hecaojuanjuan/gesture-bridge/artifacts/user-guide/gesture-bridge-user-guide-v2.png

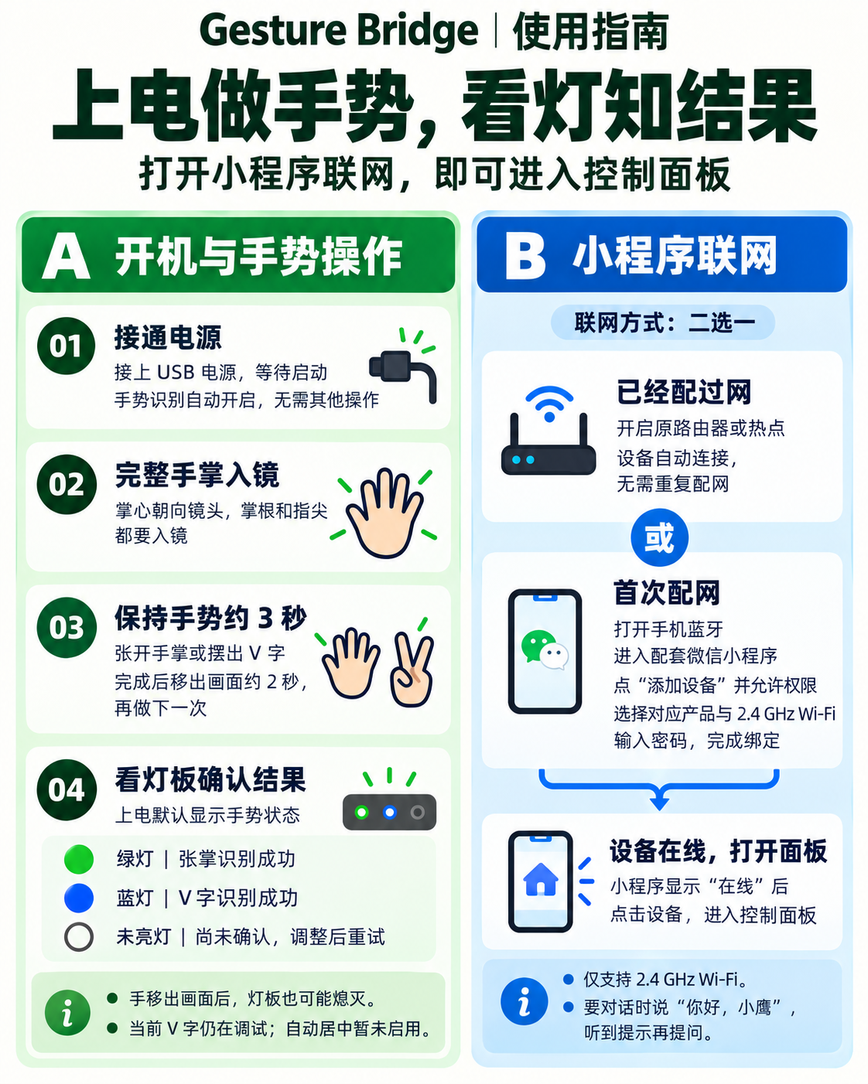
artifacts/user-guide/gesture-bridge-user-guide-v2.png
