hecaojuanjuan/gesture-bridge/artifacts/user-guide/device-startup-guide-20261101.png

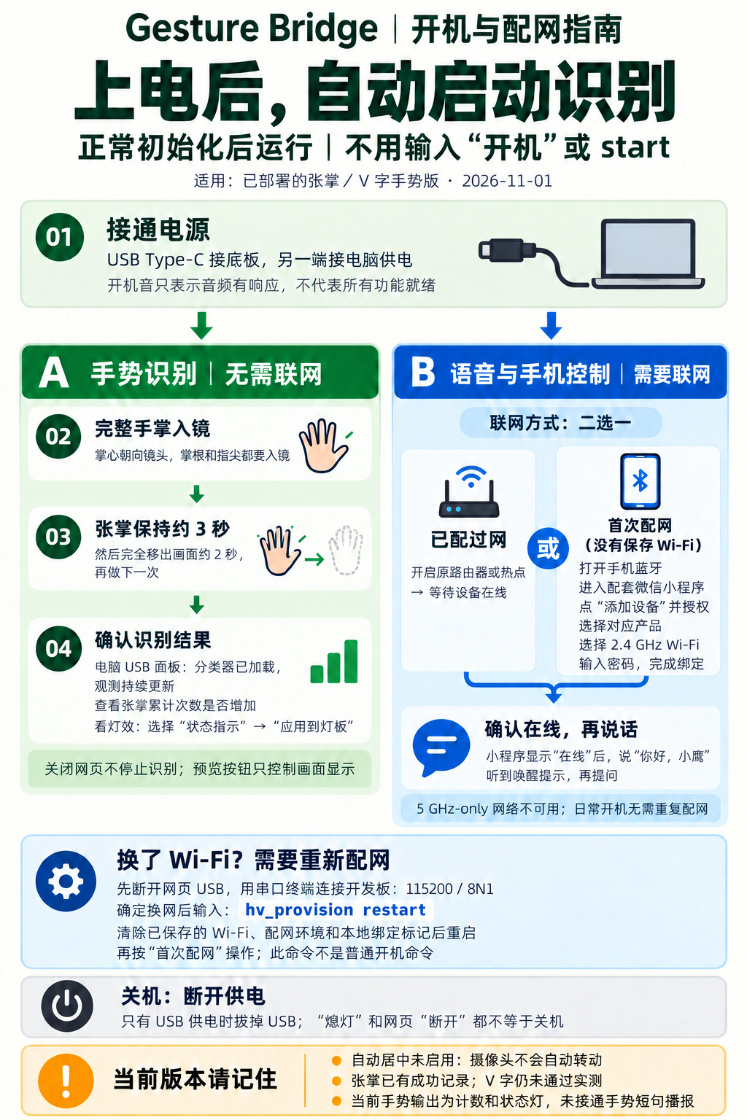
artifacts/user-guide/device-startup-guide-20261101.png
