hecaojuanjuan/gesture-bridge/tools/requirements-hand-training.txt

# Isolated Python 3.9 environment for the current hand-classifier pipeline.
# Keep NumPy below 2 for the Torch 1.12 NumPy ABI; do not change the IDF venv.
torch==1.12.0
numpy==1.26.4
Pillow==11.3.0
typing-extensions==4.16.0
