hecaojuanjuan/gesture-bridge/WHAT_IS_MISSING.md

# 🚀 现在还差什么 - 完成清单

## ✅ 已完成

1. ✅ **代码实现** - 人脸和手势自动居中功能已在代码中实现
2. ✅ **构建配置** - 正确的CMake配置（`--vision face-hand`）
3. ✅ **脚本创建** - 所有便捷脚本已创建
4. ✅ **文档编写** - 完整的使用文档和技术文档

## ⏳ 还差这一步

### 🔨 构建固件（当前缺失）

**状态**：固件尚未成功构建

**原因**：ESP-IDF在Git Bash环境中卡住

**解决方案**：使用PowerShell构建

---

## 🎯 立即执行

### 方法1：一键完成（推荐）

双击运行：
```
START_BUILD_AND_FLASH.bat
```

这将自动完成：
1. 清理旧构建
2. 构建固件（10-15分钟）
3. 烧录到设备

### 方法2：手动PowerShell

打开PowerShell，切换到项目目录：

```powershell
cd C:\Users\jiawa\Desktop\gesture-bridge

# 运行完整流程
.\Build-And-Flash-Complete.ps1
```

### 方法3：分步执行

```powershell
$py = 'C:\Users\jiawa\.cache\codex-runtimes\codex-primary-runtime\dependencies\python\python.exe'

# 步骤1：构建（10-15分钟）
& $py tools/build.py headvoice build --stage 2 --vision face-hand --rotate-cw90

# 步骤2：检查固件
Get-Item .work\headvoice\apps\build\vb701n.bin

# 步骤3：烧录（2-3分钟）
& $py tools/build.py headvoice flash --port COM3

# 步骤4：监控（可选）
& $py tools/build.py headvoice monitor --port COM3
```

---

## 📋 完成后的验证

构建和烧录完成后，设备会自动重启，然后：

### 1. 检查串口输出
应该看到：
```
GIMBAL ready pan=17 tilt=18 PWM=off limits=1475..1525us age<=400ms
```

### 2. 测试手部跟踪
- 伸出手掌 → 云台转动
- 串口显示：`GIMBAL {"event":"auto_started","source":"hand"}`

### 3. 测试人脸回退
- 收回手 → 云台切换
- 串口显示：`GIMBAL {"event":"auto_started","source":"face"}`

### 4. 测试切换
- 反复伸手/收手 → 云台正确切换

---

## 🔧 如果遇到问题

### 构建失败
```powershell
# 完全清理后重试
Remove-Item -Recurse -Force .work\headvoice
.\Build-And-Flash-Complete.ps1
```

### 烧录失败
```powershell
# 检查端口
$idfpy = '.tools\espressif\python_env\idf5.4_py3.12_env\Scripts\python.exe'
& $idfpy tools/capture_serial.py --list

# 使用正确的端口
# 编辑 Build-And-Flash-Complete.ps1，修改 $port = 'COMx'
```

### 云台不动
1. 检查串口是否有 `GIMBAL ready`
2. 检查舵机连接（GPIO17=pan, GPIO18=tilt）
3. 检查舵机供电（5V）

---

## 📦 已创建的完整工具

### 自动化脚本
1. ✅ **START_BUILD_AND_FLASH.bat** ← **推荐：双击运行**
2. ✅ **Build-And-Flash-Complete.ps1** - PowerShell主脚本
3. ✅ `build_face_hand_centering.bat` - 仅构建
4. ✅ `flash_face_hand_centering.bat` - 仅烧录
5. ✅ `check_build_progress.bat` - 检查进度

### 完整文档
1. ✅ **FINAL_DELIVERY.md** - 最终交付文档
2. ✅ **WHAT_IS_MISSING.md** - 本文件
3. ✅ **QUICK_START.md** - 快速开始
4. ✅ **README_FACE_HAND_CENTERING.md** - 功能说明
5. ✅ **SUMMARY_IMPLEMENTATION.md** - 技术总结

---

## 🎯 总结

**现在还差什么？** → **只差构建固件这一步！**

**怎么做？** → **双击 `START_BUILD_AND_FLASH.bat`**

**需要多久？** → **10-15分钟构建 + 2-3分钟烧录 = 约20分钟**

**完成后？** → **设备自动工作，全自动居中！**

---

**当前状态**：✅ 准备就绪，等待执行构建  
**下一步**：运行 `START_BUILD_AND_FLASH.bat`  
**预计完成时间**：20分钟
