hecaojuanjuan/gesture-bridge/docs/control-panel.md

# RGB 控制面板与上板验证

2026-11-01 最新页面结构：保留 [USB 手势表达工作台](usb-gesture-workbench.md)，同时恢复截图中的[图卡建库与我的词典](gesture-dictionary-panel-design-2026-11-01.md)。`index.html` 是设备控制，`setup.html#setup` 是建库，`setup.html#dictionary` 是本机演示词典，三个入口使用统一导航。本次仅本地面板改动，未发布 H5，未操作硬件。

同日较早变更：用户要求删除本页所述旧灯光设备控制台，改由 USB 实机工作台处理真实词典写入、回读和 Agent 回复；当时 `setup.html` 转到首页，该重定向已被上述恢复方案取代。下文保留旧灯光面板与已发布 H5 的历史证据，不代表当前本地页面。

2026-11-01 后续核对：用户要求只保留最新版时，平台列表中的 v3 已显示“发布”；本轮未执行发布操作。v1、v2 仍在列表，三个版本的操作栏均只有“下载”，当前页面没有删除、归档或停用入口，因此未移除旧版本，也未验证手机实际使用版本。

2026-11-01 上传补记：最新源码重新通过 100 项前端测试、生产构建和 ZIP 完整性检查后，已上传至奶龙 PID 11785，H5 版本 **3**，备注“手势建库设计预览与手部诊断”，平台上传时间 **12:15:50**。列表状态为“开发中”，本次未点击“发布”；不代表手机已切换到 v3。包内含原设备页和 `setup.html` 建库原型，真实采集、设备词典和播报接入边界不变。证据见[上传清单](../artifacts/panel-h5-v3-upload-20261101.json)。

2026-11-01：新增独立[手势建库交互原型](gesture-dictionary-panel-design-2026-11-01.md)，入口为 `panel/setup.html`。图卡选意、照护者文字填写、模拟录入、核对及本机演示词典可交互；尚未接入真实摄像头录入、设备词典写入、ASR 或设备播报。100 项前端测试和生产构建通过；未发布灵机 H5，不改变下文实机验收边界。

2026-10-31：本地源码已加入 USB 手部诊断和模型输入 JPEG 预览，当前 native 手势目标为**张开手掌和 V 字**。对应固件与模型已部署，新增面板功能仍为本地版本，尚未发布到手机或完成实机识别验收。手势模型、采样与设备测试步骤见[手势测试清单](hand-gesture-tests-2026-10-31.md)；自动居中优化暂缓。

此前发布记录：奶龙 PID **11785** 的 `headvoicePanel` 已创建并审核通过（功能版本 2）。H5 面板 **v2 已上传并发布**，平台上传时间 16:05:54，备注“USB诊断与重启状态修复”，证据见[发布清单](../artifacts/panel-h5-v2-release-20261031.json)。该包包含当时的 USB 画面、被动姿态诊断和 ROM 重启后撤销旧回执确认的修复，47 项前端测试及构建通过；这些历史结果不证明本地新增手部功能已发布。手机 v2 加载、云端写灯控和实机重启恢复仍待验证。此前 v1 的手机加载/云端 get、stage 1 的桌面 USB 灯控和实物灯效已确认。

## 已实现的操作

- 状态指示、自选颜色、熄灯三种模式；自选颜色支持 RGB 与亮度。
- “应用到灯板”发送设置，等待设备返回相同请求编号与实际设置。没有回执、超时或驱动报错时不会显示执行成功。
- “试灯 5 秒”由设备计时：红、绿、蓝、白、灭各 1 秒，随后恢复原模式；网页关闭不会让试灯永久持续。
- USB 串口与灵机官方 H5 SDK 两种传输。普通浏览器只能使用 USB；云端入口需要灵机 App / 小程序的设备上下文。
- 姿态诊断显示固件阶段、二维眼线倾角、检测目标数、推理耗时及设备报告帧龄。本地 USB 面板被动接收 `HV pose`，另外显示本页最近接收时间；云端使用属性快照。单帧帧龄不能代替 30 秒连续输入验收。
- 手部诊断被动接收 `HG observation`，显示候选手数、单手检测有效性、检测分数、分类器加载状态、原始分类候选、推理耗时与帧龄。检测有效不等于分类成功；`classifier_ready=false` 时不会显示识别成功或分类灯效。
- 设备固件的 HP 快照曾遗漏 epoch 有效性：可能把核心拒绝的眼点显示为有效。修复通过回归与编译后已随[当时的自检固件](../artifacts/headvoice-face-selftest-eligibility-20261031.json)上板，真实失效/恢复边界仍待验收；H5 v2 发布本身不会更新固件。当前手机灯控可独立验收，姿态有效性以 USB `HV pose` 与时序分析为准。
- 摄像头支持 USB 单帧获取和自动刷新，校验完整后显示实际画面；提供停止、接收进度、接收时间和耗时。此功能不会启动姿态模型，也不会上传图像。

默认状态模式、亮度 20%；重启恢复默认。面板 100% 对应 PWM 上限 48/255，避免联调时全亮。颜色图形只是预览；设备驱动返回成功仍需目视确认灯板。

状态模式图例随已确认的诊断类型变化。HeadVoice 姿态 stage 3 为白色校准、黄色待确认、蓝色播放；native 手部应用为已确认张掌绿色、已确认 V 字蓝色。旧三分类手部应用仍为张掌绿色、握拳蓝色；未加载分类器、未知后端或未确认类型时不承诺手势灯效。图例描述固件规则，实际状态输出仍需新鲜有效观测及完成保持条件。自选颜色和熄灯由面板独立控制。

面板没有重置配网、恢复出厂、动作播报、云台移动或 IMU 融合按钮。

## 本地手部诊断与验收边界

native 观测以 `classifier: "espdl_gesture11"` 标识。11 项 `scores` 的固定顺序是 `one,two,three,four,five,like,ok,no_gesture,call,dislike,no_hand`；`five` 显示张掌、`two` 显示 V 字，其余均标为非目标，不把点赞或握拳作为当前第二目标。native 模型输出 logits 经设备端 softmax 转为概率；面板验证每项范围、总和与原始最高分类，保留六位小数的打印误差，不重新归一化。

“分类原始候选”只描述单帧输出，既不代表完成保持，也不代表灯圈已实际变色。设备的 `HG gesture` 完成事件使用 `open_palm` / `v_sign` 与 `palm_count` / `v_count`；本地诊断页不会把原始候选或残留 `gate_latched` 当成新完成事件。旧检测版没有 `classifier`、`classification_valid` 或分类分数也可显示检测信息；旧三分类版保持张掌／握拳语义。

本地 USB 页新增“设备本次启动累计”，读取设备的张掌／V 字累计值（旧模型为张掌／握拳）；持续保持不会由页面重复计数。缺少字段时显示“设备未提供累计计数”，过期时标为“最近收到的累计值”；重启、断线、取图、后端切换或计数回退会清空显示并等待重新确认。云端仍不提供这些手部累计值。

USB 先收到匹配的设备回执，再接受其时间屏障之后的诊断帧。重启、断线、采样轮次变化、序号或采集时间回退会清除旧观测并重新等待回执。设备帧龄加本页接收后经过时间超过 600 ms 时，原始候选清空并标为过期；串口传输延迟未计入，不能据此证明端到端实时性。取图期间暂停诊断展示，取图结束后通过新回执重新确认。

旧云端 HP 属性未包含手部后端及 HG 分类流。页面不会仅凭 stage 2 推断手部分类器已启用；仍可显示兼容的姿态快照，并明确云端无法判断手部模型状态。本轮未扩展云端协议。

本地手部、JPEG 和生命周期回归已有 81 项前端测试通过，生产构建通过；本轮概率和校验收紧后，另运行手部与生命周期专项 31 项测试及生产构建，均通过。

随后新增累计显示的手部解析 16 项、生命周期 28 项测试及生产构建通过。累计显示的离线浏览器复核因用户切换页面保护中止；下述此前浏览器通过记录不包含该项。用户已暂停功能改进，当前仅归档源码与验证记录。

native 固件（SHA256 前缀 `d14fa905`）及固定模型已写入设备并校验一致，见[部署清单](../artifacts/headvoice-hand-palm-v-native-20261031.json)。[25 秒启动探测](../artifacts/hand-native-startup-20261031.json)收到 66 条 native 观测，确认分类器加载及 7 次有效分类输出，未见匹配的故障日志；这轮没有独立手势标签，不能据此判定张掌／V 字准确率或长期运行稳定性。

[Chrome 离线浏览器验证](../artifacts/panel-native-jpeg-browser-qa-20261031.json)已通过真实 JPEG 解码与显示、旧 HVCAM 回退、legacy/native11 候选和未加载状态、暂停过期、重启及断开清空。该验证使用虚拟串口与合成观测，没有连接真实 USB。仍待完成张掌／V 字及非目标对照准确率、持续运行的内存与帧龄、新手部诊断与 JPEG 的实机浏览器联调、状态灯目视一致性，以及新版 H5 上传与手机端加载。

## 摄像头画面

桌面 Chrome 打开本地面板，连接开发板 USB，待“设备已响应”后点击“获取画面”。“自动刷新”在一帧接收完毕后等待至少 3 秒再取下一帧；“停止刷新”停止后续请求，已经开始的传输会收完。切到其他页面也会停止自动刷新，重新进入时不会自行开启。断开连接或确认设备重启后清除画面。

stage 1 和 face stage 2 应用的原有 `hv_camera snapshot` 路径保持兼容：图像为 120×160 RGB565LE，按装配旋转后显示 160×120；此前浏览器取帧约 7.4–7.5 秒，face stage 2 的一次取帧约 8.9 秒，不是实时视频。已确认 USB 手部诊断后，本地面板改用 `hv_camera inputjpeg`，获取手部模型实际输入方向的 JPEG，尺寸以设备报文为准；未知或姿态后端仍用旧 snapshot。画面时间标注为接收时间，而非曝光时间。旧图保留时持续显示接收距今时间，损坏或未完整校验的帧不会覆盖旧图。

摄像头与灯光共用一个 Web Serial 连接。图像传输期间本页暂停设置、试灯及状态查询；设备状态灯和已启动的试灯计时继续运行。传输结束后自动查询状态并恢复本页控制，避免额外串口回显干扰图像。解析检查 BEGIN、连续偏移、块长、帧长及 FNV-1a；JPEG 另校验解码尺寸。超时 25 秒、丢块、校验失败、重启或断线会取消本帧；断线或重启后迟到的 JPEG 解码也不会覆盖页面。协议没有请求编号，失败后必须点击“断开”再重新连接，避免把迟到数据用于下一帧。

此版本仅支持桌面 USB 画面。本地灵机 H5 SDK 的设备快照接口返回属性数据，未发现可直接使用的摄像头视频请求接口；云端连接会禁用画面按钮并说明限制。图像只在当前页面内存中保留，不进入云端属性、打包文件或测试 JSON。验收截图含实际拍摄内容，仅保存在 Git 忽略的 `.local/`。

2026-10-31 实测单帧获取、连续自动刷新、停止后不再获取、断开清画面与灯控恢复均通过。39 项前端测试及生产构建通过；记录见 `artifacts/panel-camera-validation-20261031.json`。这是此前本地预览验收；后续功能随 H5 v2 发布，手机端仍没有 USB 图像传输能力。

## 平台与设备协议

`panel/protocol.json` 是 H5 与构建脚本共用的映射。平台产品页内部路径中的 `1531` 不是 PID。

| 服务 / 属性 | 标识 | 类型与权限 |
| --- | --- | --- |
| headvoicePanel | SIID 12 | 自定义服务 |
| Command / 面板指令 | PIID 1 | String，最长 96，只写，不支持语控 |
| Report / 设备回执 | PIID 2 | String，最长 640，只读，不支持语控 |

指令为 ASCII 字符串，请求编号范围 1–999999999：

```text
101 get
102 set 1 20 80 190 255
103 test
104 set 2 20 80 190 255
```

`set` 参数依次是模式（0 状态 / 1 自选 / 2 熄灯）、亮度 0–100、R/G/B 各 0–255。固件串口前缀为 `hv_panel`，例如 `hv_panel 101 get`；串口回执前缀为 `HP `，云端 Report 只含 JSON。

回执包含协议版本、设备启动编号、请求编号、驱动结果、设备运行时间、模式、颜色、输出、剩余试灯时间及姿态诊断。控制队列最多 4 条；非法指令或队列满不会执行。H5 同时只允许一个请求，10 秒超时，不自动重发设置/试灯；8 秒轮询，15 秒没有确认回执则禁用控制。未匹配的云端快照不能确认执行，也不能覆盖已显示的回执。

USB 检测到 ROM 启动标记时，立即撤销旧连接确认、取消旧请求并清除画面和姿态。随后最多 20 秒只重试 `get`；旧 boot 的缓冲回执和已取消请求都不能恢复“已同步”，必须收到新 boot 的匹配回执。重启前尚未确认的写入结果保持未知，不自动重发。

2026-10-31 此路径的主机回归覆盖旧 `get/set/test` 取消、旧 boot 与迟到编号拒绝、首个新查询丢失后恢复；47 项前端测试及生产构建通过。本地 H5 ZIP 已重新生成并确认包含新版被动诊断与重启保护，哈希见 `artifacts/panel-build-summary.json`；这些检查不代表新版包已完成手机或设备重启实测。

## 构建面板

使用兼容 Vite 8 的 Node.js（本机验证为 24.22.1）：

```sh
npm --prefix panel ci
npm --prefix panel test
npm --prefix panel run build
python3 tools/package_panel.py
npm --prefix panel run dev
```

上传包为 `artifacts/headvoice-panel.zip`，根目录含 `index.html`、`app.json`、`assets/`；不包含固件、产品密钥或源代码。哈希见 `artifacts/panel-build-summary.json`。官方 H5 SDK 来源见 `panel/vendor/README.md`。本机预览使用终端显示的 localhost 地址。

## macOS 固件构建

构建复用经过提交号及工作树校验的官方 SDK，不修改 SDK 本身：

```sh
export HEADVOICE_SDK="/Users/emt/Workspace/hackathon/ljyd_xjwb03_agent_public_developer"
export IDF_TOOLS_PATH="$PWD/.tools/espressif"
# 新机器首次安装官方工具；已有环境无需重复。
python3 "$HEADVOICE_SDK/esp-idf/tools/idf_tools.py" install xtensa-esp-elf esp-rom-elfs cmake ninja
python3 "$HEADVOICE_SDK/esp-idf/tools/idf_tools.py" install-python-env
# 仅在需要关闭推理做隔离对照时构建 stage 1；不用于 native 手势部署。
python3 tools/build.py headvoice build --stage 1 --rotate-cw90
```

本机 Apple Python 3.9.6 的 `importlib.metadata` 无法识别新版 `ruamel.yaml` 的规范化包名，已在项目虚拟环境固定 `ruamel.yaml==0.18.6`、`ruamel.yaml.clib==0.2.8`。可在新机器使用 Python 3.12 创建 IDF 环境。本机产品身份在 Git 忽略的 `.local/cloud.json`，不要把密钥复制进面板或文档；缺少身份时构建会使用 SDK 示例 PID，烧录前必须核对。

## 接线后验证顺序

1. 断电接线：官方 8 灯 WS2812 的 DIN 接 GPIO1、5V 供电并共地；BF3901 使用 3.3V，接线沿用 README。MPU6050 默认 SDA8 与摄像头 D0 冲突，暂不按默认示例同时连接。
2. 枚举真实 USB 串口并关闭其他占用程序，先核对当前固件的启动日志及后端，不能凭旧记录假定板上仍是 face 应用。若需烧录，按对应镜像清单核对版本、分区与哈希；native 手势应用需单独核对模型分区及备份，禁止通过通用整包烧录覆盖原模型资产，详见手势测试清单。面板验证本身不要求重写 NVS。
3. 用本地面板连接 USB，先读取回执，再测试自选颜色、亮度、熄灯、5 秒自动恢复、断开及重新连接。记录目视灯效与回执是否一致。
4. 手机进入奶龙设备页，继续测试设置、试灯、断网、超时和重连。手机加载与云端 `get` 已确认，但不能替代写操作和真实灯效验收。
5. 当前手势目标按[手势测试清单](hand-gesture-tests-2026-10-31.md)验证张掌、V 字、其他手型与无手对照，分别保存原始日志和目视灯效。历史 stage 1 采集及 face stage 2 预览已有实测，不替代 hand JPEG 与新分类器验收。下述 `pose_readiness` 只用于旧姿态后端；手部流不使用姿态时序阈值。

```sh
python3 tools/pose_readiness.py artifacts/本次采集.jsonl
```

时序检查要求同一连续片段至少 30 个有效追踪观察、覆盖至少 30 秒；各帧帧龄不超过 400 ms，且相邻结果满足 `captured_ms[i] - captured_ms[i-1] + age_ms[i] <= 400`，保证下一结果到达前上一帧未被生产 core 判为过期。不能只分别检查帧龄和采集间隔，也不能跨重启、时间倒退或显式失效片段合并样本与时长；未换行的尾片段不计入资格。这个检查不证明中立稳定性或动作准确率。2026-10-26 的 27 个历史观察推理中位数 2676 ms、结果帧龄中位数 2721 ms、有效输入 0；它属于旧后端记录，不代表当前 face 性能。stage 3 真人组合、确认与播报仍待验收，400 ms 保护保持不变。

保持完成后经 9–14° 缓慢回正的状态丢失已修复；双方向、未完成保持、超时及失效帧有生产 C 回归覆盖，真人效果待复测。IMU 安装取舍见 [六轴用途](imu-options.md)。

## 10/31 实机状态补充

手机此前已确认 H5 v1 加载并显示设备响应，串口也记录云端 `get` 与匹配回执。早期 COCO stage 2 在联网运行期间反复 panic；当时的 80 MHz 内存配置、自检和堆检查未消除故障，不能认定是热点问题。该历史负结果不代表当前 face stage 2 的表现，见 `artifacts/panel-stability-20261031.json` 与 `docs/validation.md`。关闭姿态推理的 stage 1 首轮协议对照时灯圈未接；随后用户明确接好灯圈和 USB，完成下述实测。

桌面 Chrome USB 面板已验证连接、湖蓝 20%、薄荷 30%、试灯 5 秒后恢复、熄灯、断开时禁用按钮及重新连接读取设备状态。用户确认蓝色常亮、红绿蓝白灭顺序，以及恢复薄荷绿和熄灭均正常。两轮串口脚本也通过命令回执、交错查询去重和恢复检查。自动脚本中的初始蓝色仅持续约 62 ms，不能要求使用者据此判断蓝色是否正常；已用面板常亮另行确认。

实测发现预览区“待应用”为静态文本，已改为依据新鲜匹配回执显示“已同步”，发送设置期间显示“等待回执”；20 项现有前端测试和构建通过，重连后在真实设备上观察到“熄灯／已同步”。证据见 `artifacts/panel-wired-validation-20261031.json`。该次验收时修复仅用于本地，后续已随 H5 v2 发布；手机云端设置/试灯、长期稳定性和实时姿态仍未验收。本轮未烧录或发送云台运动指令，结束时设备保持熄灯。

当前生成配置采用 Flash/PSRAM 80 MHz，并保留启动内存自检和轻量堆检查；这是诊断配置，不代表已确认根因。设备保留最近 8 条写操作编号，交错的状态查询不会让重试的试灯重新计时。
