hecaojuanjuan/gesture-bridge/artifacts/enclosure-milk-egg-v2/打印说明.txt

奶蛋圆润外壳 v2

gesture-bridge-milk-egg-v2.3mf：整套打印排版，含底盒、顶盖和两片可选小模块托片。
milk_egg_body.3mf：底盒单件，168×128×41 mm。
milk_egg_lid.3mf：顶盖单件，163.2×123.2×4 mm。
milk-egg-preview.png：由实际网格生成的配色与装配预览。
validation.json：网格、重新导入及原结构兼容性检查结果。

造型：奶白鼓腹侧壁、奶黄圆润顶盖。底盒底面与顶部仍以原160×120 mm轮廓为基准，中部外扩到168×128 mm。合盖高度45 mm；不含上层外露云台和摄像头。外扩位于原壳外侧，未侵入原内部空间。

保留：原四角孔位，顶盖Ø3.4 mm、底盒Ø2.7 mm导孔；中央108×92 mm云台口；31×28 mm喇叭口；Ø7.6 mm麦克风孔；底部安装槽及侧面、背面检修通道。侧壁开口延伸穿透新增曲面。

切片：单位毫米，按100%比例导入。整套排版约336×181 mm，常见较小平台请分盘打印，或直接打开单件文件。底盒和顶盖均已平放在Z=0。先用0.2 mm层高、至少3圈外壁试切片；按机器能力检查桥接及局部支撑。

颜色：文件带奶白和奶黄外观颜色。实际耗材需在切片软件选择；可以单色打印，也可以将两件分别使用不同颜色耗材打印，无需多色打印机。

装配：沿用旧版四角螺钉方式。Ø2.7 mm导孔并非现成M3机牙螺纹，可先试用适合塑料的约3 mm直径、总长约10 mm自攻螺钉，先试孔。顶盖套装路径与旧版相同，必要时先拆摄像头上层支架。

验证：各零件封闭、绕序一致、正体积且单一连通；实际3MF经独立导入器重新导入通过。布尔比较确认原有材料无实质移除（残差小于0.001立方毫米），新侧壁没有侵入原外壳包络内，装配无体积重叠。

边界：这是基于原模型的几何适配版。真实主板占地、插头高度、喇叭厚度、RGB灯板安装位置和云台全行程仍未量齐，尚未进行实物试装；宽裕检修口用于保留调整余地。先试装核对，不将网格通过当作硬件装配已验证。

生成源文件：tools/generate_milk_egg_enclosure.py，依赖原tools/generate_enclosure.py和.tools/cad。可使用Codex捆绑Python 3.12（含numpy/Pillow）运行。
