hecaojuanjuan/gesture-bridge/docs/gesture-dictionary-panel-design-2026-11-01.md

# 手势建库控制面板：交互原型 v1

## 2026-11-01 后续：保留当前工作台并恢复旧版建库

用户提供旧版截图，明确要求保留当前设计并将截图中的设计加回来，允许分页面。本地面板据此保留 `index.html` 的 USB 实机工作台，恢复 `setup.html` 的图卡建库，不再将其重定向到首页。

三个导航入口为“手势建库 / 我的词典 / 设备控制”。`setup.html#setup` 显示建库流程，`setup.html#dictionary` 可直达词典；`index.html` 保留设备绑定、手势观测、Agent 回应和摄像头诊断。桌面侧栏与手机顶部导航沿用截图的浅绿配色和颔语品牌，保留插画图卡与大字模式。

图卡页继续标注“本机演示”：三次采集为模拟流程，词条仍使用 `headvoice:dictionary-prototype:v1` 存于浏览器，没有自动同步到设备。真实含义仍须在“设备控制”页写入并回读。这次恢复不改变设备识别、语音和老人可用性的既有验收边界；没有烧录或发布 H5。

本次浏览器检查：1440×1000 桌面与 390×844 手机尺寸下，设备页、图卡选意、模拟录入、词典及大字模式均无横向溢出。走通“喝水图卡 → 张掌 → 三次模拟采集 → 核对 → 保存 → 词典刷新恢复”；未核对时保存按钮禁用。另确认 hash 前进/后退的标题与视图一致、重复张掌绑定被阻断、编辑回到建库，以及采集中切到词典再返回时样本数保持 0，取消的采集不会补记为完成。

本次截图：[桌面设备控制](../artifacts/panel-combined-20261101/device-desktop.jpg)、[桌面建库](../artifacts/panel-combined-20261101/setup-desktop.jpg)、[桌面词典](../artifacts/panel-combined-20261101/dictionary-desktop.jpg)、[手机大字模式](../artifacts/panel-combined-20261101/setup-mobile-large.jpg)。这些检查覆盖前端交互和布局，不替代真实设备或目标使用者验收；核查窗口未记录到 console warn/error。

本次 `npm --prefix panel test`：118 项通过。新增导航回归使用 VM 和虚拟传输，覆盖等待 USB 关闭后跳转、连接/写入/读取/取帧忙时阻止切页、修饰键和新标签保留原生行为，以及离页停轮询、恢复后不自动连接或重发写入。真实 USB 离页切换未在本轮重测。

`npm --prefix panel run build` 通过，输出 `index.html` 和 `setup.html` 双入口；`python3 tools/package_panel.py` 打包成功。ZIP CRC 检查及入口、`app.json`、建库 JS 资源检查通过，`git diff --check -- panel docs` 无问题。包为 41,067 字节，SHA256 为 `17b18515a332e8482263682b1e3b692d14072964032bdc244015b39cf370b3d4`，详见[构建清单](../artifacts/panel-build-summary.json)。构建保留工作区同期的单次识别等修改，这些不归入本次设计成果；本轮未编译或部署固件。

## 原型初版与平台历史

2026-11-01 后续核对：用户要求只保留最新版时，平台列表中的 v3 已显示“发布”；本轮未执行发布操作。v1、v2 仍在列表，三个版本的操作栏均只有“下载”，当前页面没有删除、归档或停用入口，因此未移除旧版本，也未验证手机实际使用版本。

2026-11-01。用户明确：面向有语言表达障碍的老人，手势含义在首次建库时确定，此后固定复用；监护人可以用语音协助建库，也需要无需老人说话的建库入口。本轮请求是设计一版控制面板。

同日上传补记：按用户后续要求，已将最新面板上传至灵机一动奶龙 PID 11785，H5 版本 3，备注“手势建库设计预览与手部诊断”。平台上传时间 12:15:50，列表状态“开发中”，未点击发布；手机加载尚未验证。上传前重新运行 100 项前端测试、生产构建及 ZIP 完整性检查，均通过。见[上传清单](../artifacts/panel-h5-v3-upload-20261101.json)。下文保留设计阶段的实现与验收边界。

## 页面与交互

入口为 `panel/setup.html`，原设备面板顶部增加“手势建库 · 设计预览”。沿用颔语的浅绿底色与深绿操作按钮，使用本地 SVG 图卡，不加载外部字体或图片。桌面为导航、建库步骤、绑定摘要三栏；手机使用顶部导航和两列图卡。

1. 选择含义：六个完整句子图卡、照护者文字填写、浏览器朗读请求、逐项轮播；轮播由按钮或空格键选择，尚未接入手势选择。提供“都不是／暂不设置”。
2. 录入手势：张掌或 V 字、三次模拟采集、重新采集、返回。始终标注示意画面和模拟样本，没有摄像头调用、真实样本保存或模型训练。
3. 确认绑定：展示手势与完整原句；显式核对后可保存演示词条。点击核对不记为老人本人确认。
4. 我的词典：刷新恢复、朗读入口、编辑、删除确认；编辑需要重新完成演示录入与核对。同一手势不能同时绑定两条词义，不静默覆盖。

朗读使用浏览器 SpeechSynthesis，只在用户点击后请求，实际出声未听测。照护者 ASR、设备语音输出和真正的词典协议均未接入。原设备控制页继续使用原来的 USB/云端接口，新页面没有导入这些连接模块。

## 数据边界

本机原型使用独立存储键 `headvoice:dictionary-prototype:v1`，全部词条保存为 `status: demo`。保存前重新读取存储并校验手势冲突；损坏或不可用的存储显示错误，不宣称保存成功。其他标签页更新后取消旧核对状态。离开页面或切换功能时停止轮播和待完成的模拟采集。

真实系统仍需设计设备词典写入、版本和回执，并验证识别、语音并行、老人可用的确认方式。手势分类器的历史准确率、V 字负结果和暂停点不因本次 UI 原型改变。本轮没有操作硬件、烧录固件、修改平台智能体或发布灵机 H5。

## 实际验证

- `npm --prefix panel test`：100 项通过，包括新增 6 项演示词典保存约束和存储错误测试。
- `npm --prefix panel run build`：通过，产物同时包含 `index.html` 与 `setup.html`。
- 真实浏览器：图卡选择、三次模拟采集、未核对时不能保存、保存后刷新恢复、同手势冲突阻断、照护者填写、空格键轮播选择、编辑重新采集、取消删除均已核对。
- 响应式：1440px 桌面与 390px 手机宽度；手机大字模式和录入页没有横向溢出。浏览器核查窗口未记录到 warn/error。
- 截图位于 `artifacts/panel-design/`：桌面选意、录入、确认、词典、手机大字模式。

这些是前端原型检查，不是老人可用性测试、临床评估、真实手势采集或设备端验收。

## 本地查看

```sh
cd /Users/emt/Workspace/hackathon/gesture-bridge
npm --prefix panel run dev -- --port 4175
```

打开 `http://127.0.0.1:4175/setup.html`。新建词条只影响此浏览器的演示词典；普通刷新不清除已保存词条，未保存的步骤会重置。
