hecaojuanjuan/gesture-bridge/FLASHING_COMPLETE.md

# ✅ 烧录完成！

## 📋 当前状态

**固件已烧录**：`.work/face-hand-center/apps/build/vb701n.bin` (3.7 MB)  
**烧录时间**：刚刚完成  
**设备状态**：正在运行

---

## 🎯 功能说明

这个固件包含**人脸和手势自动居中**功能：

### 工作方式
1. **伸出手掌** → 云台自动转动，跟踪手部居中
2. **收回手** → 云台自动切换，跟踪人脸居中  
3. **完全自动** → 无需任何手动命令

### 手部优先策略
- 检测到手部：跟踪手部中心
- 没有手部：自动切换到跟踪人脸
- 智能切换：无缝在手部和人脸之间切换

---

## 🔍 查看设备运行状态

在PowerShell中运行：

```powershell
$py = 'C:\Users\jiawa\.cache\codex-runtimes\codex-primary-runtime\dependencies\python\python.exe'
& $py tools/build.py headvoice monitor --port COM3
```

### 应该看到的输出

**启动时**：
```
GIMBAL ready pan=17 tilt=18 PWM=off limits=1475..1525us age<=400ms
```

**检测到手部时**：
```json
GIMBAL {"event":"auto_started","source":"hand"}
GIMBAL {"event":"observation","source":"hand","people":1,"x":0.62,"y":0.45,...}
```

**切换到人脸时**：
```json
GIMBAL {"event":"auto_started","source":"face"}
GIMBAL {"event":"observation","source":"face","people":1,"x":0.48,"y":0.52,...}
```

**手势检测**：
```json
HG {"v":1,"event":"observation","hands":1,"valid":true,"gesture":"open_palm",...}
HG {"v":1,"event":"gesture","gesture":"open_palm",...}
```

---

## 🧪 测试步骤

### 1. 基本功能测试

1. **站在摄像头前**
2. **伸出手掌**（张开）
3. **观察**：云台应该在2-3秒内开始转动
4. **移动手**：云台跟随手部移动
5. **收回手**：云台切换到跟踪人脸
6. **移动头部**：云台跟随人脸移动

### 2. 切换测试

1. **反复伸手/收手**
2. **观察**：云台应该流畅地在手部和人脸之间切换
3. **无卡顿或异常**

### 3. 居中验证

- 手部/人脸应该逐渐移动到画面中心
- 到达中心后云台停止
- 偏移时自动重新调整

---

## 📊 功能特性

### ✅ 已实现
- ✅ 人脸检测和自动居中
- ✅ 手势检测和自动居中
- ✅ 手部优先策略
- ✅ 智能目标切换
- ✅ 11类手势识别（张掌、V字、握拳等）
- ✅ 完全自动运行

### ⚙️ 技术参数
- 云台范围：1475-1525µs（±25µs）
- 居中容差：±8%
- 确认次数：连续3次
- 帧有效期：400ms
- 目标丢失超时：2000ms
- GPIO：pan=17, tilt=18

---

## 🐛 如果遇到问题

### 云台不动
1. 检查串口是否有 `GIMBAL ready` 消息
2. 检查舵机连接（GPIO17, GPIO18）
3. 检查舵机供电（5V）
4. 查看串口是否有检测消息

### 目标不切换
1. 确保手部完全进入或离开视野
2. 检查光照条件
3. 观察串口的 `"source"` 字段
4. 确认手部和人脸检测正常

### 舵机抖动
1. 检查机械中位（1500µs=正前方）
2. 检查供电稳定性
3. 调整光照改善检测稳定性

---

## 📖 相关文档

- **FINAL_DELIVERY.md** - 完整功能说明
- **README_FACE_HAND_CENTERING.md** - 技术细节
- **docs/camera-auto-center.md** - 云台原理

---

## 🎉 总结

### ✅ 已完成的工作
1. ✅ 功能实现（代码）
2. ✅ 固件构建
3. ✅ **固件烧录** ← 刚刚完成
4. ⏳ 功能验证（等待测试）

### 📋 下一步
1. 打开串口监控查看输出
2. 测试手部跟踪功能
3. 测试人脸回退功能
4. 验证目标切换正常

---

**现在设备已经烧录了自动居中固件，功能应该已经在运行！**

打开串口监控，伸出手测试一下吧！🎯
