hecaojuanjuan/gesture-bridge/docs/HeadVoice_摄像头画面偏色排查与修复方案.docx

# HeadVoice 摄像头画面 偏色排查与修复方案

BF3901 与 ESP32 S3 | 2026 年 10 月 31 日

先定位偏色出现在哪一层，再修改对应转换或传感器配置。优先核对同一画面的普通预览与模型输入；两者同样偏色时，再用同一原始帧检查 UYVY 字节顺序和 YUV 转换，最后处理光照与白平衡。

目标是同时恢复预览颜色和模型输入颜色，并保留可复现的修复前后证据。画面看起来正常、串口校验通过和人脸识别通过，需要分别验收。

# 1 当前证据与诊断边界

项目 | 已核查结果 | 仍需验证
采集格式 | 日志与构建配置为 240×320 UYVY；完整帧 153600 字节。 | 实际色彩编码、量化范围与场景色彩准确度。
普通预览 | UYVY 转 120×160 RGB565LE；CW90 装配下显示 160×120。 | 偏色是否已经出现在采集或转换阶段。
模型输入预览 | 从实际 RGB888 输入取样，导出 RGB565LE；已旋转，rotation=0。 | 模型内部预处理后的张量及真实场景识别效果。
主机检查 | 本轮 Python／固件预览测试 13 项、浏览器解码测试 5 项通过。 | 真实传感器、白平衡、光照及端到端色彩。
官方样例自检 | 已有实机记录检出 1 张脸；该样例不经过摄像头 UYVY 路径。 | 摄像头输入与真人动作的准确性。

已有模型输入快照可见天花板与灯具，观感偏暖，但没有中性灰参照和同场景原始数据，不能据此确认白平衡或 U/V 顺序有误。[1][2]

## 两条图像路径

普通预览：BF3901 → UYVY → RGB565LE → 串口校验 → Python PNG 或浏览器 Canvas。

模型路径：BF3901 → UYVY → RGB888 与方向转换 → 模型预处理；诊断图在模型预处理之前取样，再压成 RGB565LE 导出。[3][4]

注意：现有两种 PNG 都经过颜色转换和 RGB565 量化，均不是原始 UYVY 转储。两条路径也共享 YUV 转换公式，因此两图一致不能证明共同上游正确。

# 2 先建立可比较的画面

## 固定现场条件

固定镜头与物体位置，用均匀的白色光源照亮灰卡或白纸，并同时放入红、绿、蓝色物体。避免彩灯照射、强逆光和高光过曝。每次只改变一个条件，记录光源、距离、固件 SHA 与取帧时间。白纸可做粗筛，不能替代标准色卡。

当前俯仰启动位置尚待校准。此次颜色排查保持云台 PWM 关闭，不运行 arm、jog 或 start。Chrome 面板和终端轮流使用 USB 串口；先停止自动刷新并断开 Chrome，再运行终端命令。

## 导出普通预览与模型输入

以下使用项目现有工具。先枚举端口，再将实际 CH343 端口填入 HV_PORT；命令会请求画面，但不发送舵机运动或灯光写入指令。

cd /Users/emt/Workspace/hackathon/gesture-bridge
HV_PY="$PWD/.tools/espressif/python_env/idf5.4_py3.9_env/bin/python"
"$HV_PY" tools/capture_serial.py --list
HV_PORT="/dev/cu.usbmodem实际编号"
mkdir -p .local/color-check-20261031

"$HV_PY" tools/camera_preview.py --port "$HV_PORT" \
--source camera --output .local/color-check-20261031/camera.png
"$HV_PY" tools/camera_preview.py --port "$HV_PORT" \
--source model --output .local/color-check-20261031/model.png

确认每次输出 checksum_verified=true。model 模式还必须收到 HVCAM SOURCE model；若报 no_model_input 或不支持该命令，先核对板上镜像与 stage，不能用普通预览替代模型输入。建议固定场景连续取 3 组并使用不同文件名。

两次命令取得的是不同时间的帧，只适合比较稳定的偏色现象。需要逐像素归因时，应新增“同一原始帧离线回放”，见下一页。普通快照需旋转，模型快照已旋转；不要二次旋转。

## 按结果选择下一步

观察结果 | 优先检查
Python PNG 正常，浏览器异常 | 将同一份 HVCAM 数据重放到两种解码器，核对 RGB565 小端、通道提取与 Canvas 写入；两端像素一致后再查显示环境。
普通预览异常，模型输入正常 | 检查普通预览的采样、RGB565 打包与显示路径。
普通预览正常，模型输入异常 | 检查 RGB888 生成、旋转索引、缓冲区生命周期及模型预览打包。
两种预览都异常 | 检查共享 UYVY 解析、矩阵／范围以及传感器与照明。
缺块、校验失败或空帧 | 先恢复完整取帧与传输，再进行颜色判断。

# 3 定位并修复软件转换

## 先核对数据契约

UYVY 的两个相邻像素按 U、Y0、V、Y1 存放，并共享 U/V。当前构建源码按此顺序读取，普通预览和 RGB888 转换都调用同一 yuv_to_rgb888。它使用 Y−16、U−128、V−128 及 298／409／100／208／516 整数系数，对应 BT.601 limited-range 转换。[5][7][8]

代码与 UYVY 声明一致，但格式名称不能单独证明实际传感器的量化范围。先核对当前寄存器表、驱动设置及原始样本，再决定是否调整矩阵或范围。不要把“画面偏暖”直接解释为 U/V 交换。

## 用同一原始帧做离线对照

这是建议新增的诊断能力，现有 CLI 尚未提供。保存一次完整的 153600 字节 UYVY 缓冲和格式、宽高、行步长、时间戳、checksum；在独立工作副本中实现，不修改 SDK 原始目录或只改临时构建产物。

在同一份原始字节上，先回放当前 UYVY＋BT.601 limited 配置，再按证据分别比较字节顺序、量化范围和矩阵候选。每轮只变一个因素；用灰阶及已知色块判断。先比较未旋转 RGB888，再单独核对旋转与 RGB565 量化，避免把不同采样位置误认为颜色差异。

证据 | 修复落点 | 复核方式
已知色块支持另一字节排列 | 统一传感器输出声明、实际寄存器序列与解包逻辑。 | 黑白灰与彩色像素对、奇偶像素及行边界一起验证。
实际输出范围与当前公式不匹配 | 在共享 YUV 转换层显式选择匹配的范围／矩阵。 | 灰阶亮度、色块色相、暗部与高光裁切均改善。
同一 HVCAM 数据两端解码不同 | 修复 Python 或浏览器 RGB565LE 解码。 | 同一输入两端 RGBA 的 RGB 分量一致。
只在 RGB888 或旋转路径异常 | 修复索引、通道顺序、步长或缓冲所有权。 | 非正方形带位置标记色块通过；避免只测纯色。

## 最小颜色向量

RGB565LE：红 0xF800 对应字节 00 F8；绿 0x07E0 对应 E0 07；蓝 0x001F 对应 1F 00；白 0xFFFF 对应 FF FF。现有 Python 与前端测试已覆盖这些通道和旋转。[3]

对于当前 limited-range 公式，UYVY 中性像素对 [128,16,128,16] 应得到黑，[128,235,128,235] 应得到白。新增测试还需覆盖饱和色、两个不同 Y 值及范围裁切，并直接执行生产转换函数。现有固件预览测试对 UYVY 转换使用 stub，不能证明该函数正确。[5]

# 4 转换正确后处理传感器与光照

## 先用测试图样隔离问题

当前 BF3901 驱动存在 ESP_CAM_SENSOR_IOC_S_TEST_PATTERN，但应用没有对应的摄像头 CLI。可在隔离诊断固件中接入并记录启停状态，依据厂商说明确认预期图样。测试图样能帮助定位传感器输出之后的数据路径，不能验证真实场景的白平衡与镜头效果。[6]

测试图样正常、真实场景仍偏色时，再比较固定中性光源、不同照明与灰卡结果。如果换光源后明显变化，优先检查混合光、彩色反射及自动白平衡；如果所有条件都出现同一种通道错误，继续回查转换和传感器输出配置。

## 白平衡需要驱动支持

当前 BF3901 的通用参数设置只实现镜像与翻转，没有可直接调用的 AWB、色温或 R/B 增益接口。不能照搬其他传感器的 set_whitebal 或 set_wb_mode 示例，也不能因寄存器表含有某个地址就猜测其功能。[6]

需要调整时，先取得与该 BF3901 模块匹配的寄存器说明，再确认自动控制开关、增益寄存器、有效范围及写入时机。保存原始寄存器值，检查写入结果，必要时读回；一次只改一组参数，失败时恢复。固定白平衡必须在匹配光照下标定，不能作为所有场景的通用值。

## 有限的软件增益补偿

只有确认格式与转换正确、传感器调节仍不足时，才考虑临时 RGB 增益。可在均匀、不过曝的中性灰区域测出通道均值 r̄、ḡ、b̄，并以 ḡ/r̄、1、ḡ/b̄ 作为初始通道增益。近黑或有裁切的区域不参与估计；增益需限幅，并检查噪声、高光与其他色块。

这属于工程补偿，不是色度学标定，也不能修复 U/V 顺序错误。若采用，应放在预览与模型共同使用且只执行一次的转换阶段，记录配置与开关，重新验收识别效果。只给网页加滤镜会保留模型输入中的原问题。

## 与偏色同时出现的异常

若伴随条纹、闪烁、行错位、空帧或设备重启，先查看接线、供电和帧完整性。现有断电重连后恢复取帧的记录没有确定故障原因，不能把它直接归因为供电，也不能据此排除供电。[1]

断电后检查摄像头连接与供电；本轮不改变云台位置或进行电机动作。历史俯仰启动位置问题单独处理，不用颜色调参掩盖取景偏移。

## 保留可回退版本

每个候选只包含一类改动，记录源码位置、传感器参数、构建配置与镜像 SHA。修改应落在可重复生成的项目源码或补丁中；不要只编辑 .work 或 managed_components 后便认为修复已保存。

# 5 验收修复结果

先通过软件颜色向量，再验收真实灰卡／色块，最后单独检查人脸输入。建议先在一种固定照明下建立基线，再换第二种常用照明复测；每种条件至少保存 3 组样本。以下为本项目建议门槛，不是传感器厂商精度标准。

验收项 | 通过条件 | 证据
传输与格式 | 宽高、长度、块顺序及 checksum 一致；没有将旧图当成新帧。 | 原始记录、接收时间与镜像 SHA。
数字颜色路径 | RGB565 纯色、UYVY 灰阶／色块、边界及旋转测试通过；同一输入两端解码一致。 | 测试输出与固定输入文件。
真实场景颜色 | 中性区域无明显色偏；红绿蓝没有互换；灰阶顺序正常；没有用过曝换取“白色”。 | 同场景前后图、光照与取景说明。
重复性 | 固定场景连续样本无明显色彩跳变；第二种照明下结论单独记录。 | 每种条件至少 3 组样本。
模型输入 | 实际模型输入与修复后的预览色彩一致，方向正确，脸完整可见。 | model 来源验证与灰卡／人脸样本。
识别与时序 | 颜色验收后独立进行正脸、侧倾、回正与遮挡测试。 | 追踪日志与现有 pose_readiness 报告。

## 可选的中性区域量化指标

在同一灰卡区域统计 RGB 均值，定义中性偏差 E＝(最大通道均值−最小通道均值)／三通道均值的平均值。可以将 E≤10% 作为初筛目标，并比较修复前后数值与连续样本波动。只对不过曝、非近黑的中性区域使用；该指标不是 ΔE，也不能单独证明肤色或所有颜色准确。

## 识别效果单独验收

拍照导出期间不采集性能结论。停止取帧后，沿用项目已有连续姿态门槛：至少一个片段含不少于 30 条追踪观察且覆盖不少于 30 秒；结果帧龄、相邻采集间隔及前帧采集到下一帧结果的时间均不超过 400 ms。时序通过仍需另测动作准确性。[2]

## 每轮记录

日期与固件 SHA：
光源、距离、灰卡位置：
本轮唯一改动与回退方法：
camera／model／原始帧文件：
偏色现象与灰卡 RGB 均值：
修复前后 E 值及是否过曝：
软件测试／真实颜色／模型输入／识别结果：
结论：已修复／部分改善／未改善；下一项验证：

完成条件：确认问题所在层，改动可复现、可回退，修复前后证据齐全，真实颜色与模型输入分别通过。主机测试或一次样例检出不替代这些验收。

# 6 核查依据与实现入口

以下本地路径相对于项目根目录 /Users/emt/Workspace/hackathon/gesture-bridge。源码核查与主机检查日期为 2026 年 10 月 31 日。历史实机结果按对应记录的范围引用；实施前需重新确认设备上实际运行的镜像。

## 本地证据

[1] artifacts/face-selftest-runtime-20261031.json
官方固定样例检出 1 张脸；断电重连后记录 935 个完整帧、0 空帧，模型输入快照校验通过。相应快照保存在 .local/face-selftest-reconnected-model-20261031.png；画面没有灰卡，不能用作色彩验收。

[2] docs/next-device-tests-2026-10-31.md；docs/control-panel.md
提供串口使用方式、预览分辨率、连续姿态门槛和云台暂停条件。该清单中“自检候选尚未烧录”的旧状态已被 [1] 的实机记录更新；颜色排查采用后续记录，不依赖旧镜像描述。

[3] tools/camera_preview.py；panel/src/camera.mjs
Python 和浏览器均按 RGB565LE 解码；测试位于 tests/test_camera_preview.py 和 panel/tests/camera.test.mjs。

[4] headvoice/firmware/hv_camera_preview.c；headvoice/firmware/headvoice_app.c；headvoice/firmware/hv_face_pose.cpp
普通快照、模型输入取样、转换调用顺序与 RGB888 模型输入类型。tests/test_camera_preview_firmware.py 验证生产预览状态机和采样，但将 UYVY 转换函数替换为 stub。

[5] .work/face-selftest-eligibility-check/apps/main/pose/yolo11_pose.cpp
重点函数：yuv_to_rgb888、yolo11_pose_uyvy_to_rgb888、yolo11_pose_uyvy_to_rgb888_cw90、yolo11_pose_uyvy_to_rgb565。该路径是构建工作副本，仅用作核查入口。

[6] .work/face-selftest-eligibility-check/apps/managed_components/
espressif__esp_cam_sensor/sensors/bf3901/
重点文件：bf3901.c、private_include 下的 1bit 24Minput 240x320 UYVY 15fps 寄存器表；构建 sdkconfig 选中 CONFIG_CAMERA_BF3901_SPI_YUV422_240X320_15FPS。驱动支持测试图样与寄存器访问，但当前通用参数接口没有 AWB 控制。

## 格式与色彩定义

[7] Linux Kernel 文档 Packed YUV formats (https://docs.kernel.org/userspace-api/media/v4l/pixfmt-packed-yuv.html)

用于核对 UYVY 的 U、Y0、V、Y1 顺序及相邻像素共享色度；不能证明本板实际传感器设置。

[8] Linux Kernel 文档 Detailed Colorspace Descriptions (https://docs.kernel.org/userspace-api/media/v4l/colorspaces-details.html)

用于区分 BT.601／BT.709 编码和 full／limited 量化范围；具体选择仍需对照当前输出配置。

## 本轮实际验证

python3 -m unittest discover -s tests -p 'test_camera_preview*.py'
结果：13 项通过

node --test panel/tests/camera.test.mjs
结果：5 项通过

本轮未连接设备取新帧、未修改或烧录固件、未调白平衡。本文为可执行的排查与修复方案；偏色根因与修复效果仍待上述现场对照确认。
