hecaojuanjuan/gesture-bridge/artifacts/poster/gesture-bridge-poster-v2-prompt.md

# Gesture Bridge 海报视觉草案 v2

- 日期：2026-10-31
- 方法：内置 image_gen 图像生成工具
- 用途：构图与视觉方向讨论；尚未制作印刷交付文件
- 版面比例：4:9，对应宽 80 × 高 180 cm
- 输出：`gesture-bridge-poster-v2.png`
- 参考图 1：用户提供的竖版手绘构图草图
- 参考图 2：`artifacts/enclosure-v1/enclosure-preview.png`，仅供设备结构参考

## 实际生成提示词

```text
Use case: ads-marketing, illustrated concept poster.
Create ONE polished design-review poster for a real assistive communication hardware project. This is a NEW poster, using the images as references, not an edit of the sketch itself. Flat front-on print artwork, full bleed, no surrounding room, no easel, no mockup perspective. Very tall portrait exact width:height = 4:9, intended physical size 80 cm wide and 180 cm tall. Render at the highest feasible resolution in that ratio.

REFERENCE ROLES:
Image 1 is the user's rough COMPOSITION reference only: a tall flowing poster, curving organic division and diagonal visual reading from upper left through the centre into the lower right. Do not copy its hand imagery, placeholder Chinese words, grey-right/blue-left allocation, or sketch handwriting.
Image 2 is STRUCTURAL guidance only for the central hardware concept: a low rectangular desktop enclosure with an exposed compact two-axis camera/gimbal mounted near its centre, front speaker grille and tiny status light. It is an unfinished mechanical concept, not a photograph. Render a simplified attractive ASSEMBLED cream/off-white enclosure with a dark camera/lens, modest teal accent. No exploded view, no dimension text, no fake screen, no robot arms. Include the small label “产品概念示意”.

BRAND, EXACT lower-case text: “gesture bridge”. Do not put HeadVoice or 颔语 anywhere.
Main Chinese slogan, exact: “让动作，拥有声音”
This device maps intentionally made head movements to chosen phrases, then speaks the exact chosen phrase after a new user confirmation. It is HEAD / POSTURE recognition, not sign-language translation or interpreting free hand gestures.

COMPOSITION:
A strong editorial illustration with graceful broad S-shaped organic colour fields; not a grid, not a conventional collection of cards. All important print content has a clean roughly 5% inner safety margin.
UPPER LEFT, approximately first 28% of the poster: quiet desaturated charcoal, warm grey, blue-grey. Large brand near upper left, two stacked lines “gesture” and “bridge” if necessary; clear contemporary sans serif typography, generous spacing, powerful readability. Slogan below or adjacent. A dignified adult with speech difficulties shown in a natural head-and-shoulders pose, slightly tilted head, facing toward the centre/right, no sadness stereotype, no tape over mouth. Small but clearly visible computer-vision landmark dots on eyes/nose/ears/shoulders with fine connecting lines and a subtle head-angle tracking arc / alternate head-position contour. This should unmistakably depict camera-based head pose recognition. Supporting label “头部动作识别”. Use a sparse speech bubble/quiet broken line to imply expression that is not yet reaching others. The grey describes a communication barrier, not the value of the person.
CENTRE, approximately y=40%–55%: a prominent well-lit desktop device CONCEPT rendering bridging the muted and colourful worlds, floating naturally within the graphic flow, anchored by a soft shadow. A flowing path travels from the head landmarks toward its lens, then emerges as a lively clean voice waveform and speech shapes flowing downward/right. Keep hardware big enough to be understood, not a tiny diagram. Near it a short, legible functional process:
“动作识别 → 句意选择”
“本人确认 → 语音表达”
LOWER RIGHT, the largest visual focus approximately y=53%–94%, occupying at least 45% of the total image and substantially larger than the upper-left illustration: the same adult now participating in an equal, warm conversation with two other adults. Airy, optimistic, colourful editorial illustration, not photoreal hospital imagery. Recognisably the same main person across both worlds. Rich but controlled warm yellow, coral, teal, sky blue and creamy off-white overlapping organic speech-bubble forms. Faces and interaction are natural, active and respectful. The people and voice shapes are concentrated toward the lower-right but fill the broad lower half of the poster; do not leave a large empty dark footer.
Readable speech bubbles, exact:
“我想喝水。”
“我想自己来。”
“好，我们一起。”
These demonstrate expressing needs, agency and two-way communication.
Integrate one readable supporting line into the lower colourful area:
“自定义表达 · 自主选句 · 个体适应”
Bottom small but legible line, exact:
“完整产品设计 · 部分功能开发验证中”

ART DIRECTION:
High-quality contemporary public-interest technology campaign, mixed clean flat illustration and subtle paper grain, elegant shaped negative space, bold typographic hierarchy. Mostly flat graphic people, the central product may have restrained dimensional shading. Seamless visual progression from muted upper left into luminous multicolour lower right. Use dark ink text on pale yellow/coral areas and light text only on sufficiently dark fields; excellent Chinese typography and spelling. Crisp print-oriented design. Keep copy concise and abundant breathing room.
Do not add invented accuracy numbers, claims of a working medical device, QR codes, team names, logos, extra paragraphs, registration marks, watermarks, decorative hand signs, or electrical wiring. Make the graphic narrative and diagonal transition dominate.
```
