hecaojuanjuan/gesture-bridge/artifacts/poster/gesture-bridge-poster-v8-80x180cm.pdf

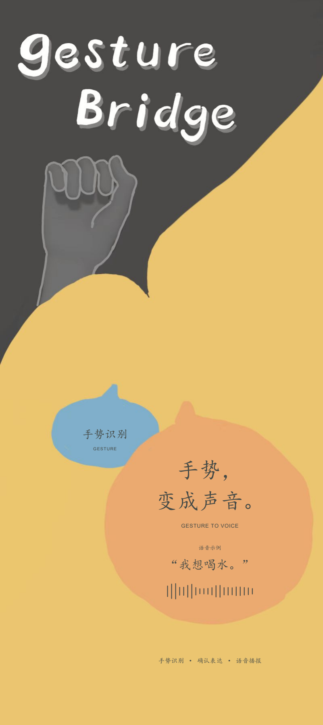
[picture p3: page 1]

# 手势识别

GESTURE
手势，

# 变成声音。

GESTURE TO VOICE

语音示例

# “我想喝水。”

手势识别 · 确认表达 · 语音播报
