hecaojuanjuan/gesture-bridge/artifacts/poster/gesture-bridge-poster-v7-80x180cm.pdf

# Gesture Bridge

# 手势转语音辅助沟通设备

# 把手势，

# 说出来。

## GESTURE TO VOICE

# 手势输入

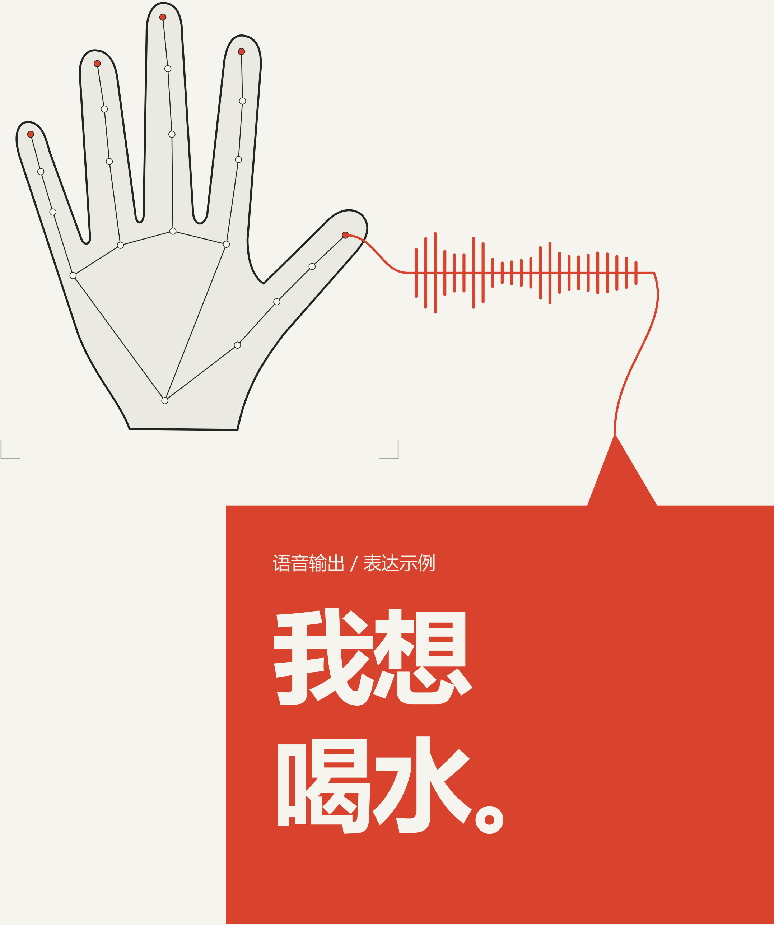
[picture p4: figure]
语音输出 / 表达示例 我想 喝水。

手势识别 | 确认表达 | 语音播报

Gesture Bridge / 产品概念设计
