hecaojuanjuan/gesture-bridge/artifacts/enclosure-milk-egg-v2/milk-egg-preview.png

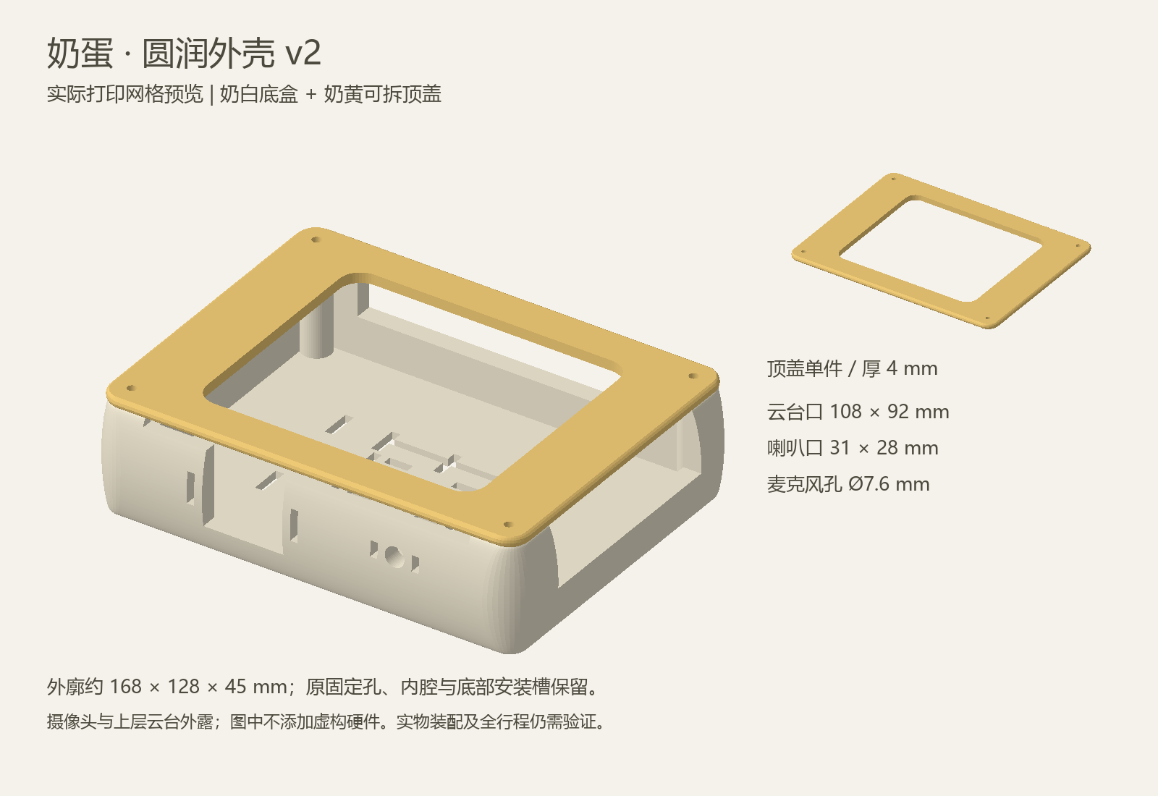
artifacts/enclosure-milk-egg-v2/milk-egg-preview.png
