hecaojuanjuan/gesture-bridge/artifacts/enclosure-v1/enclosure-preview.png

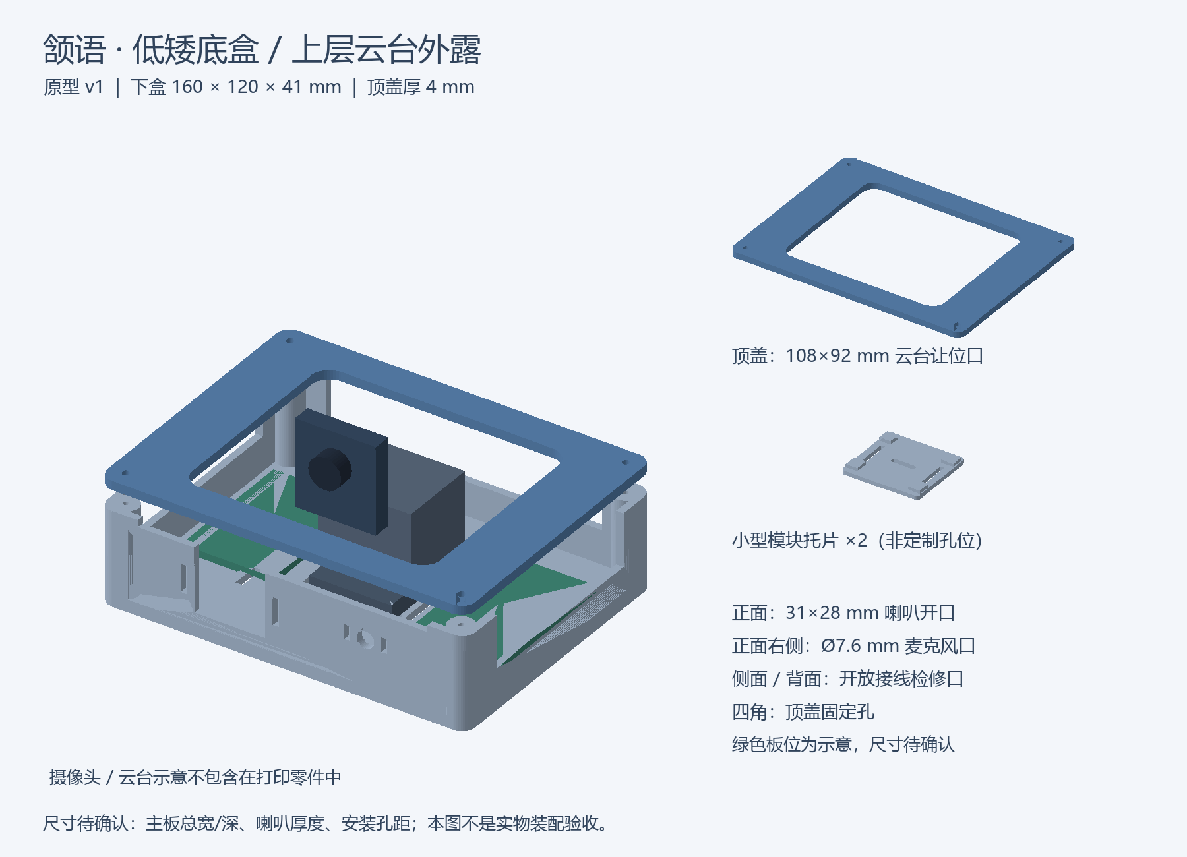
artifacts/enclosure-v1/enclosure-preview.png
