hecaojuanjuan/gesture-bridge/artifacts/milk-egg-protective-cover-v5/milk-egg-cover-preview.png

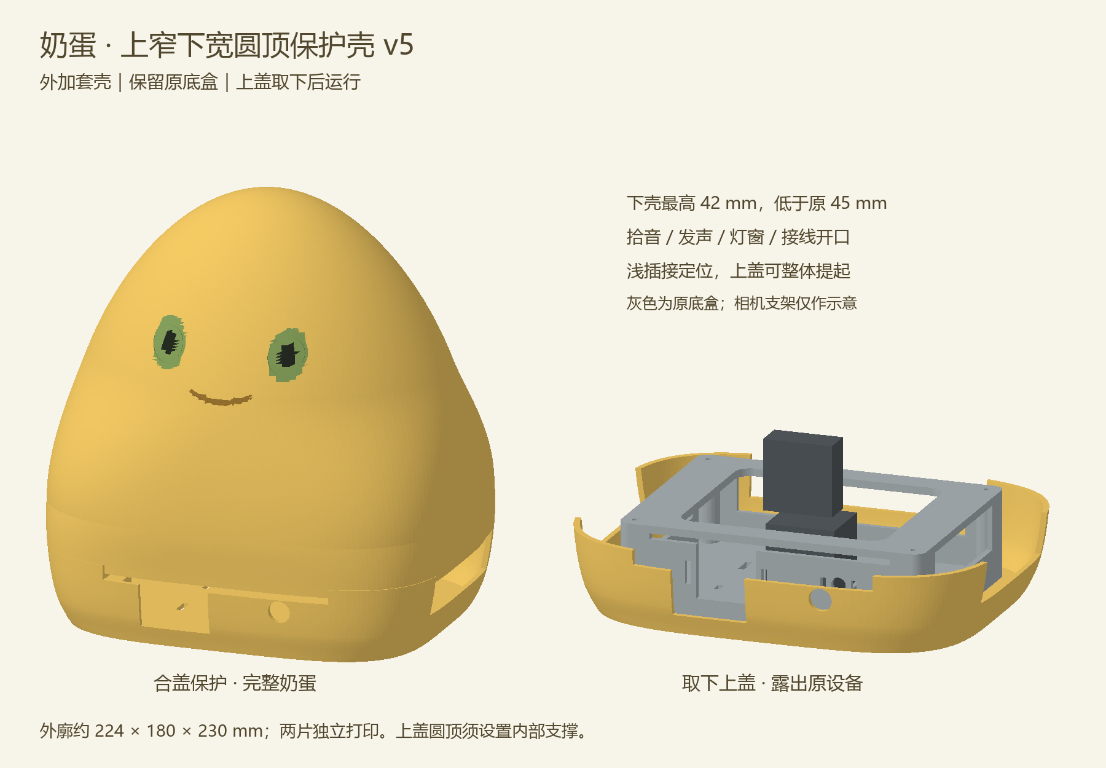
artifacts/milk-egg-protective-cover-v5/milk-egg-cover-preview.png
