hecaojuanjuan/gesture-bridge/artifacts/milk-egg-protective-cover-v6-compact/milk-egg-cover-preview.png

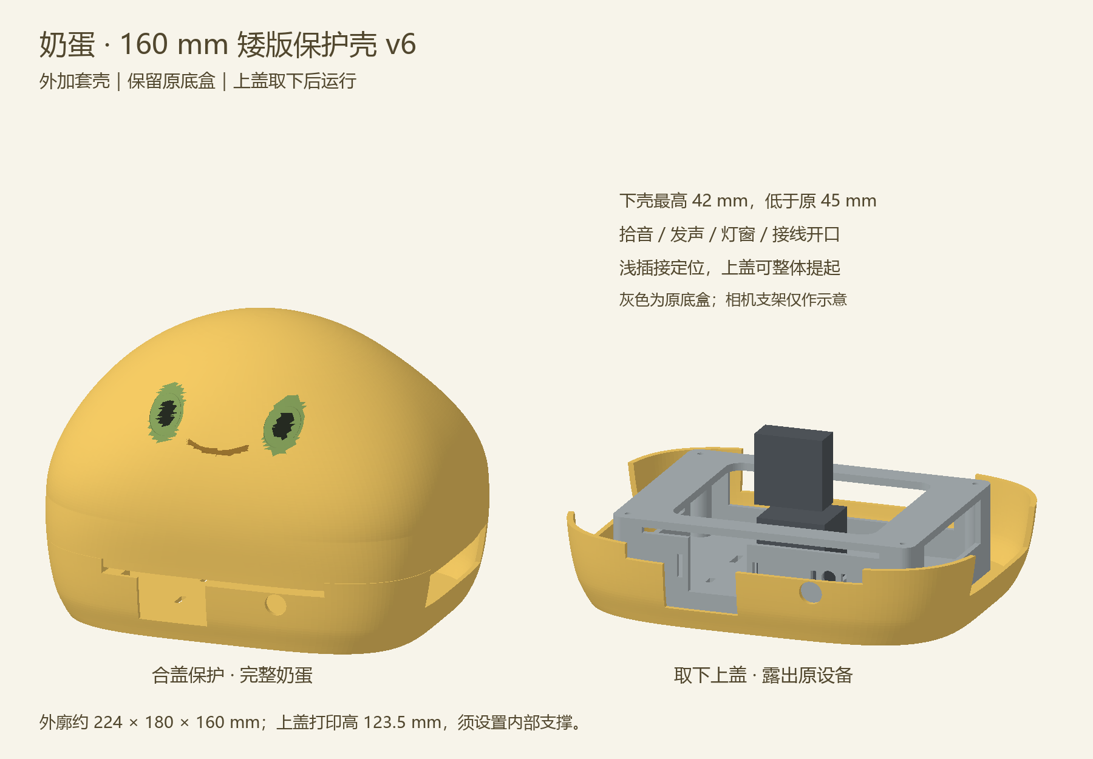
artifacts/milk-egg-protective-cover-v6-compact/milk-egg-cover-preview.png
