hecaojuanjuan/gesture-bridge/artifacts/panel-combined-20261101/device-desktop.jpg

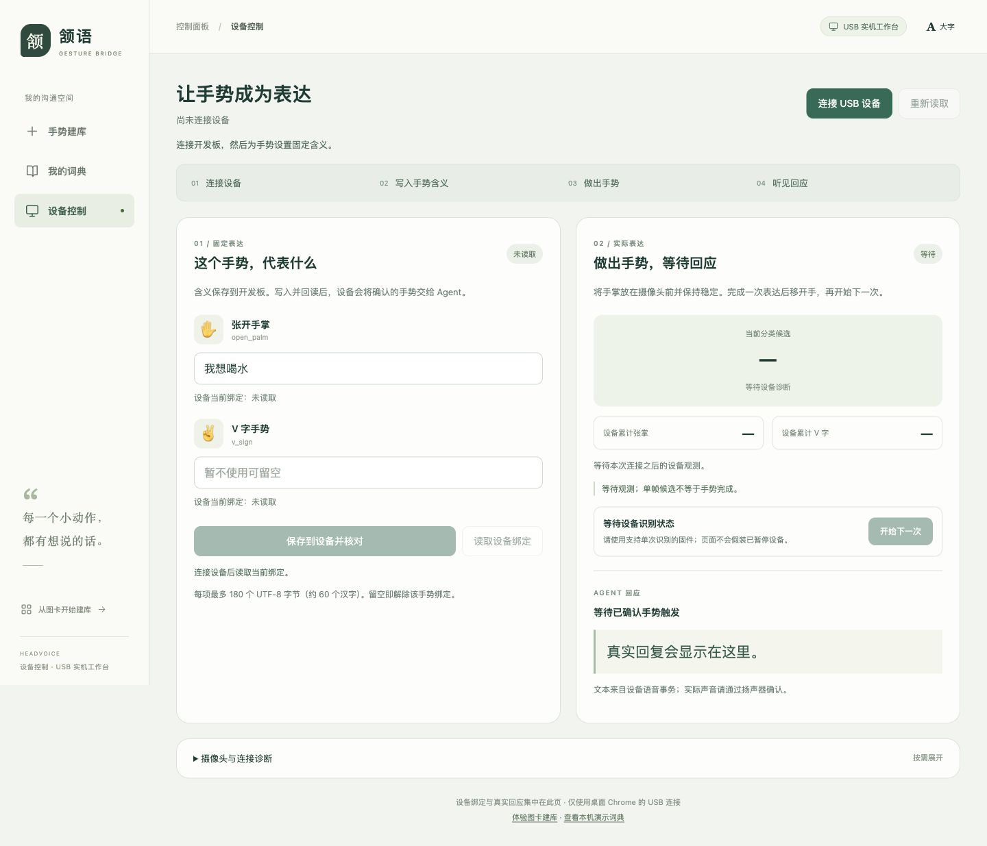
artifacts/panel-combined-20261101/device-desktop.jpg
