hecaojuanjuan/gesture-bridge/artifacts/panel-combined-20261101/dictionary-desktop.jpg

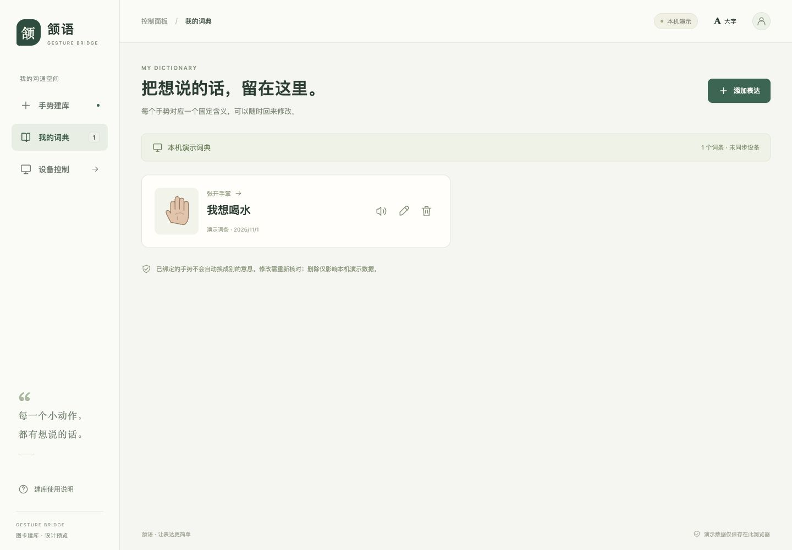
artifacts/panel-combined-20261101/dictionary-desktop.jpg
