hecaojuanjuan/gesture-bridge/artifacts/panel-preview.jpg

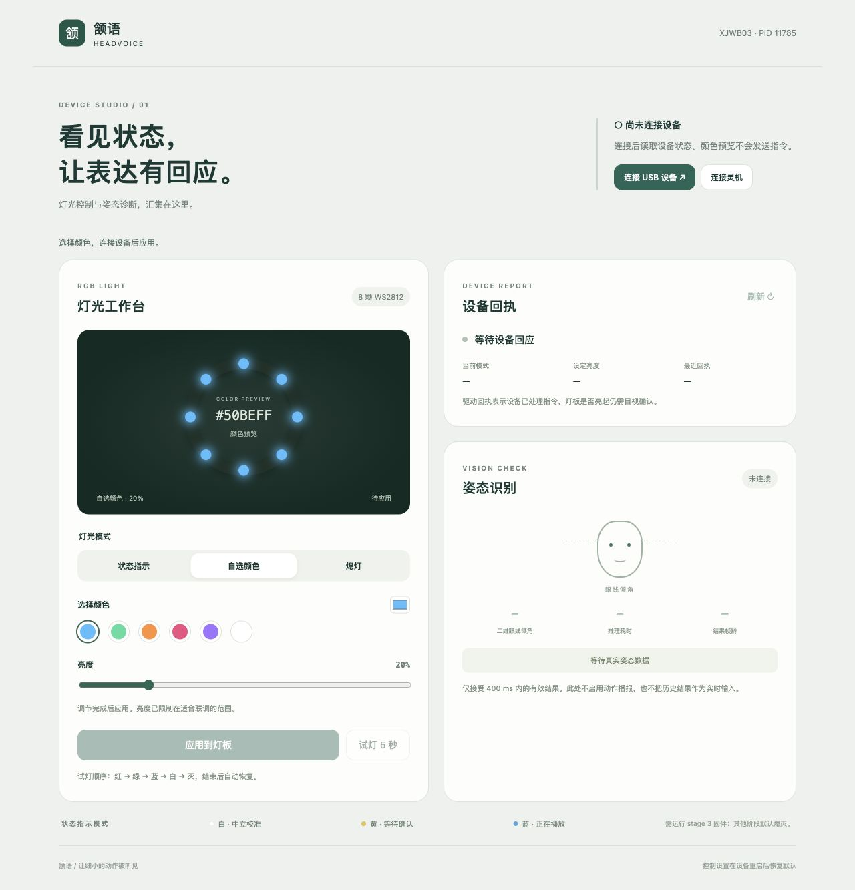
artifacts/panel-preview.jpg
