hecaojuanjuan/gesture-bridge/artifacts/panel-usb-reconnected-20261031.png

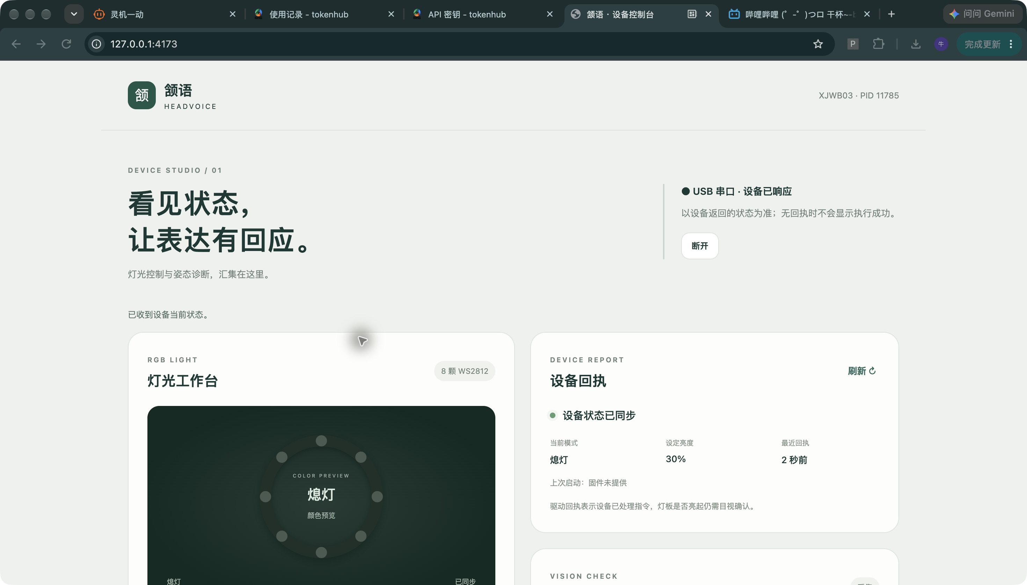
artifacts/panel-usb-reconnected-20261031.png
