hecaojuanjuan/gesture-bridge/artifacts/panel-usb-wired-20261031.png

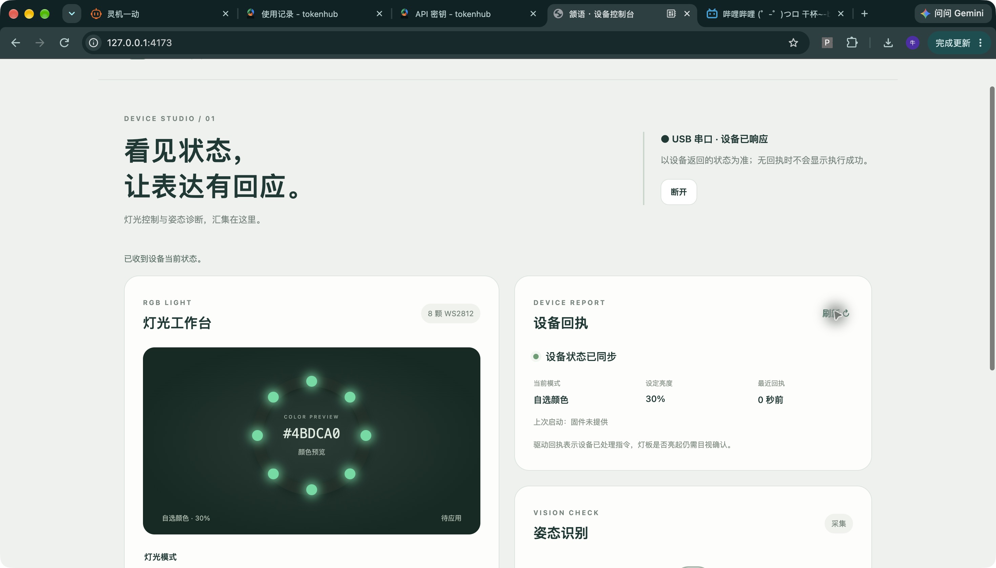
artifacts/panel-usb-wired-20261031.png
