hecaojuanjuan/gesture-bridge/artifacts/poster/gesture-bridge-poster-v2.png

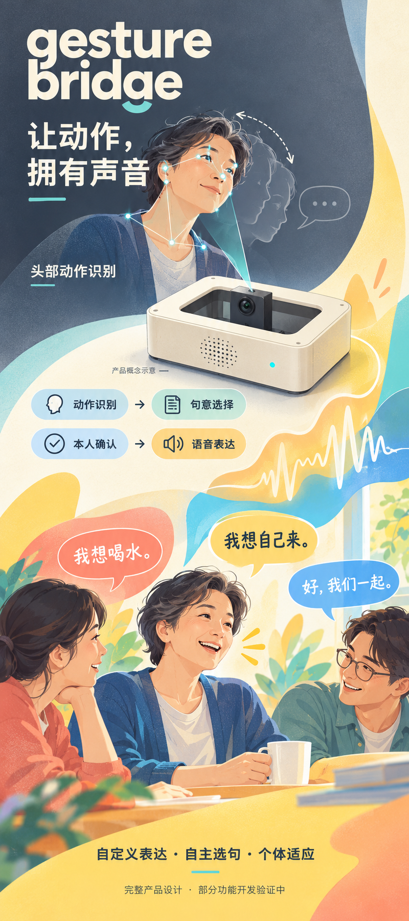
artifacts/poster/gesture-bridge-poster-v2.png
