hecaojuanjuan/gesture-bridge/artifacts/poster/gesture-bridge-poster-v3.png

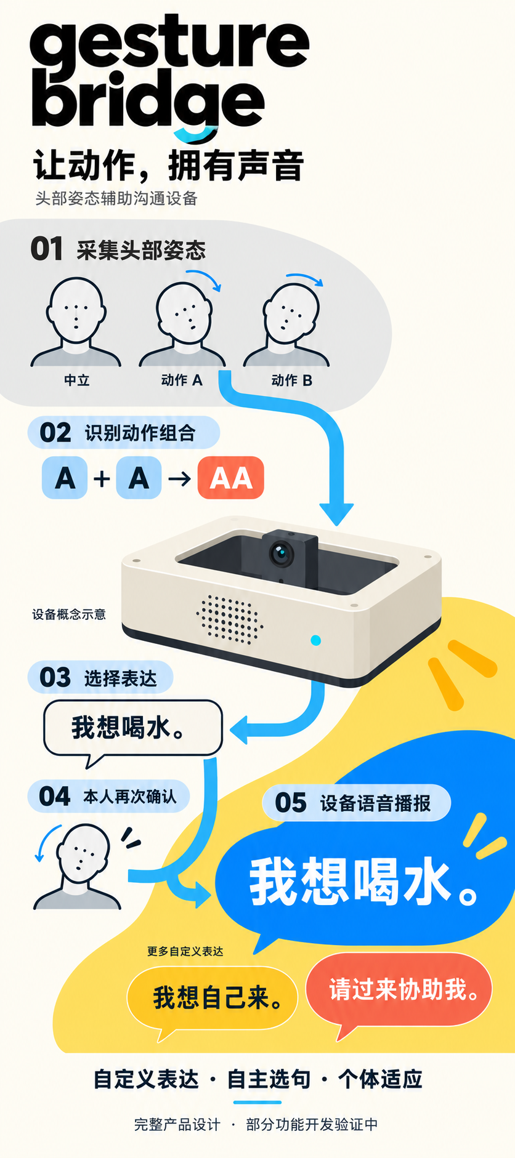
artifacts/poster/gesture-bridge-poster-v3.png
