hecaojuanjuan/gesture-bridge/artifacts/poster/gesture-bridge-poster-v4-preview.png

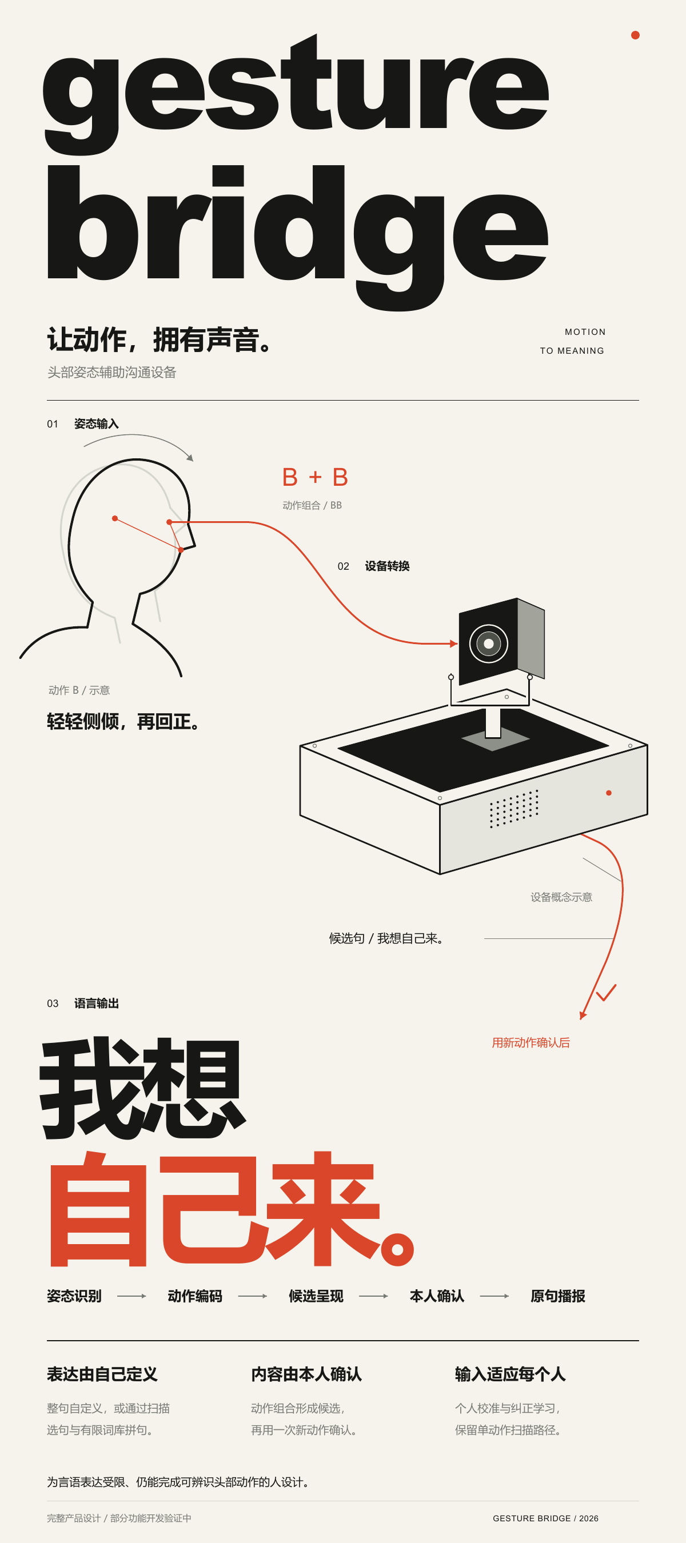
artifacts/poster/gesture-bridge-poster-v4-preview.png
