hecaojuanjuan/gesture-bridge/artifacts/poster/gesture-bridge-poster-v5-browser-check.png

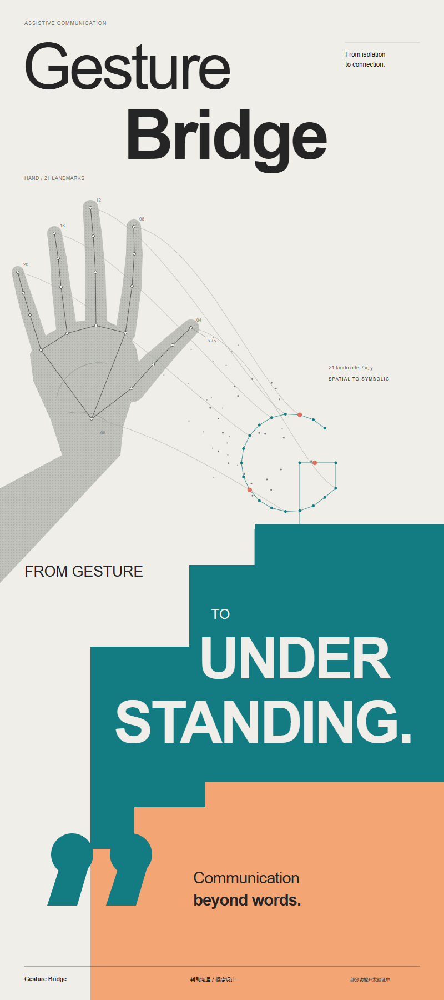
artifacts/poster/gesture-bridge-poster-v5-browser-check.png
