hecaojuanjuan/gesture-bridge/artifacts/poster/gesture-bridge-poster-v6-browser-check.png

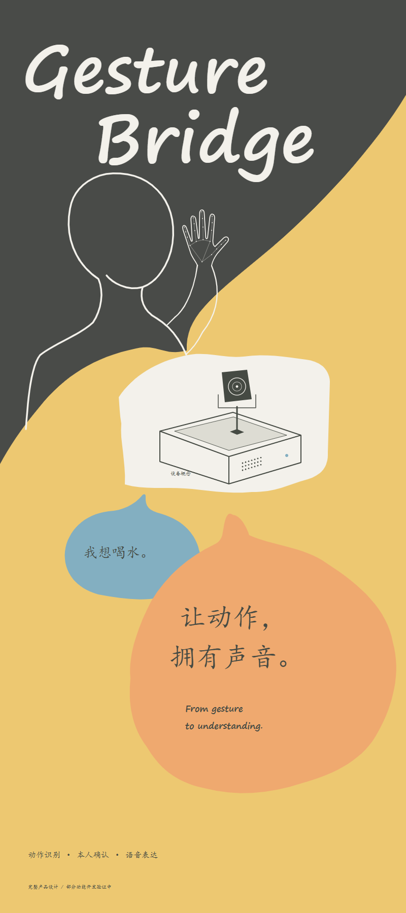
artifacts/poster/gesture-bridge-poster-v6-browser-check.png
