hecaojuanjuan/gesture-bridge/artifacts/poster/gesture-bridge-poster-v7-browser-check.png

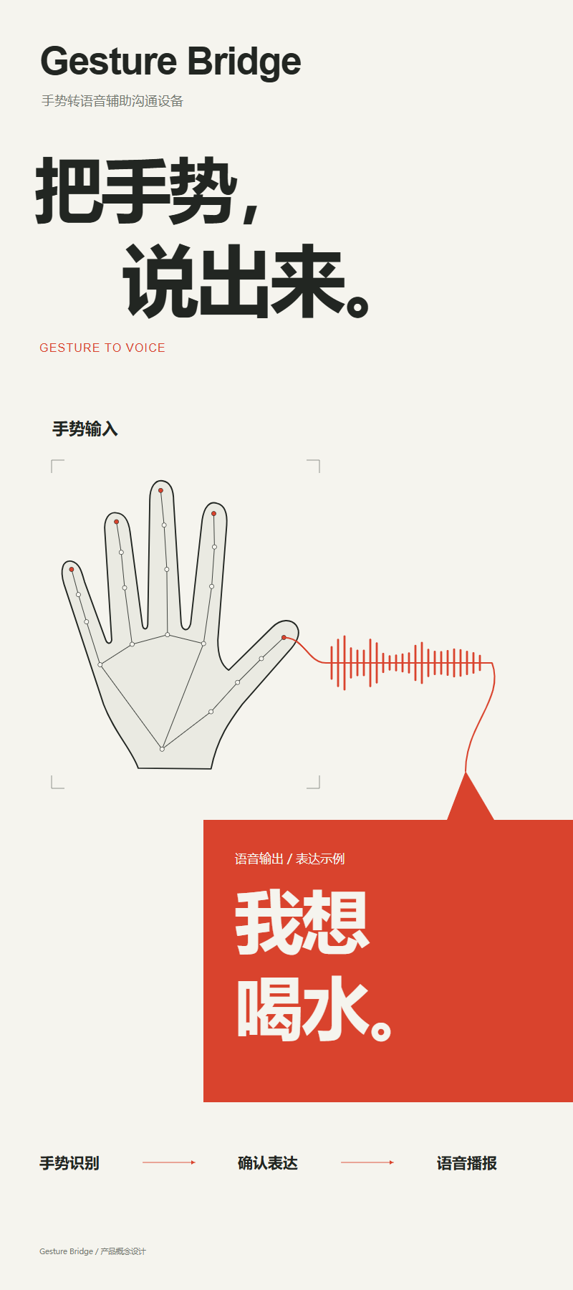
artifacts/poster/gesture-bridge-poster-v7-browser-check.png
