hecaojuanjuan/gesture-bridge/artifacts/poster/gesture-bridge-poster-v8-background.jpg

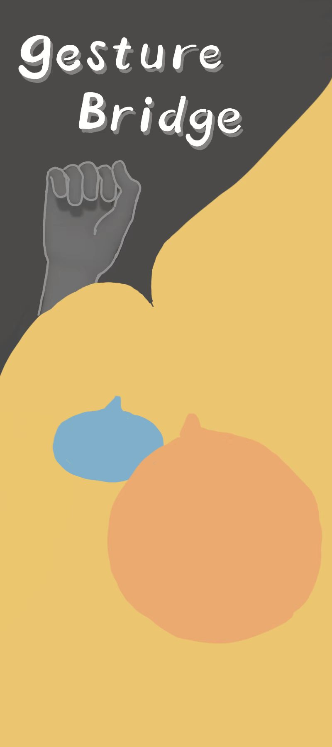
artifacts/poster/gesture-bridge-poster-v8-background.jpg
