hecaojuanjuan/gesture-bridge/artifacts/poster/gesture-bridge-poster-v9-background.jpg

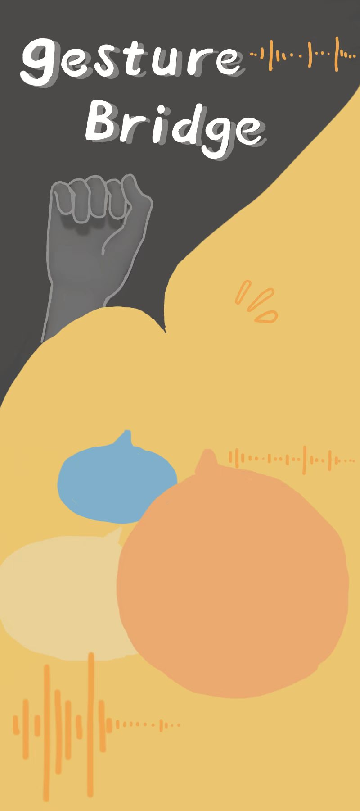
artifacts/poster/gesture-bridge-poster-v9-background.jpg
