hecaojuanjuan/gesture-bridge/artifacts/poster/gesture-bridge-poster-v9-browser-check.png

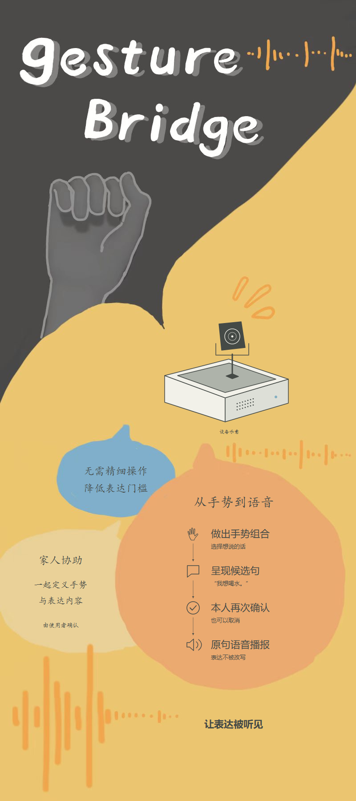
artifacts/poster/gesture-bridge-poster-v9-browser-check.png
