hecaojuanjuan/gesture-bridge/tmp/hardware-reference/camera-adapter-sch.pdf-1.png

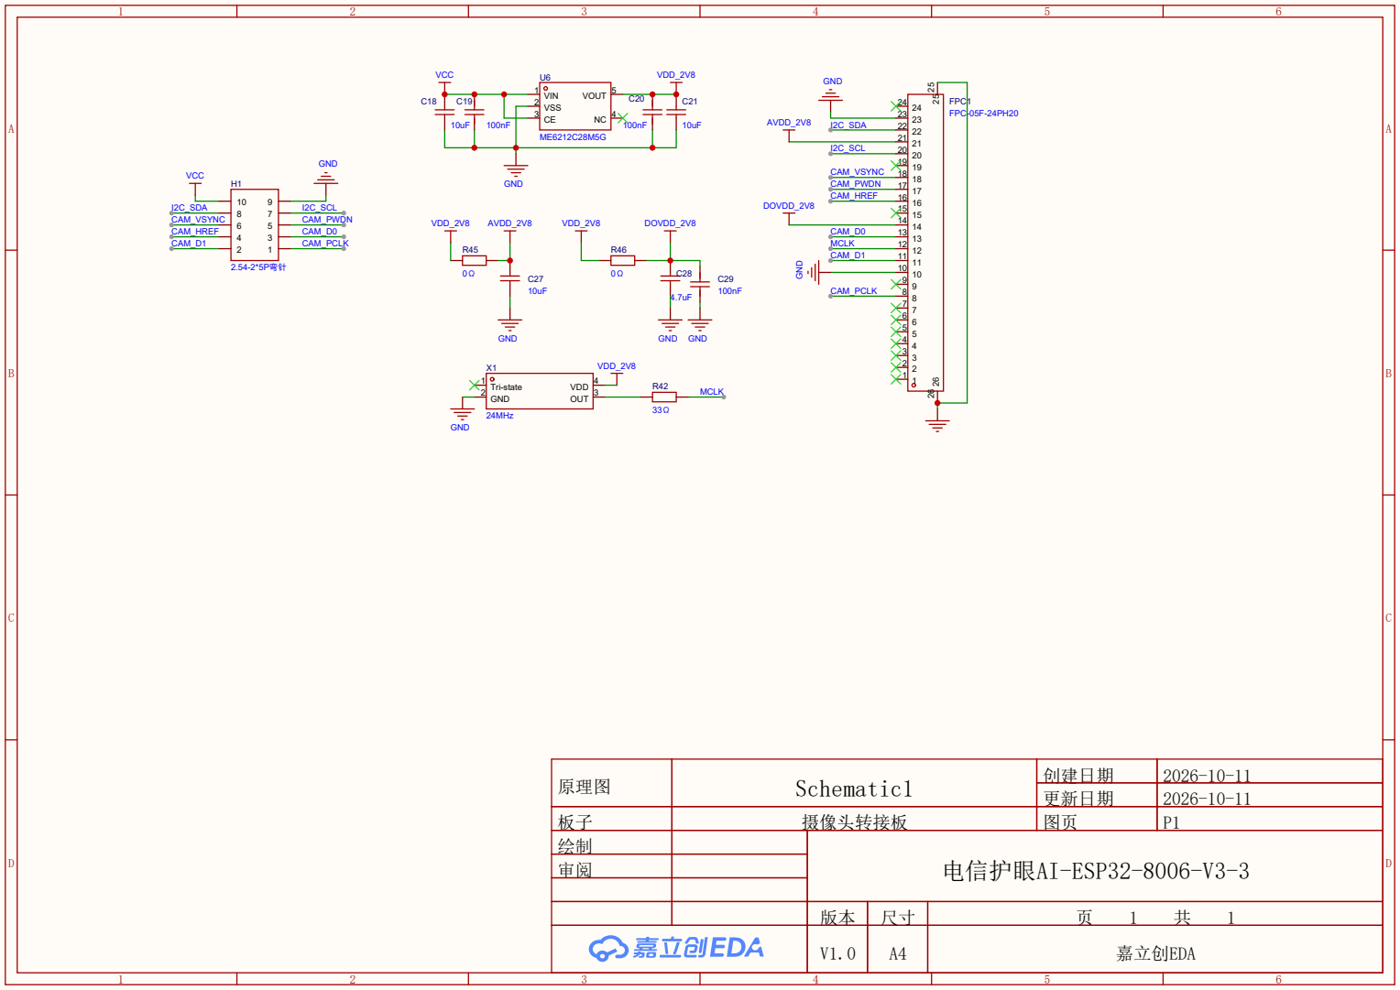
tmp/hardware-reference/camera-adapter-sch.pdf-1.png
