hecaojuanjuan/gesture-bridge/tmp/proposal-render/page-1.png

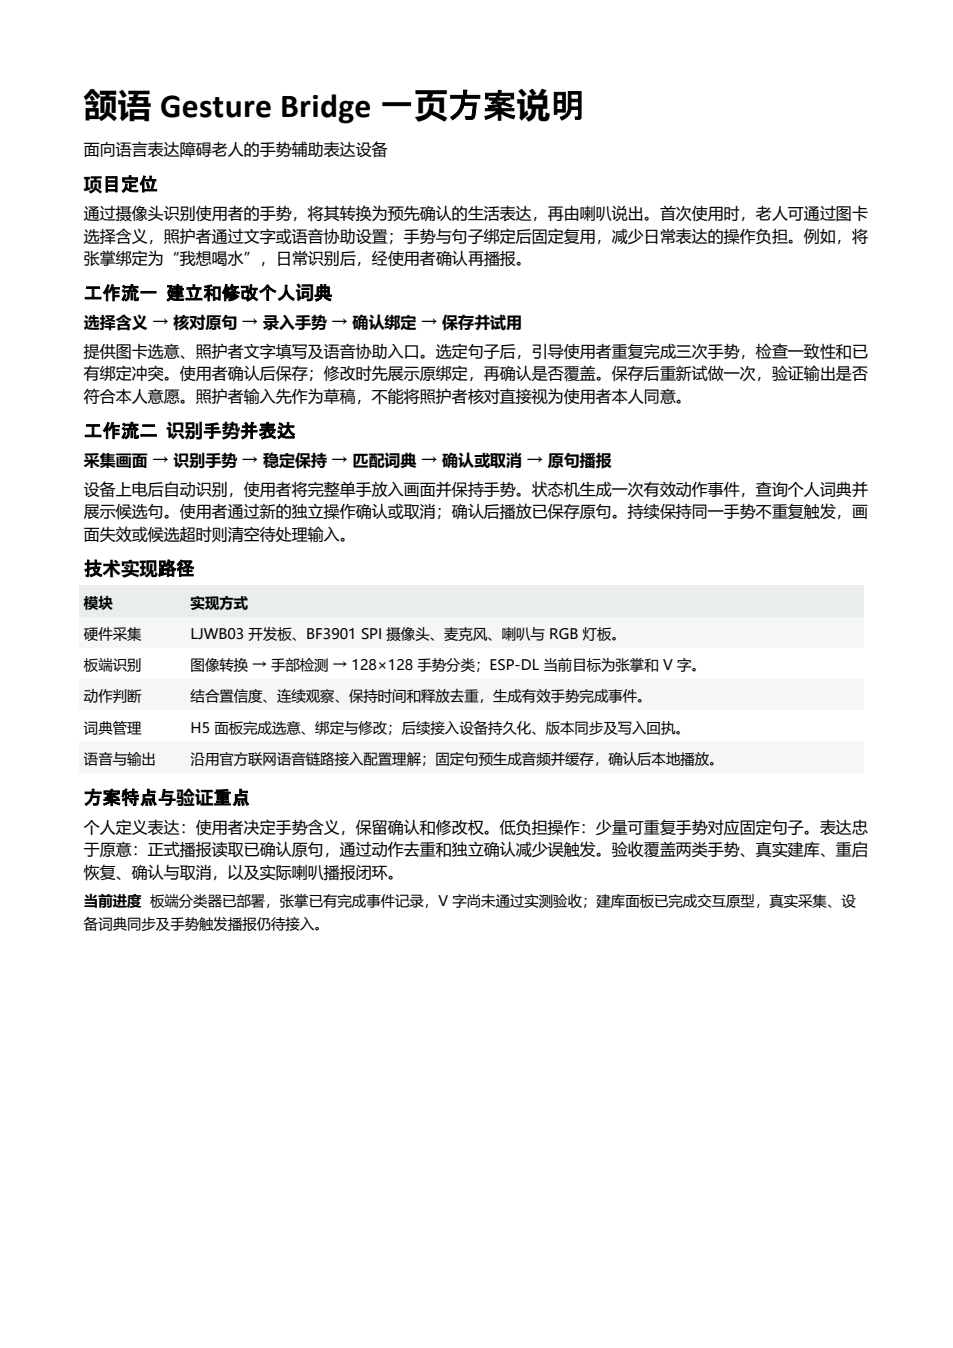
tmp/proposal-render/page-1.png
