hecaojuanjuan/gesture-bridge/tmp/proposal-render/page-v2.png

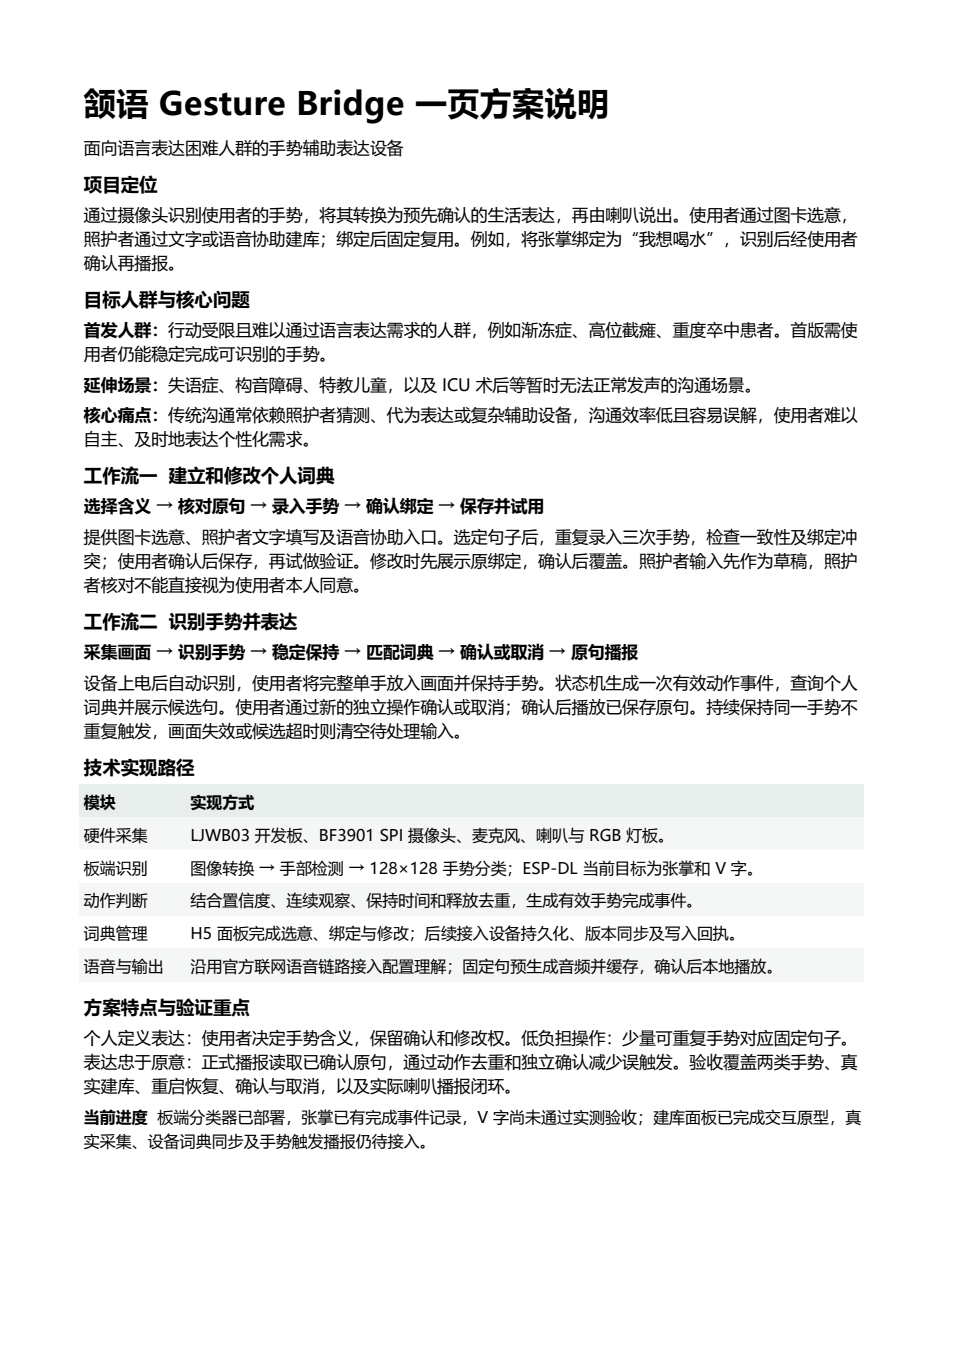
tmp/proposal-render/page-v2.png
