hecaojuanjuan/gesture-bridge/tmp/proposal-render/page-v4.png

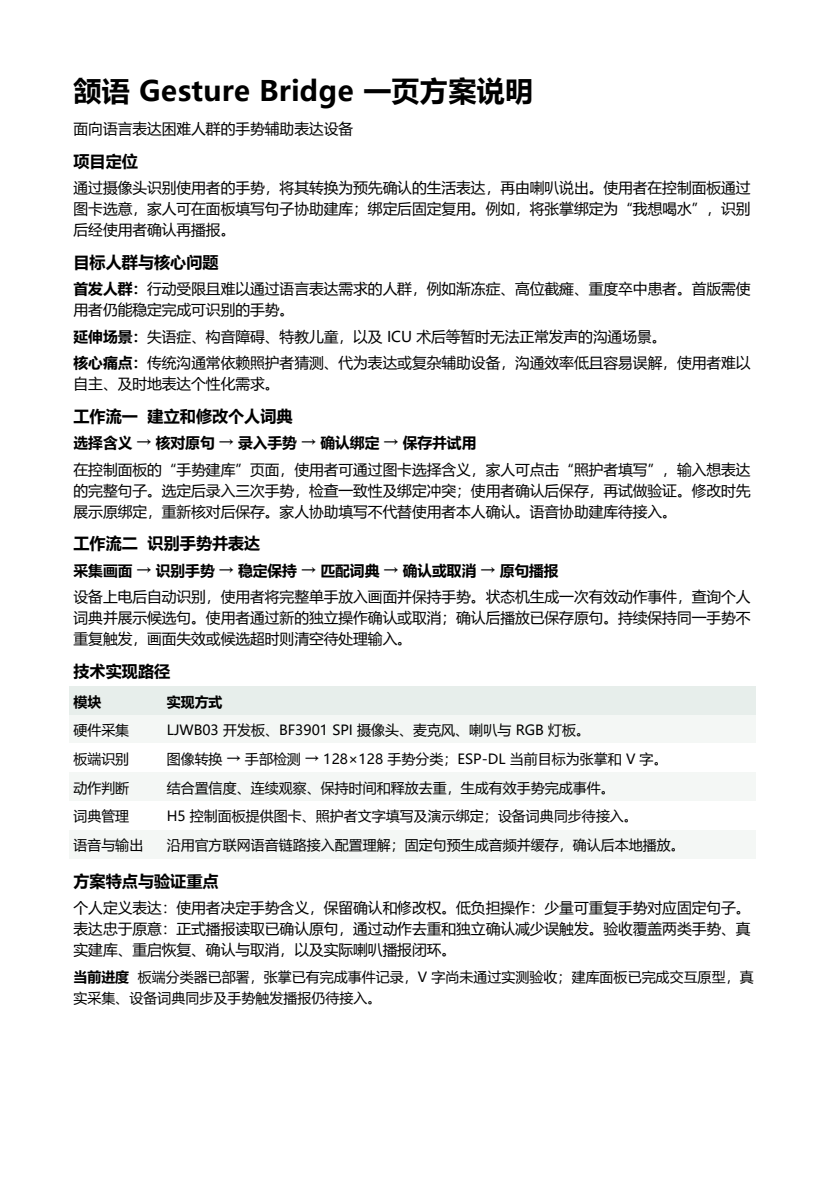
tmp/proposal-render/page-v4.png
