hecaojuanjuan/gesture-bridge/artifacts/enclosure-milk-egg-v2/gesture-bridge-milk-egg-v2.3mf

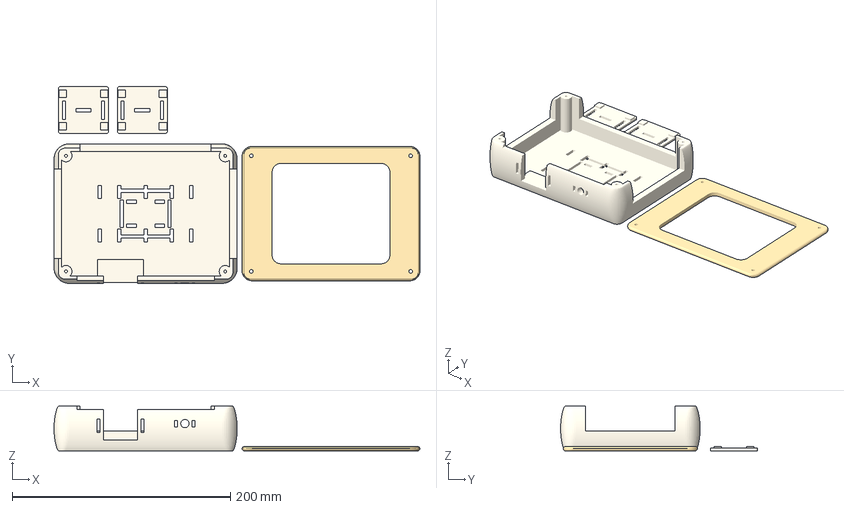
[picture p27: CAD file, 2026-11-01]
artifacts/enclosure-milk-egg-v2/gesture-bridge-milk-egg-v2.3mf
335.6 x 180.5 x 41.0 mm
milk_egg_body
milk_egg_lid
optional_carrier_A
optional_carrier_B
