hecaojuanjuan/gesture-bridge/artifacts/enclosure-v1/gesture-bridge-enclosure-v1.3mf

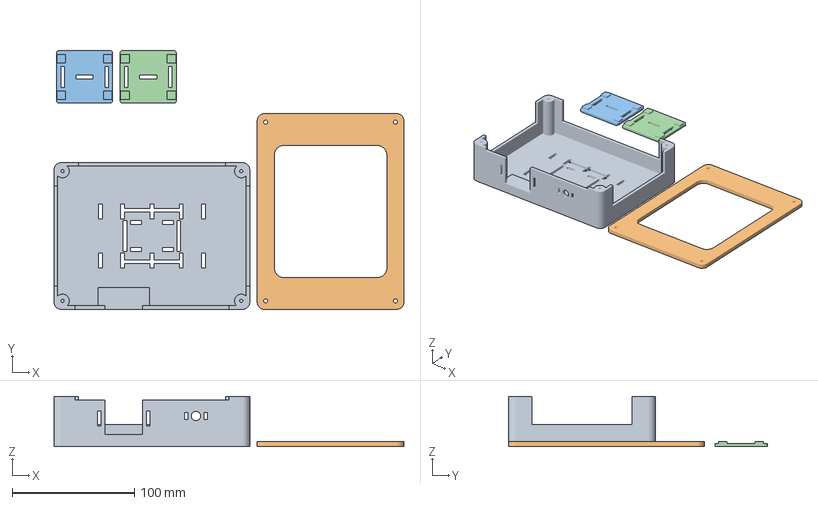
[picture p28: CAD file, 2026-10-31]
artifacts/enclosure-v1/gesture-bridge-enclosure-v1.3mf
286.0 x 211.5 x 41.0 mm
enclosure_body
gimbal_top_deck
board_carrier_A
board_carrier_B
