hecaojuanjuan/gesture-bridge/artifacts/milk-egg-protective-cover-v5/seam-fit-sample.3mf

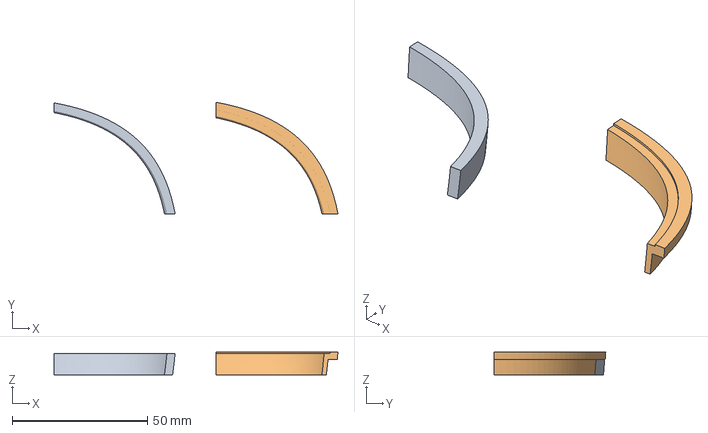
[picture p29: CAD file, 2026-11-01]
artifacts/milk-egg-protective-cover-v5/seam-fit-sample.3mf
105.2 x 41.3 x 8.50 mm
lower_seam_sample
upper_seam_sample
