hecaojuanjuan/gesture-bridge/artifacts/milk-egg-protective-cover-v6-compact/upper-cover.3mf

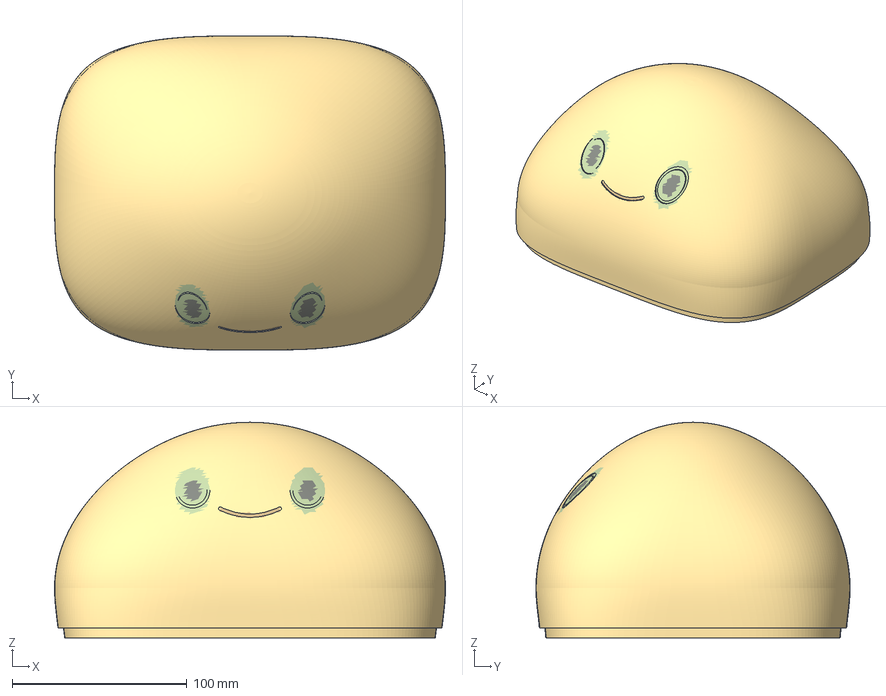
[picture p30: CAD file, 2026-11-01]
artifacts/milk-egg-protective-cover-v6-compact/upper-cover.3mf
224.0 x 180.0 x 123.5 mm
