hecaojuanjuan/gesture-bridge/artifacts/milk-egg-protective-cover-v7-100mm/upper-cover.3mf

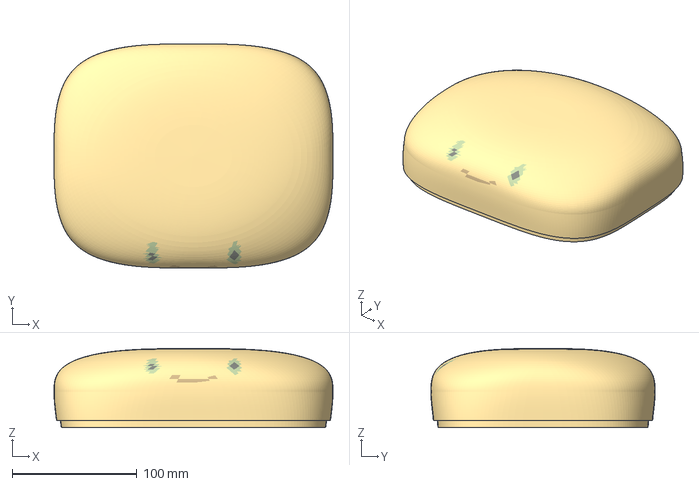
[picture p31: CAD file, 2026-11-01]
artifacts/milk-egg-protective-cover-v7-100mm/upper-cover.3mf
224.0 x 180.0 x 63.5 mm
