hecaojuanjuan/gesture-bridge/artifacts/enclosure-milk-egg-v2/milk_egg_body.3mf

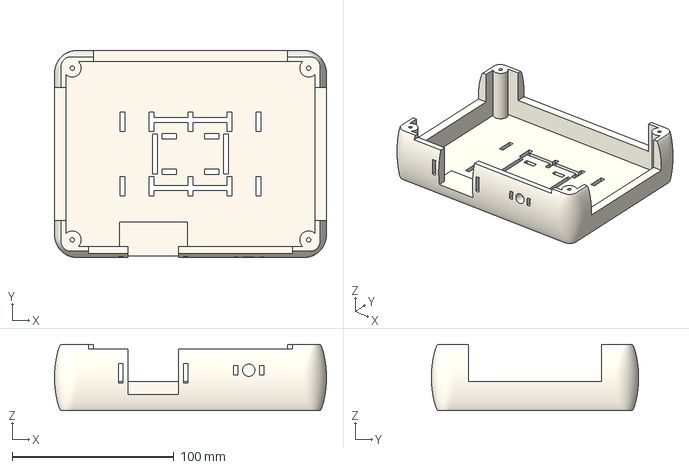
[picture p32: CAD file, 2026-11-01]
artifacts/enclosure-milk-egg-v2/milk_egg_body.3mf
168.0 x 128.0 x 41.0 mm
