hecaojuanjuan/gesture-bridge/artifacts/enclosure-v1/gimbal_top_deck.3mf

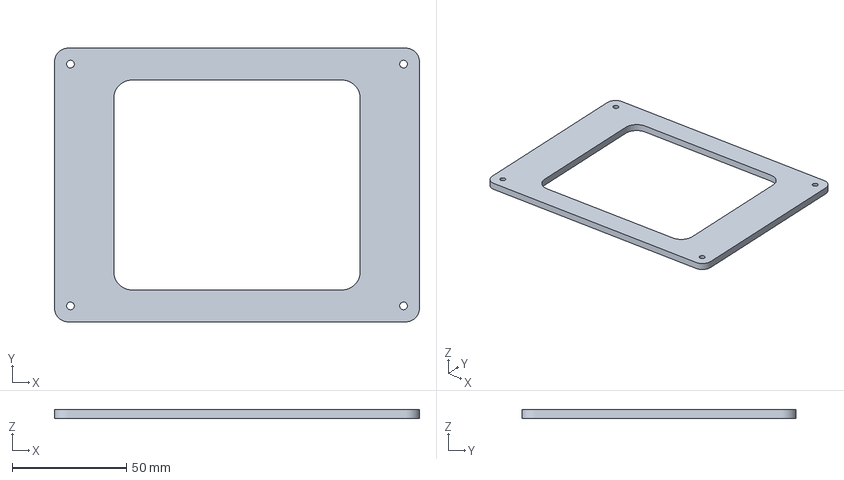
[picture p33: CAD file, 2026-10-31]
artifacts/enclosure-v1/gimbal_top_deck.3mf
160.0 x 120.0 x 4.00 mm
