hecaojuanjuan/gesture-bridge/artifacts/milk-egg-protective-cover-v5/lower-shell.3mf

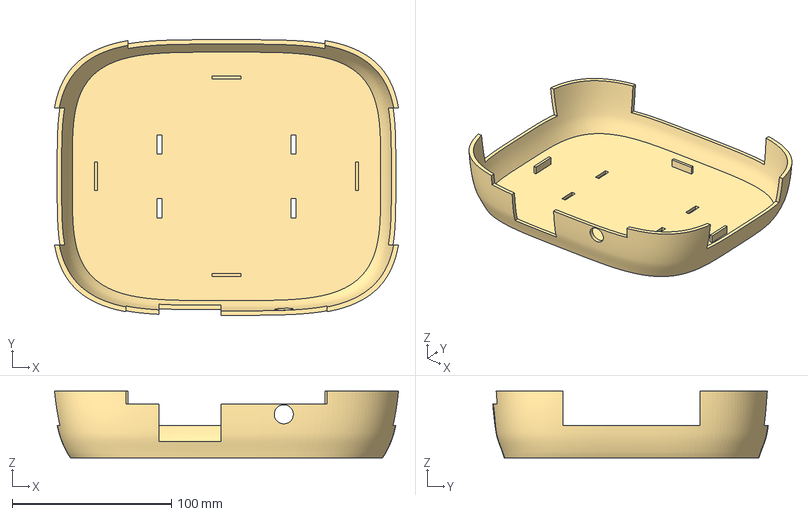
[picture p34: CAD file, 2026-11-01]
artifacts/milk-egg-protective-cover-v5/lower-shell.3mf
216.1 x 173.1 x 42.0 mm
