hecaojuanjuan/gesture-bridge/artifacts/milk-egg-protective-cover-v6-compact/milk-egg-protective-cover-v6-160mm.3mf

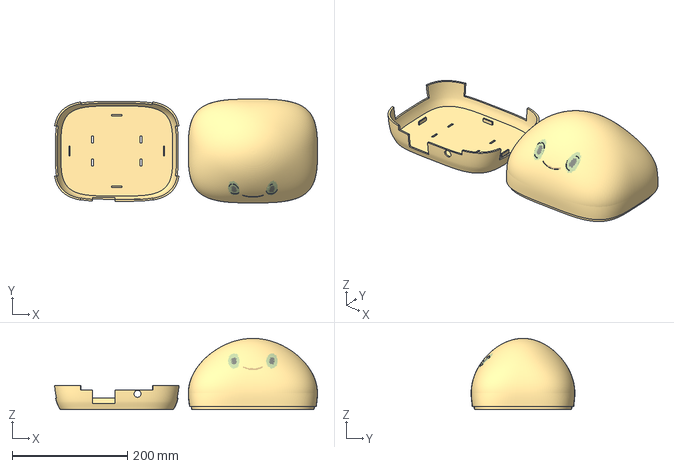
[picture p35: CAD file, 2026-11-01]
artifacts/milk-egg-protective-cover-v6-compact/milk-egg-protective-cover-v6-160mm.3mf
456.0 x 180.0 x 123.5 mm
lower_protective_shell
upper_removable_cover
