hecaojuanjuan/gesture-bridge/artifacts/milk-egg-protective-cover-v7-100mm/milk-egg-protective-cover-v7-100mm.3mf

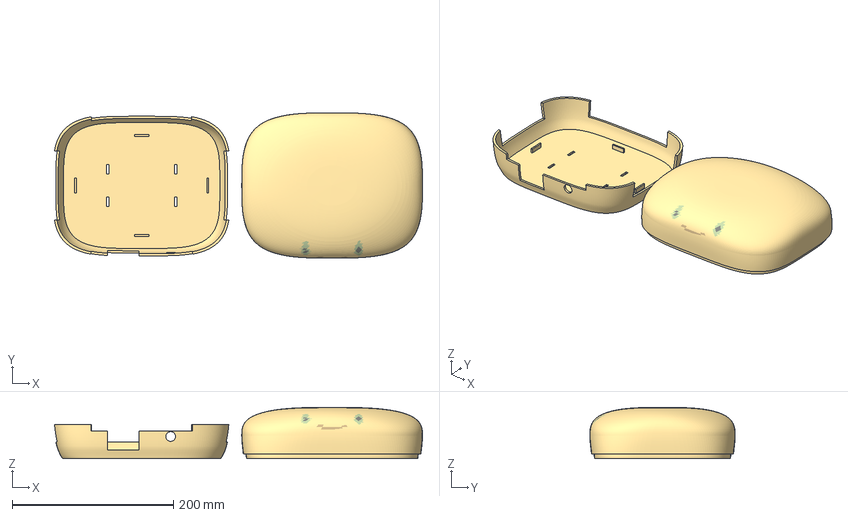
[picture p36: CAD file, 2026-11-01]
artifacts/milk-egg-protective-cover-v7-100mm/milk-egg-protective-cover-v7-100mm.3mf
456.0 x 180.0 x 63.5 mm
lower_protective_shell
upper_removable_cover
