hecaojuanjuan/gesture-bridge/artifacts/enclosure-milk-egg-v2/milk_egg_lid.3mf

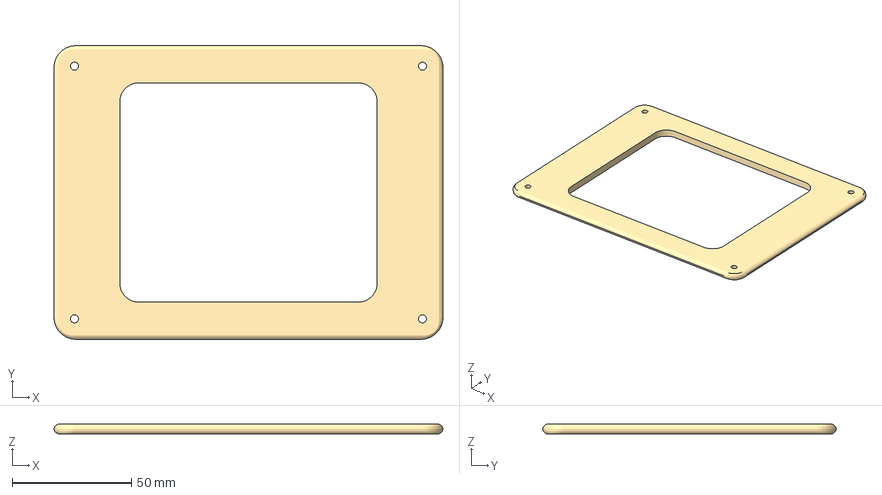
[picture p37: CAD file, 2026-11-01]
artifacts/enclosure-milk-egg-v2/milk_egg_lid.3mf
163.2 x 123.2 x 4.00 mm
