hecaojuanjuan/gesture-bridge/artifacts/enclosure-v1/enclosure_body.3mf

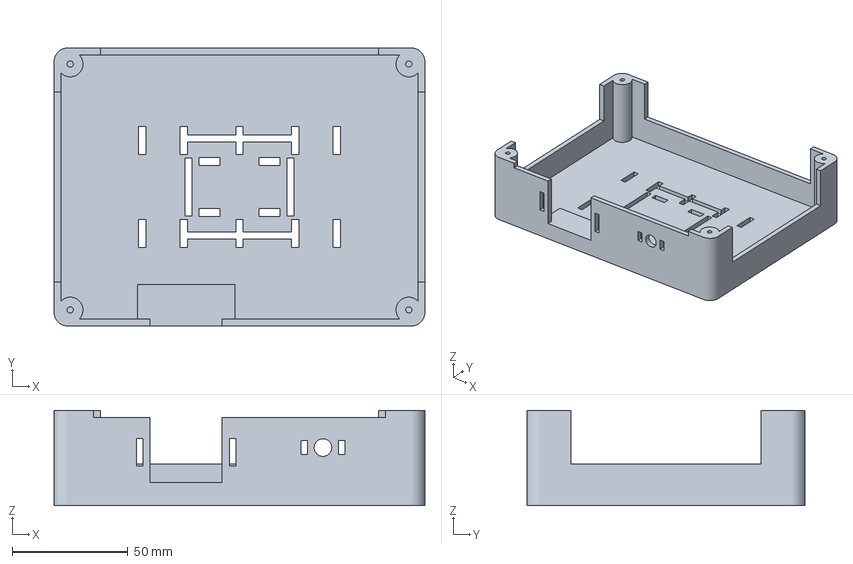
[picture p38: CAD file, 2026-10-31]
artifacts/enclosure-v1/enclosure_body.3mf
160.0 x 120.0 x 41.0 mm
