hecaojuanjuan/gesture-bridge/artifacts/milk-egg-protective-cover-v5/milk-egg-protective-cover-v5.3mf

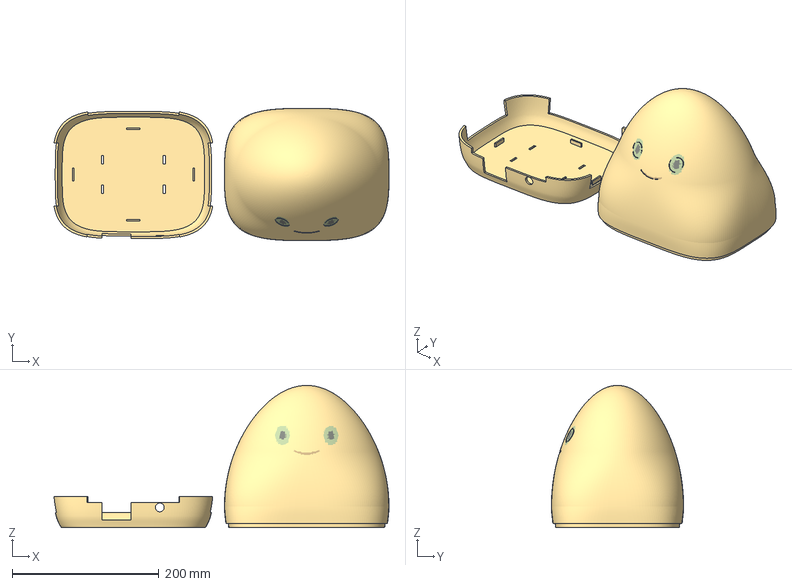
[picture p39: CAD file, 2026-11-01]
artifacts/milk-egg-protective-cover-v5/milk-egg-protective-cover-v5.3mf
456.0 x 180.0 x 193.5 mm
lower_protective_shell
upper_removable_cover
