hecaojuanjuan/gesture-bridge/artifacts/milk-egg-protective-cover-v5/upper-cover.3mf

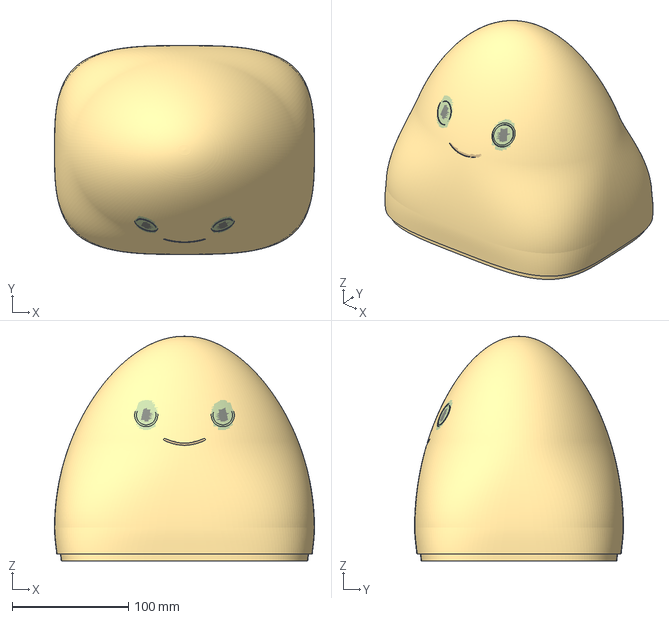
[picture p40: CAD file, 2026-11-01]
artifacts/milk-egg-protective-cover-v5/upper-cover.3mf
224.0 x 180.0 x 193.5 mm
