hecaojuanjuan/gesture-bridge/(list of files, cad)

Other CAD files:
artifacts/milk-egg-protective-cover-v6-compact/lower-shell.3mf
artifacts/milk-egg-protective-cover-v7-100mm/lower-shell.3mf
artifacts/milk-egg-protective-cover-v6-compact/seam-fit-sample.3mf
artifacts/milk-egg-protective-cover-v7-100mm/seam-fit-sample.3mf
artifacts/milk-egg-protective-cover-v3/lower-shell.3mf
artifacts/milk-egg-protective-cover-v3/milk-egg-protective-cover-v3.3mf
artifacts/milk-egg-protective-cover-v3/seam-fit-sample.3mf
artifacts/milk-egg-protective-cover-v3/upper-cover.3mf
artifacts/milk-egg-protective-cover-v4/lower-shell.3mf
artifacts/milk-egg-protective-cover-v4/milk-egg-protective-cover-v4.3mf
artifacts/milk-egg-protective-cover-v4/seam-fit-sample.3mf
artifacts/milk-egg-protective-cover-v4/upper-cover.3mf
