hecaojuanjuan/gesture-bridge/artifacts/milk-egg-protective-cover-v5/打印与装配说明.txt

奶蛋上下可拆保护壳 v5

用途：套在已经完成的旧版底盒外面。上盖盖上用于保护，使用设备和运行舵机时取下上盖。打印文件仅含新保护壳，不包含旧底盒、摄像头或舵机。

文件：
milk-egg-protective-cover-v5.3mf：两片保护壳分开放置的总文件。整套排版较宽，通常应分盘打印。
lower-shell.3mf：下壳单件，高42 mm，最大占地约216×173 mm。
upper-cover.3mf：上盖单件，含下伸定位止口，打印高193.5 mm，最大占地224×180 mm。
seam-fit-sample.3mf：对应壳体一个角部的插接试打小样，先用计划采用的材料、方向和参数打印，检查插拔松紧。小样用于检查工艺，不能代替整体试装。
milk-egg-cover-preview.png：实际网格预览。灰色旧底盒和相机支架示意不在打印文件中。
validation.json：检查报告。

尺寸与装配：
合盖外廓224×180×230 mm。下壳最高42 mm；旧底盒放在2.4 mm厚底板上，其顶面约在47.4 mm，低壳口不会比原底盒高。上下壳采用浅插接，设计径向间隙每侧0.35 mm、分缝轴向间隙0.25 mm；上盖定位边向下伸约5.5 mm，运行取下上盖后不留下高围墙。
下壳四个定位挡块与原160×120 mm底盒侧边留约1 mm间隙。可利用下壳底部绑带槽及旧底盒对应槽可逆固定。没有卡锁或防水密封；搬运时托住下壳，不只抓上盖。

功能开口：
喇叭槽中心仍对应旧模型X=-23，麦克风孔轴线仍为X=36、Z=27.4（考虑新底板抬高2.4 mm），保护壳麦克风通道放大为Ø12 mm。侧面和后部开口对应原底盒的接线检修区域。前侧上沿留宽灯窗，摄像头在去掉上盖后直接外露。
RGB板实际位置未量齐，灯窗不等于已按灯板定制；试装时需要对齐可视区域。若喇叭、麦克风或线缆实际伸出旧底盒，应再核对与外壳的距离。

打印摆放与支撑：
两个单件文件都已放在Z=0，按毫米、100%比例导入。
下壳平底朝下，开口向上。先检查底部绑带槽桥接、检修窗口及定位挡块下方；按切片结果添加局部支撑，勿让支撑堵住狭小开口。
上盖开口和定位边朝下、圆顶向上。必须在切片软件启用并检查内部支撑，支撑从大开口取出。定位边较窄，可加Brim帮助附着；止口上方台肩同样要检查支撑。不要按“完全免支撑”打印。
文件是通用几何3MF，没有嵌入特定机器的支撑或耗材配置。可先用0.2 mm层高、至少3圈外壁试切片，再按机器、材料及喷嘴调整。预计总模型实心材料体积约500左右立方厘米，另需支撑；实际耗材和耗时以切片结果为准。
上盖曲面为加厚空壳，顶部保留约5 mm封顶；有支撑仍需检查逐层预览，不能用网格检查代替打印工艺验证。

外观：
主体为奶黄色，眼圈和微笑带浅刻线；彩色眼睛由3MF表面颜色表达，不是额外散件。单色打印也能保留刻线，可打印后涂色。多色效果需要在支持的切片软件中分配颜色，显示颜色不代表已经配置对应耗材。

已做检查：
两个主体均为封闭、正体积、绕序一致且单一连通网格；3MF已由独立导入器重读。上下壳无体积重叠，与从原始3MF读取的已装配底盒无碰撞。另检查了162×122 mm的加宽旧盒包络，以及中央108×92×44 mm收纳示意范围，均无碰撞。
原云台转轴、线缆扫掠及摄像头实际外形未测量，因此该中央范围只是一项声明尺寸的收纳检查，不能当作真实云台全行程已验证。先断电试装、手动核对空间。实际配合、灯板位置和打印质量尚待实物验收。

参数化生成入口：tools/generate_milk_egg_cover.py。使用Codex捆绑的Python 3.12和项目.tools/cad依赖；源脚本保留全部尺寸与检查。
