hecaojuanjuan/gesture-bridge/artifacts/milk-egg-protective-cover-v6-compact/打印与装配说明.txt

奶蛋矮版保护壳 v6：合盖总高160 mm

报价尺寸请使用各零件打印高度：
上盖：224×180×123.5 mm；下壳：约216×173×42 mm。
上盖由原193.5 mm降到123.5 mm，降低70 mm；合盖高度由230 mm降到160 mm。
两个单件文件均已按毫米、100%比例放在Z=0。整套文件是两片分开排版，常见打印平台请分盘打印。按高度收费时，让店家根据实际摆放与支撑方式分别报价，不能只看合盖高度。

文件：milk-egg-protective-cover-v6-160mm.3mf 为两片总文件；upper-cover.3mf 为矮版上盖；lower-shell.3mf 为下壳；seam-fit-sample.3mf 为插接小样。

下壳仍高42 mm，插接位置、开口和旧底盒安装关系保留，能搭配此前下壳。上半部重新参数化压矮，眼睛、嘴巴随高度调整，呈较矮胖的圆蛋形；没有整体缩放底盒、孔位或接缝。原底盒在新底板上抬高2.4 mm，其合盖顶面位于47.4 mm。

下壳平底朝下、开口向上，检查绑带槽和窗口的局部桥接。上盖开口和定位边朝下，圆顶向上，需要在切片软件设置内部支撑，并检查定位边台肩；必要时加Brim。文件没有嵌入特定打印机的支撑和耗材参数。先试打插接小样，检查松紧，再打印完整件。

盖上用于收纳保护，运行舵机时取下上盖。没有锁扣或防水密封，搬运时托住下壳。灯板真实位置未测量，宽灯窗需要试装对齐。颜色是表面外观信息，多色打印须自行分配耗材；也可单色打印后涂色。

网格封闭、绕序一致、正体积、单一连通、3MF重新导入检查通过。与原底盒及162×122 mm加宽盒体包络无碰撞；与中央108×92×44 mm的声明收纳检查范围无碰撞。该范围不是实测云台模型，真实摄像头外形、线缆和运动全行程仍须核对。物理试装尚未验证。
