hecaojuanjuan/gesture-bridge/artifacts/milk-egg-protective-cover-v7-100mm/打印与装配说明.txt

奶蛋100 mm保护壳 v7

合盖总高：100 mm（10 cm）。外廓宽深：224×180 mm。
给打印店报价的单件尺寸：
上盖：224×180×63.5 mm。
下壳：约216×173×42 mm。
两件因止口搭接，打印高度不能简单相加当作合盖高度。按高度收费时应让店家根据各零件实际摆放、支撑和报价规则分别报价。

文件：milk-egg-protective-cover-v7-100mm.3mf 包含两片套壳，不包含旧设备；upper-cover.3mf 为上盖；lower-shell.3mf 为下壳；seam-fit-sample.3mf 为插接试打小样。整套排版较宽，建议用单件文件分盘打印。所有文件单位毫米，100%比例，零件已经落在Z=0。

为了容纳160×120 mm旧底盒，横向尺寸保持原设计；总高压低后是明显较扁圆的保护壳，无法保持原230 mm版本的竖向蛋形比例。下壳42 mm、开窗、定位挡块和插接口保留，可搭配此前下壳。原底盒放在2.4 mm底板上，其顶部约在47.4 mm。

原支架80 mm高，加旧盒3 mm安装底板和新壳2.4 mm底板，预计设备最高约85.4 mm，具体以实际摄像头、支架、螺钉及线缆为准。本版检查了原底盒、162×122 mm加宽盒体包络，以及中央108×92×44 mm的声明收纳范围，均无碰撞；这个范围并不是实测云台运动包络。物理配合、RGB灯板位置和真实相机外形尚需试装验证。

盖上用于收纳保护，运行时取下上盖；无锁扣和防水密封，搬运时托住下壳。前侧保留发声、拾音和宽灯窗，左右和后侧留接线口。灯板位置须试装对齐。

上盖开口及插接边朝下、圆顶朝上，必须在切片软件启用并检查内部支撑，顶壳下方台肩也要支撑；必要时加Brim。支撑从大开口取出。下壳平底朝下，检查绑带槽桥接和局部开口。通用3MF没有预设特定打印机支撑、材料及温度参数，先切片逐层检查，再打印。建议先试打插接小样，确认每侧0.35 mm设计间隙的实际松紧。

100 mm版本的表情使用3MF表面颜色，不含实体刻线；可选择多色打印或单色打印后涂色。显示颜色不等于自动配置对应耗材。

封闭性、绕序、正体积、单一连通、3MF重新导入、上下壳及旧底盒碰撞检查均通过。实际打印和硬件装配尚未验证。
源脚本：tools/generate_milk_egg_cover.py。
