hecaojuanjuan/gesture-bridge/docs/device-user-guide.md

# Gesture Bridge 使用说明

**接通电源后，设备会自动启动手势识别。打开配套微信小程序，完成联网后，点击设备即可进入控制面板。**

[保存开机与配网操作图（灯色核对版）](../artifacts/user-guide/gesture-bridge-user-guide-v3.png)

平台上传：[1080×1080 PNG](../artifacts/user-guide/gesture-bridge-provisioning-1080.png) · [配网说明文字（90 字符）](../artifacts/user-guide/provisioning-description.txt)

## A · 开机与手势操作

### 01 接通电源

将 USB Type-C 线插到底板，另一端接供电设备，等待设备启动。手势识别会自动运行，无需输入命令或打开电脑网页。

### 02 让完整手掌进入画面

一次伸出一只手，掌心朝向摄像头，掌根、掌心和指尖都要在镜头范围内。

### 03 做手势并保持

张开手掌或摆出 V 字，保持约 3 秒。完成后将手完全移出画面约 2 秒，再做下一次；一直保持同一个手势不会反复触发。

### 04 看灯板确认结果

上电默认显示手势状态，无需先设置灯光。

| 灯板状态 | 含义 | 接下来怎么做 |
| --- | --- | --- |
| **灯板亮绿色** | 设备已确认张掌 | 放下手，再做下一次 |
| **灯板亮蓝色** | 设备已确认 V 字 | 放下手，再做下一次 |
| **未亮灯** | 当前无确认结果 | 保持手势时未亮灯，可调整位置或光线后重试 |

做手势时观察灯板是否出现对应颜色。灯色不会一直保留；等待识别、手移出画面或结果失效时，灯板也可能熄灭。之后熄灭不撤销刚才的确认，未亮灯也不等于设备故障。

如果曾在控制面板改成自选灯色或熄灯，恢复“状态指示”后再按上表判断；“试灯 5 秒”期间也不按手势灯色判断。默认开机无需先设置灯光。

当前版本：张掌已有成功记录，V 字仍在调试；自动居中暂未启用，摄像头不会自动转动。

## B · 小程序联网与控制面板

### 已经配过网

1. 开启原来的路由器或热点，保持网络名称和密码不变。
2. 给设备上电，等待它自动连接。
3. 打开配套微信小程序，设备显示“在线”后，**点击设备，进入控制面板**。

日常开机不需要重复配网。

### 首次配网

1. 给设备上电，手机靠近设备，并打开手机蓝牙。
2. 登录配套微信小程序，点击“添加设备”，按提示允许蓝牙等权限。
3. 选择对应产品，选择 **2.4 GHz Wi-Fi**，输入密码并完成绑定。
4. 等设备显示“在线”，**点击设备，进入控制面板**。

只有 5 GHz 的网络不可用。蓝牙用于传递配网信息，通常不需要先到系统蓝牙设置手动配对。

需要语音对话时，设备在线后说 **“你好，小鹰”**，听到唤醒提示后再提问。

---

版本：2026-11-01，适用于当前张掌／V 字试用版。以上灯色对应默认状态指示。需要换网或处理设备问题时，可由维护人员查看[维护说明](device-maintenance-guide.md)。
