hecaojuanjuan/gesture-bridge/artifacts/user-guide/gesture-bridge-provisioning-square-prompt.md

# Gesture Bridge 平台上传版

- 文字：`provisioning-description.txt`，正文 90 字符，不含末尾换行；平台上限 100。
- 图片：`gesture-bridge-provisioning-1080.png`，1080×1080 PNG，须小于 10MB。
- 制作：内置 ImageGen 将已核对的 v3 操作图重排成正方形，再按平台尺寸导出。
- 导出验证：1080×1080，PNG，1,658,056 bytes（1.66MB）；文字 90 字符。已检查完整画面、中文字及 A/B 流程。

## 提示词

Edit the supplied final Gesture Bridge instruction infographic into an EXACTLY SQUARE 1:1 image for uploading to a product's mini-program provisioning page. Target output size 1080 x 1080 pixels, opaque PNG. Reflow the design for a square canvas, rather than distorting, cropping, or adding large blank side borders to the portrait source. Preserve the familiar cream, green and blue color scheme, clean Chinese sans-serif type, rounded cards and simple icons. Use a much smaller header than the original so the two columns remain legible at 1080 pixels. Header should take only about 13% of image height. Main content is ONLY two equal columns A and B, aligned at the bottom, with readable text. Small icons can be reduced or removed where needed to improve typography. No developer commands or webpages, no extra sections, no QR code.

Exact header text:
Gesture Bridge｜开机与配网指南
上电做手势 · 小程序联网后进入控制面板

Left column:
A  开机与手势

01  接通电源
接上 USB 电源，等待启动
手势识别自动开启

02  完整手掌入镜
掌心朝镜头，掌根和指尖都要入镜

03  保持约 3 秒
张掌或 V 字，完成后移出画面约 2 秒

04  看灯板确认
上电默认显示手势状态
绿灯｜已确认张掌
蓝灯｜已确认 V 字
未亮灯｜当前无确认结果

Use a single green dot beside the green status, blue dot beside the blue status, hollow gray circle for unlit. No lamp with multiple colors illuminated simultaneously.

Small legible notes INSIDE A at the bottom:
灯色可能短暂出现，熄灭不撤销刚才的确认。
自选灯色、熄灯、试灯时不按此判断。
V 字仍在调试；自动居中暂未启用。

Right column:
B  小程序联网
联网方式：二选一

First alternative:
已经配过网
开启原路由器或热点
设备自动连接，无需重复配网

Divider: 或

Second alternative:
首次配网
打开手机蓝牙
进入配套微信小程序
点“添加设备”并允许权限
选择对应产品与 2.4 GHz Wi-Fi
输入密码，完成绑定

Two alternatives converge into:
设备在线，打开面板
小程序显示“在线”后
点击设备，进入控制面板

Legible notes INSIDE B:
仅支持 2.4 GHz Wi-Fi。
要对话时说“你好，小鹰”，听到提示再提问。

Constraints: EXACT square 1:1 final artwork, preferably 1080x1080. Do not stretch or squash the portrait source. Keep all characters crisp, exact, correctly spelled and readable. No omitted status caveats. No visible pixel-size labels or upload-size instructions. Right networking choices are alternatives, never sequential steps. Produce a finished, complete, attractive simple end-user guide.
