hecaojuanjuan/gesture-bridge/artifacts/user-guide/gesture-bridge-user-guide-v3-prompt.md

# Gesture Bridge 用户操作图 v3：灯色核对版

- 工具：内置 `image_gen.imagegen`，基于 v2 编辑。
- 输出：`gesture-bridge-user-guide-v3.png`。
- 依据：默认状态指示；张掌绿、V 字蓝；未亮灯不是独立失败信号；灯色不是永久成功记录；手动灯色和试灯会覆盖状态输出。
- 已目视核对最终图片：仅 A/B 两栏，04 显示三种灯色含义，移除绿蓝同时亮的实物示意，保留熄灭不撤销确认及非状态模式说明。B 小程序流程保持；未新增实机验证。

## 编辑提示词

Edit the supplied Gesture Bridge Chinese user instruction infographic into the final code-checked version. Preserve the overall header and TWO-COLUMN A/B layout, cream background, green A lane, blue B lane, clear large Chinese sans-serif typography, rounded cards and friendly flat icons. Preserve all existing title text, A steps 01–03, and every word and icon of the right B networking column. Do not add a third section, any commands, developer instructions, computer webpage, diagnostic screens or QR codes. Keep the product name exactly Gesture Bridge.

Change only the A column step 04 and its bottom notes. Make the bottom of A slightly taller if needed for readable text; the two columns should end on the same baseline. Do not shrink body text to tiny footnotes. Keep all content fully within the canvas.

Replace all text in card 04 with these exact lines:

04  看灯板确认结果
上电默认显示手势状态
绿灯｜已确认张掌
蓝灯｜已确认 V 字
未亮灯｜当前无确认结果
保持手势时未亮灯，可调整位置后重试

Show three labeled status rows with ONE solid green dot, ONE solid blue dot and ONE hollow gray circle, respectively. The gray circle means unlit, not emitting gray light. Remove the existing small black physical lamp illustration showing green and blue bulbs lit simultaneously: the hardware actually fills the whole board with only one color at a time. No replacement physical lamp illustration is necessary; use just the three clear color dots as the legend. Do not show a red failure lamp or label an unlit board as definite failure.

Replace the existing bottom notes within column A with these THREE concise exact lines, with small neutral bullet marks:
灯色可能短暂出现；之后熄灭不代表刚才失败。
自选灯色、熄灯或试灯时，不按此判断。
当前 V 字仍在调试；自动居中暂未启用。

Important: this is a SIMPLE END USER card. All wording must be exact, no technical elaboration or extra notes. It must still only contain the header and A/B columns. Right B remains the two mutually exclusive connection alternatives and ends with clicking the online device to enter the phone control panel. Render the complete final corrected infographic, without cropping.
