hecaojuanjuan/gesture-bridge/artifacts/user-guide/provisioning-description.txt

接通电源，手机开启蓝牙并授权。首次使用时，打开小程序点击“添加设备”，选择2.4GHz Wi-Fi并输入密码完成绑定。设备在线后，点击设备进入控制面板。已配网设备会自动连接原网络。
