hecaojuanjuan/gesture-bridge/artifacts/panel-combined-20261101/setup-desktop.jpg

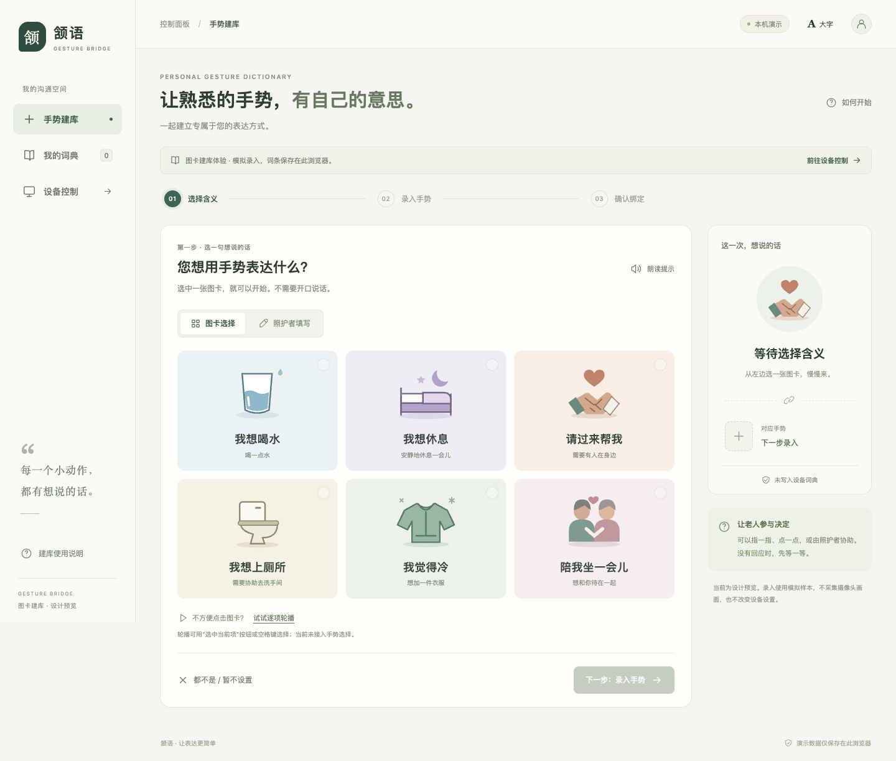
artifacts/panel-combined-20261101/setup-desktop.jpg
