hecaojuanjuan/gesture-bridge/artifacts/panel-combined-20261101/setup-mobile-large.jpg

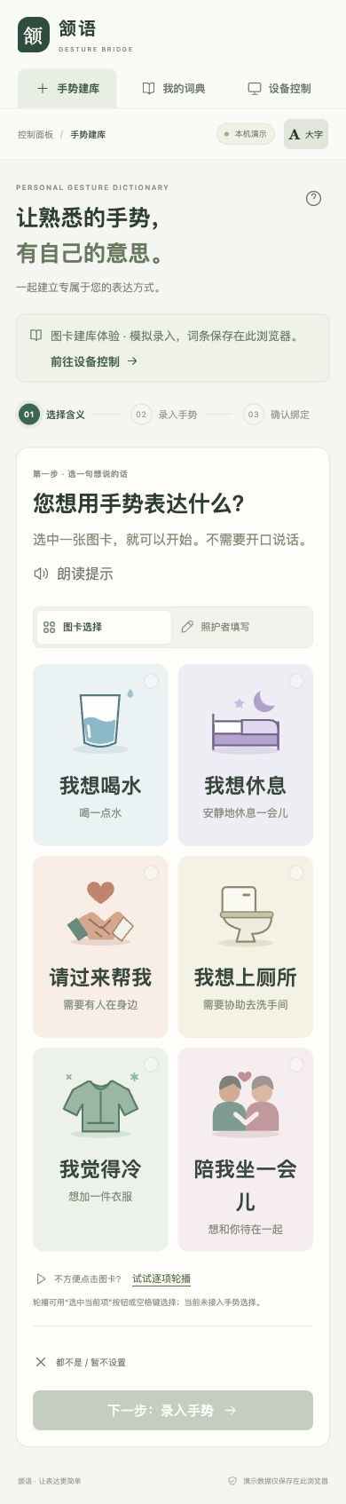
artifacts/panel-combined-20261101/setup-mobile-large.jpg
