hecaojuanjuan/gesture-bridge/artifacts/panel-design/gesture-setup-capture.jpg

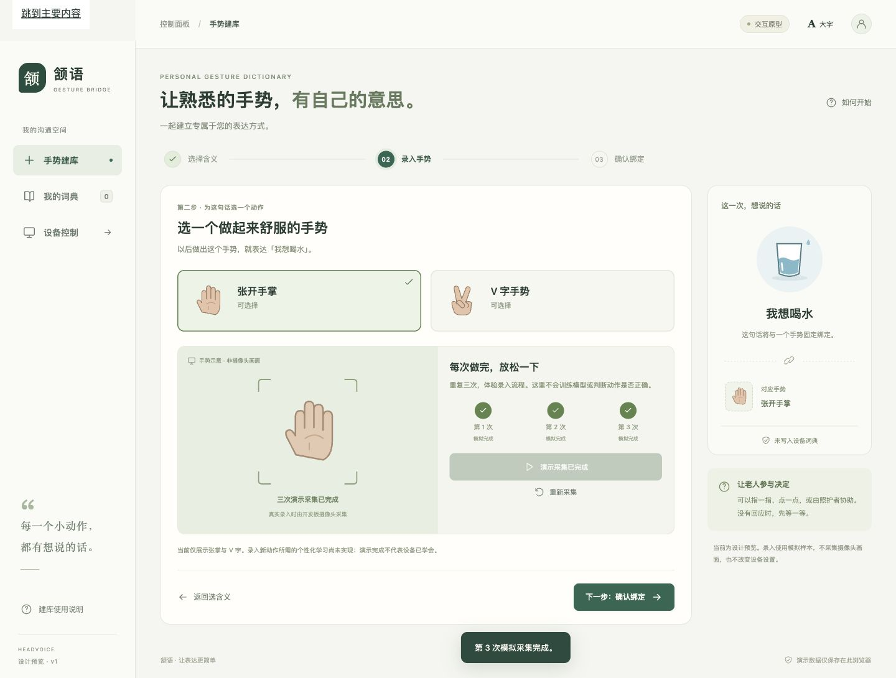
artifacts/panel-design/gesture-setup-capture.jpg
