hecaojuanjuan/gesture-bridge/artifacts/panel-design/gesture-setup-confirm.jpg

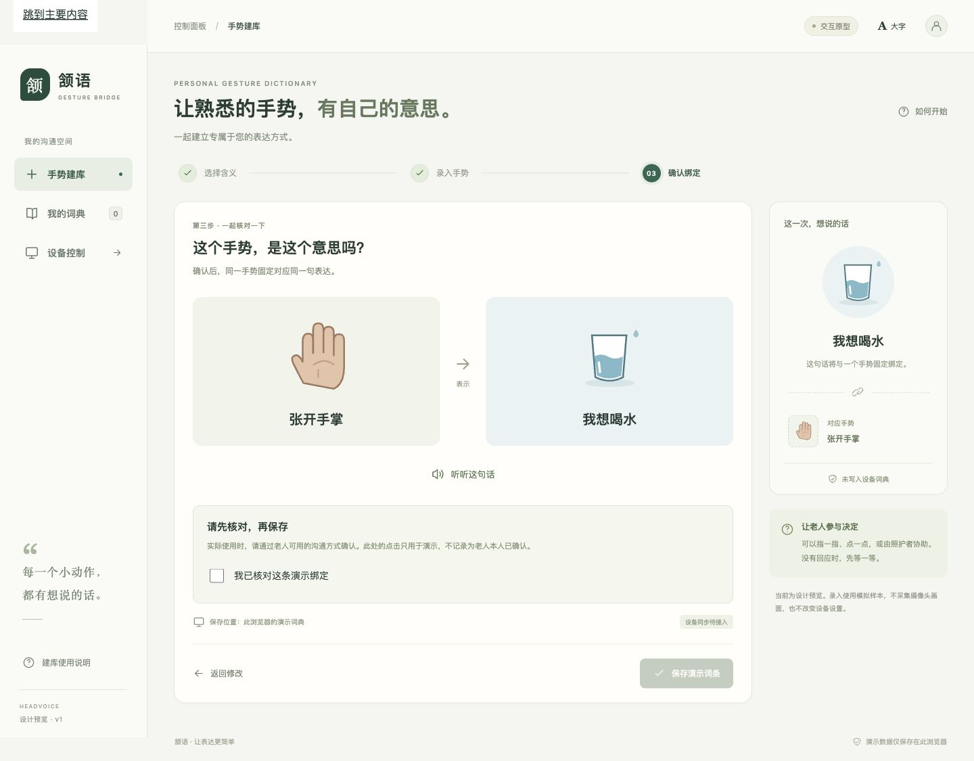
artifacts/panel-design/gesture-setup-confirm.jpg
