hecaojuanjuan/gesture-bridge/artifacts/panel-design/gesture-setup-desktop.jpg

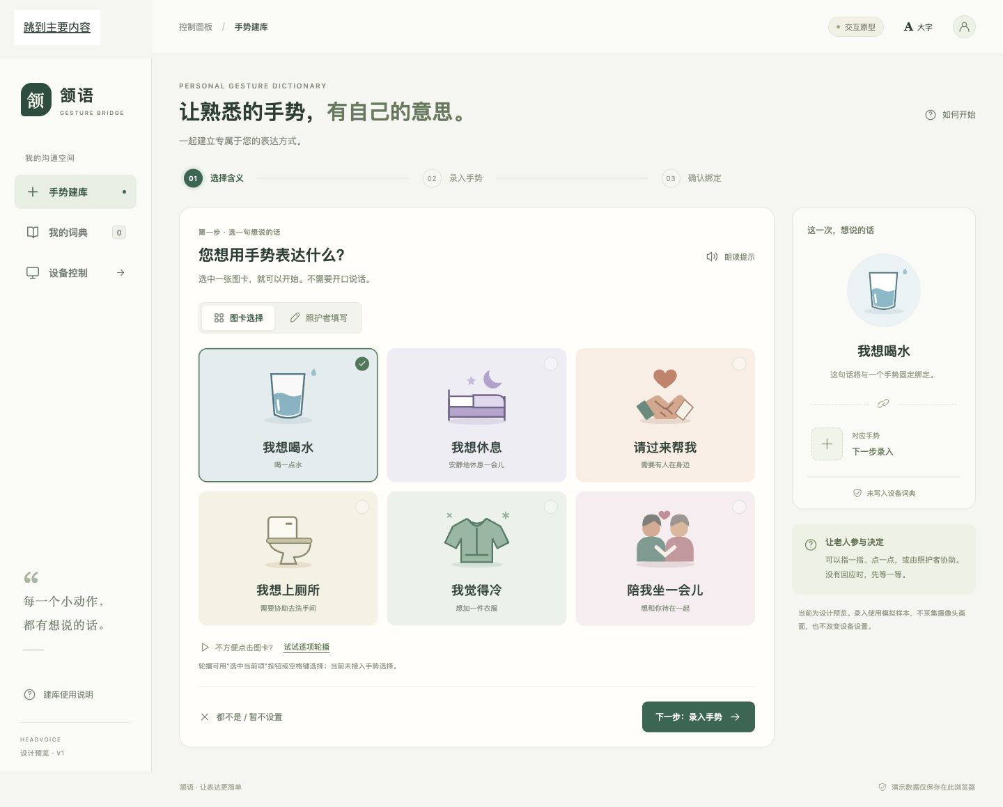
artifacts/panel-design/gesture-setup-desktop.jpg
