hecaojuanjuan/gesture-bridge/artifacts/panel-design/gesture-setup-mobile.jpg

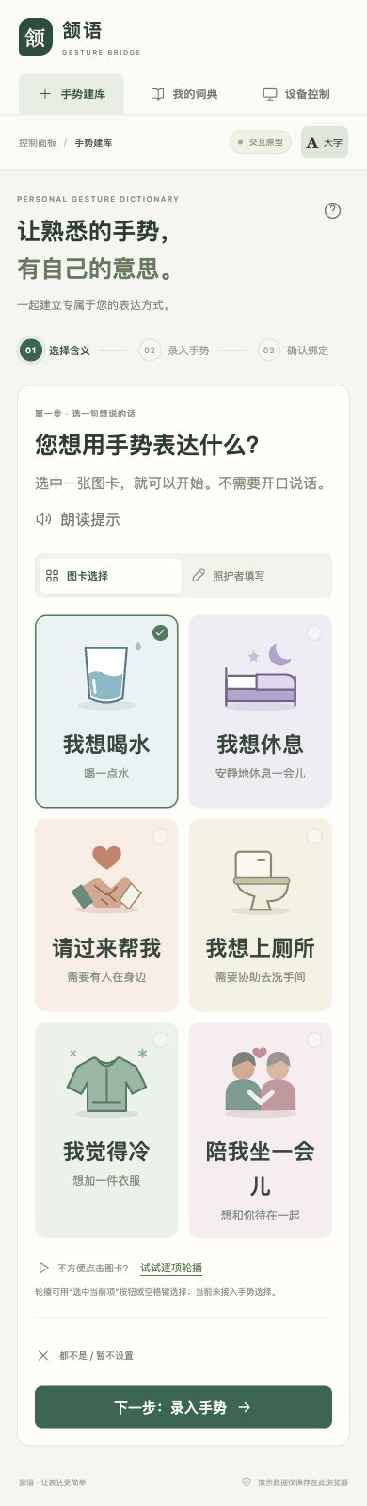
artifacts/panel-design/gesture-setup-mobile.jpg
