hecaojuanjuan/gesture-bridge/artifacts/provisioning-guide-20261031.png

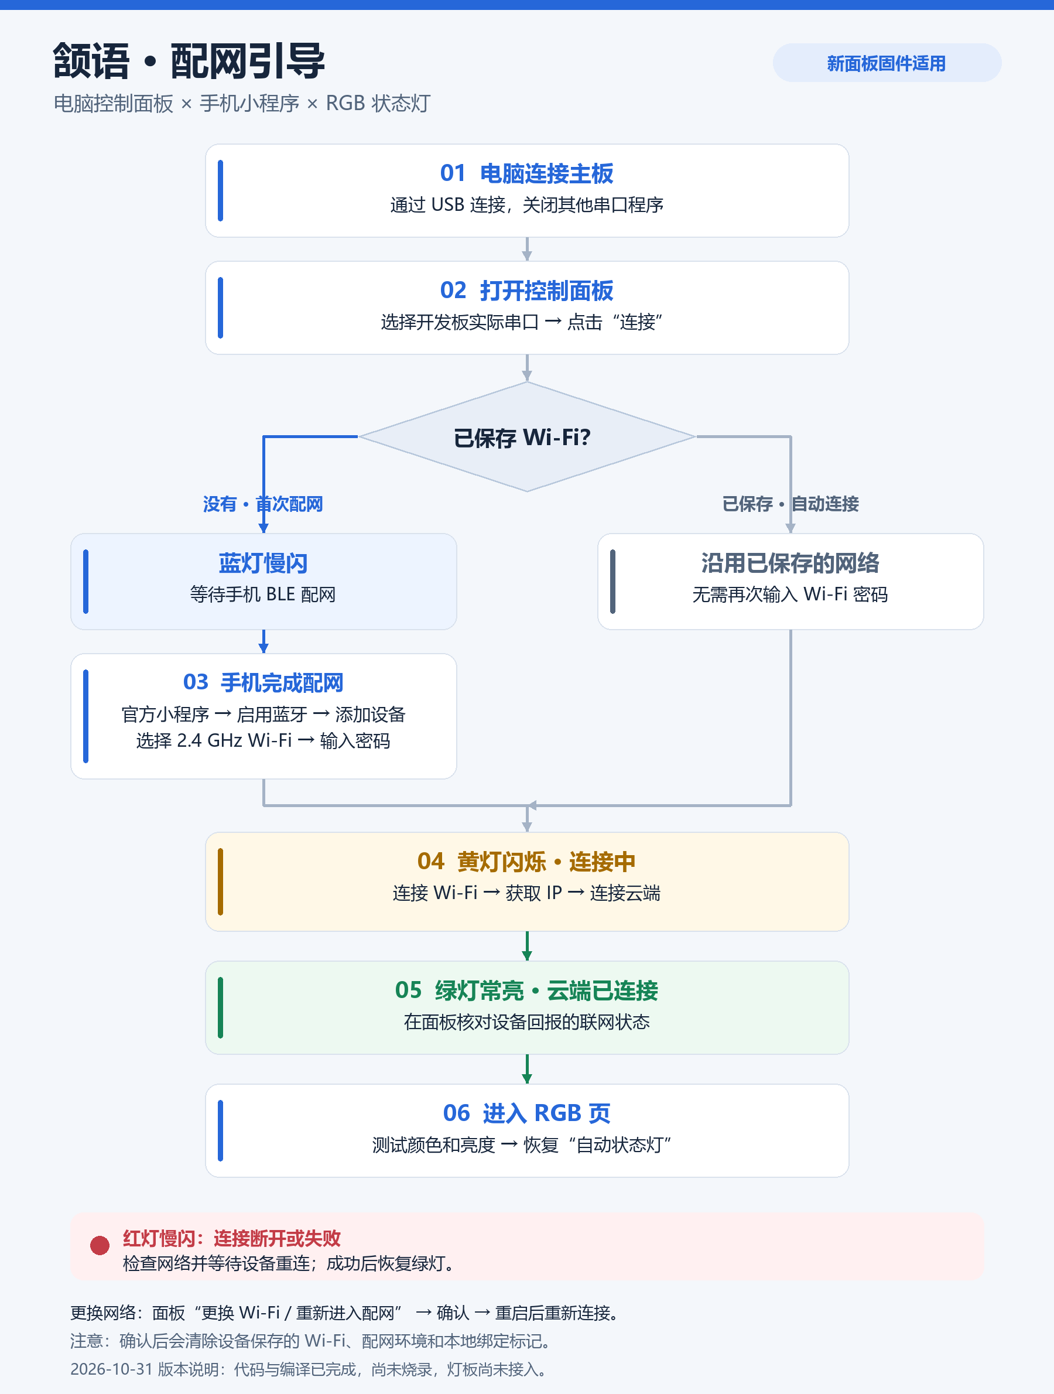
artifacts/provisioning-guide-20261031.png
