hecaojuanjuan/gesture-bridge/artifacts/user-guide/gesture-bridge-provisioning-1080.png

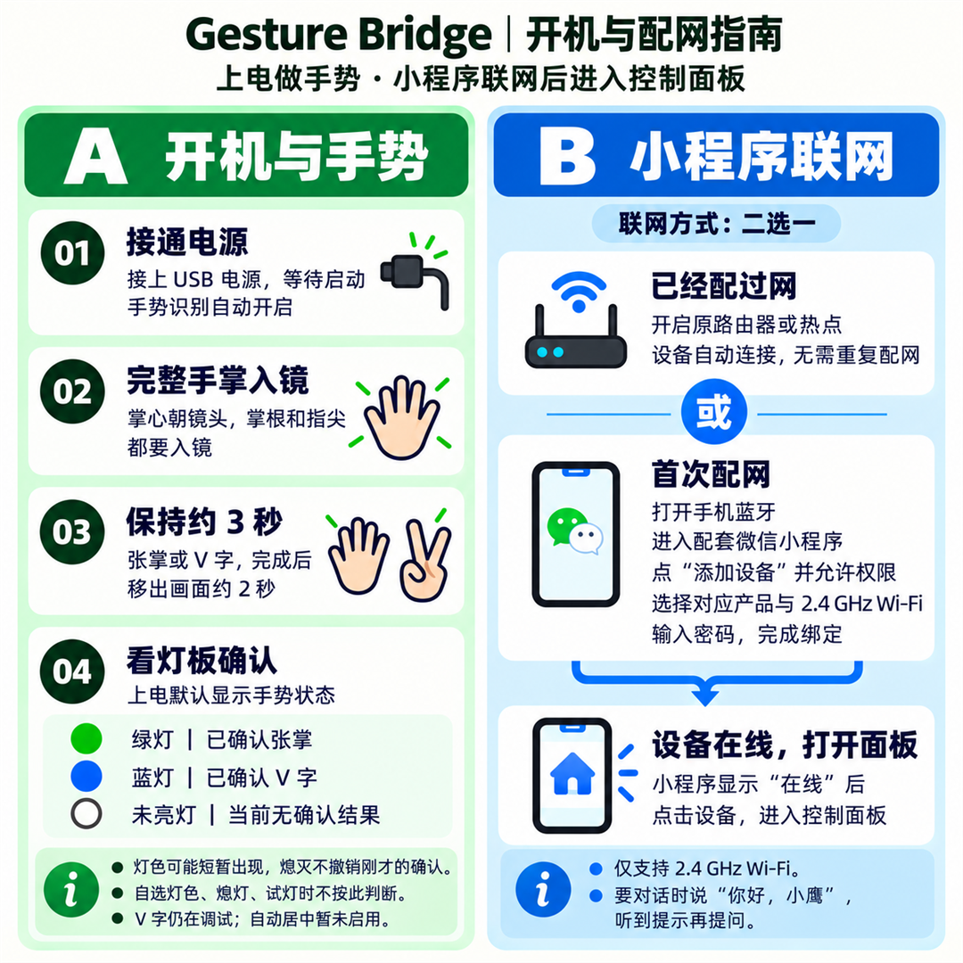
artifacts/user-guide/gesture-bridge-provisioning-1080.png
