hecaojuanjuan/gesture-bridge/docs/validation.md

# 验证记录：2026-10-24

## 环境与基线

- 项目：`C:\Users\jiawa\Desktop\gesture-bridge`，初始只有 README、Git 忽略规则，无已有 SDK。
- 官方来源：`https://gitee.com/xj-open/ljyd_xjwb03_agent_public_developer.git`。
- 下载 HEAD：`89020f5e04bf777ae1672b8f3d320bc6e0ef3e0c`，与参考提交差异为空；vendor 不修改。
- 框架：仓库自带 ESP-IDF 5.4.1，Xtensa GCC 14.2.0，目标 ESP32-S3。
- 工具：项目内 `.tools`，Python 3.12.14，C 主机编译器 Zig 0.13.0，clang-format 19.1.7。
- 串口：仅 COM1，硬件 ID `ACPI\PNP0501\SERIALIOUART1`。未发现 USB 开发板，未烧录。
- 参考文档只作为设计资料；本轮使用用户明确给出的第一阶段范围。

## 实际执行

`tools/test_core.py` 编译并运行 `headvoice/core/hv_core.c`，启用断言、`-Wall -Wextra -Werror`。测试使用带时间戳的合成观察，不声称识别真实头部动作。

通过的生产核心逻辑测试：四组合映射；候选不自动播放；新中立与新动作确认；持续动作只在回正后消费一次；取消；组合/确认过期；无效追踪取消半组合及待确认候选；恢复不拼接；过期/重复帧；动作方向突变；播放票据去重；播放后回正；稳定连续校准。

音频已通过 WAV 格式检查和缓存字节/SHA-256 检查。离线合成源是本机 Microsoft Huihui Desktop；人工听测标记保持 false。

官方基线已成功生成完整固件，应用大小 `0x2f8f70` 字节，应用分区剩余约 25%。构建脚本通过 CMake 响应文件解决本机长路径的命令行上限，补齐 ROM ELF 目录和 Windows 架构环境；没有更改官方功能代码。

HeadVoice stage 3 完整固件已成功编译，应用大小 `0x321b10` 字节，应用分区剩余约 20%；官方模型仍在完整烧录清单的 `0x810000` 地址。没有改变分区表。生产核心的主机回归、缓存音频身份检查、Python 脚本语法、PEP 8 和 C 格式检查均通过。

构建结果及镜像哈希在完成编译后由 `artifacts/build-summary.json` 记录；完整本机日志为 `artifacts/baseline-build.log`、`artifacts/headvoice-build.log`。生成接入差异见 `artifacts/integration.patch`。

## 待上板验证

| 项目 | 当前结果 |
| --- | --- |
| 官方联网与真实语音对话 | 未连接硬件，未测 |
| SPI 有效帧率、图像方向与色序 | 未测；有连续采集代码 |
| 单人、遮挡、多人识别质量 | 未测；代码公开人数及关键点有效性 |
| 有符号眼线倾斜与 A/B 可分性 | 数学特征测试通过，真人效果未测 |
| 摄像头、模型、联网语音并发 | 固件路径已实现，设备压力测试未测 |
| 真人 AA/AB/BA/BB、保持、取消、恢复 | 主机状态逻辑通过，实机未测 |
| 黄灯、蓝灯与设备喇叭 | 真实驱动接入，电气及可听输出未测 |
| 有效姿态频率、推理耗时、内部/PSRAM 余量 | 有串口测量代码，无实测数字 |
| 确认到实际出声延迟 | 未测；软件状态估计不能替代可听测量 |

## 源码核实与最小接入

- 官方摄像头只统计帧。新增借用帧回调，复制后立即归还驱动缓冲；应用槽固定为两个，待处理槽最多一个。
- 官方 RGB 推理 API 已存在；连续链路直接调用它，禁用静态 bus.jpg 启动示例。
- 官方 `yaw`/`roll` 为绝对二维比例，不用于动作识别。直接公开双眼坐标，以 `atan2(dy,dx)` 折叠至 ±90° 的图像眼线特征供独立 C 核心消费。
- 官方 YOLO 后处理已将低可见性关键点写成零；再要求单人、人体分数 ≥0.5、鼻/双眼有效且在图像内、眼间距 ≥4 像素。没有虚构额外的人脸追踪 API；误检/漏检需要实测。
- 固定词典及缓存音频由本地代码管理；没有调用文档中拟定的 `hv.*` 平台 API。
- 正式表达使用独立官方 `qm_audio_control` 与常驻 PCM，按真实 operation 状态检查完成/抢占/错误并释放。未知播放结果不自动重试。
- 官方资源模式只关闭上传，无法独占 TTS；因此确认后先结束当前会话，再短暂占用音频。联网不关闭，后续唤醒仍走官方入口。

以上是第一阶段原型与编译/主机验证交付，不是完整产品或赛事验收结论。

## 2026-10-25 上板补充

- 已连接 CH343 开发板 COM3，读取并保存真实串口日志。
- 更正喇叭接线后，使用官方开机音效实测，使用者确认有声音。官方播放完成日志仍报告 `ret=-6`，不能将其记为无错误完成，后续本地词典播放需要继续核查。
- 已支持 `.local/cloud.json` 的本机产品身份覆盖，四项配置回归测试通过。密钥只保存在 Git 忽略的本机配置及应用副本中，不写入接入补丁；官方 vendor 保持干净。
- PID 11785 的官方基线编译、完整烧录与镜像校验成功，复用已保存的 Wi-Fi；实机动态注册到新设备身份并出现 `cloud connected`。
- 新 PID 下已观察到唤醒及 RTC 连接，但本次记录尚未见远端智能体加入、ASR 或 TTS；使用者确认新产品尚未绑定 AGENT。绑定后需继续验证完整语音对话，不能由旧示例产品的对话记录替代。
- 相同 PID 的 HeadVoice stage 1 编译通过，尚未烧录。摄像头尚未接线，姿态、动作、灯光、固定短句及延迟均仍待实测。
- 当前上板摘要与固件哈希见 `artifacts/onboard-summary.json`；原始串口 `.jsonl` 由 Git 忽略。

### 新设备重新配网与账号绑定

新增 `hv_provision status|restart`，在官方基线和 HeadVoice 中都可用；只通过显式 `restart` 调用 SDK 既有的复位配网函数。两种固件均编译通过，官方基线已烧录并校验。实机确认 PID 查询和无参数帮助不会重置设备；随后执行复位配网，观察到 `no saved wifi`、`ble provision start ret=0`、BLE 连接、SSID 下发、Wi-Fi 获取 IP、PID 11785 / DID 100000766 动态注册及重新连云。使用者确认小程序内新设备已绑定并在线。

此后首次观察到远端语音智能体 `uid=100` 加入，说明重新配网绑定补齐了此前缺少的链路。仍未在本轮记录看到 ASR/TTS，使用者报告仅有提示音；完整联网语音基线仍未通过。后续需核对语音输入/输出配置，并区分麦克风上行、唤醒打断恢复和网络问题。不得将网页文字预览正常或远端入会视为设备语音通过。

### 基础语音实机联通

新增只统计数据的 `hv_voice stats|debug`。设备 PCM 入口和 Agora 实际发送函数的诊断接入位于 `.work` 的源码副本，vendor 不修改；不保存原始录音。诊断基线编译、应用烧录及镜像校验通过，保留新设备配网数据。

实测麦克风字节率中位数约 31989 B/s，RTC 上行约 50 包/秒，观测窗口内发送错误为 0。串口收到完整 ASR“现在几点了？”，随后收到云端 TTS 并启动播放；使用者确认听到语音回答，基础联网语音联通得到实机验证。完整采集仍记录到 135 条 `audio enqueue failed ret=-7`，开机音效完成也有 `ret=-6`，因此不宣称语音稳定性或并发验收通过。按使用者要求，本轮未切换或排查网络。

下一步为摄像头 stage 1；摄像头仍未接线。有效姿态频率、推理耗时、运行内存及固定词典实际播放延迟保持未测。

## 2026-10-26 摄像头 stage 1 实机测试

- 使用者接好摄像头后，重新识别到 CH343 开发板 COM3。核对现有 HeadVoice 固件为 stage 1，SHA-256 与上次编译记录一致；完成全部镜像烧录和哈希校验，未执行整片擦除或复位配网。
- 重启后采集约 120 秒串口日志。成功检测到 BF3901，传感器 PID 为 `0x3901`；驱动报告 `240x320`、fourcc `0x59565955`（UYVY），缓冲和取流任务启动成功。
- 最后一条批次统计为 `frames=2190 good=0 empty=2190 last_bytes=0`。因此仅确认传感器配置通信和取流任务启动，连续有效图像采集未通过；这些空帧回调不能视为有效摄像头帧率。
- 采集窗口未观察到崩溃、掉电告警或重复启动，也未见 `cloud connected`；本轮没有重新验证联网语音或排查网络。
- 源码核对发现 SPI 视频层会在帧解码失败时将有效长度置零；现有日志不足以区分数据接线、信号时序和帧解析问题。下一步断电核对 `VSYNC→GPIO4`、`PCLK→GPIO13`、`D0→GPIO8`，确认未误用 HREF，然后复测；不能由传感器 ID 可读推断图像数据线正确。
- 另发现 `HV metrics` 的 64 位时间格式在设备日志中输出异常，整行字段不可作为可靠内存或频率数据，待单独修复。上述摄像头计数来自 `bsp_camera`，不依赖这类 metrics。
- 本轮未启用 stage 2/3，姿态识别、真人动作和固定词典播放仍未验证。测试摘要见 `artifacts/camera-stage1-summary.json`；原始串口与烧录日志由 Git 忽略。

### 改线后的 stage 1 复测

- 使用者确认两根线接反并已改正；未说明具体是哪两根。复用相同 stage 1 固件，不修改摄像头配置、不重新烧录，COM3 重启后重新采集约 120 秒日志。
- BF3901 再次被识别，格式仍为 `240x320 UYVY`。最后一条批次统计为 `frames=2160 good=2160 empty=0 last_bytes=153600`；全部 72 条批次报告均为完整帧，计数持续增长，空帧计数始终为零。
- 按首末批次的设备时间戳和有效帧数增量计算，取帧频率约 18.26 Hz；这不是姿态推理频率，也不是实际曝光时间测量。
- 采集窗口只有一次启动，未观察到崩溃、掉电告警或重复启动。改线后此前空帧现象消失，stage 1 连续完整帧采集通过；画面内容、色序与方向尚未目视验证。未见 `cloud connected`，本轮不宣称联网语音并发通过。
- stage 2/3 尚未启用，姿态频率、真人动作、自定义动作学习和固定词典播放均未测试；已知 `HV metrics` 格式问题仍待修复，不采用其内存读数。
- 通过摘要见 `artifacts/camera-stage1-retest-summary.json`，之前的失败摘要保留；原始日志为 `artifacts/camera-stage1-retest-20261026.jsonl`。下一步启用 stage 2，核对真实姿态输出与画面方向。

## 2026-10-26 stage 2 姿态识别与预览实测

### 接入修复与实际固件

- 新增 `hv_camera snapshot` 和 `tools/camera_preview.py`，将一次借用的完整原始帧复制到有界独立缓冲，在低优先级任务转换为小尺寸 RGB565 并导出。电脑端校验块顺序和整帧 FNV-1a 后生成 PNG，不上传图像。原始借用缓冲仍按原路径立即归还。
- 新增 4 项预览测试覆盖 RGB565 颜色通道、PNG CRC、顺时针旋转、缺块及损坏数据拒绝；连同既有 4 项产品配置测试共 8 项通过。Python 与 C 格式检查通过。
- 通过实际失败日志和本机 IDF Kconfig 确认：nano printf 不支持 64 位整数格式，导致 HV JSON 字段错位。仅在 HeadVoice 的 SDK 副本中关闭该选项；实机 JSON 解析恢复正常，官方 vendor 未改动。
- stage 2 初测发现额外约一轮推理的旧帧滞留：有空闲槽时尝试写满的 pending 队列，导致丢弃新帧、保留旧帧。修复为优先取回并替换 pending 槽，同时统计替换丢弃；初测额外帧龄最高 2972ms，修复后确认样本的非推理帧龄最高 129ms。
- 当前固件为 stage 2、顺时针旋转 90°、不反转倾角，SHA-256 为 `785638753fe489906aaf97a9bb042b472e44d97d62e968ba75550879e9c6cd25`，应用大小 3073680 字节。应用烧录及哈希校验通过，分区与模型保持原先已完整烧录的版本，未清除配网。

### 当前场景下的姿势抽样检查

测试为单人、单场景、每种姿势一次静态保持，不是多次独立动作准确率，也没有参考仪器测量真实头部角度。每个确认段先收到使用者保持该姿势的回复，再拍摄一张预览核对，随后采集约 25 秒。排除前 5 秒及在途旧结果；依据接收时刻减去设备报告帧龄估计采集时刻，不将串口接收时间直接视为曝光时间。

前期仅按聊天提示计时的段落未作为正式标签；特别是第一次遮挡段仍检出人，之后改为显式确认并用预览核实遮挡。以下仅统计确认后的样本：

| 确认姿势 | 稳定段样本 | 人与关键点结果 | 图像眼线倾角 |
| --- | --- | --- | --- |
| 自然中立/遮挡后恢复 | 7 | 7/7 单人且关键点有效 | −16.70°～0°，中位数 0° |
| 向自己的左肩侧倾 | 7 | 7/7 单人且关键点有效 | +16.70°～+25.71°，7/7 为正 |
| 向自己的右肩侧倾 | 6 | 6/6 单人且关键点有效 | −45.00°～−25.71°，6/6 为负 |
| 遮挡 BF3901 镜头 | 7 | 7/7 为 0 人、关键点无效 | 拒绝使用 |

确认样本共 27 个。推理耗时中位数 2676ms、P95 2802ms、最大 2845ms；帧龄中位数 2721ms。按相邻采集时间中位间隔折算，姿态结果产出约 0.373Hz。非推理帧龄中位数 53ms、最大 129ms，旧 pending 帧回归检查通过。

所有 27 个结果均超过当前 400ms 帧龄限制，因此实时有效输入为 0，未放宽限制、未启用 stage 3。能够识别左右符号和遮挡不等于已满足连续动作、保持、回正的输入要求。中立时读数跨度达 16.7°，当前取景和关键点稳定性仍需改善；本轮没有用同一批样本调参后再宣称准确率提高。

确认段的 47 条摄像头批次报告均为完整帧，空帧计数为 0。未观察到崩溃或复位；内部空闲内存为 72103 字节，PSRAM 空闲最低 3332792 字节。未验收联网语音并发、多人、动态动作、四个编码、个人学习或正式短句播放，舵机未启用。

汇总见 `artifacts/pose-accuracy-summary.json`，原始日志为 `artifacts/pose-trial-*-20261026.jsonl`（Git 忽略），实际预览保存在 `.local/pose-*-confirmed.png`（Git 忽略）。下一步优先评估更适合头部关键点的实时定位链路，改善中立抖动并满足有效观察频率，再重新测试完整动作输入。

## 2026-10-29 语音无回答诊断与基线恢复

- 使用者报告开机有音效，但语音对话没有反应。重新识别 CH343 COM3；未清除配网、账号绑定或模型分区。
- 当前 HeadVoice stage 2 启动后观察到 Wi-Fi 获取 IP、`cloud connected` 和持续麦克风 PCM，但约 39 秒时发生 `InstrFetchProhibited` 崩溃并重启。设备 ELF 摘要 `eb6ae65ea` 与本地 ELF 哈希匹配；回溯经过 `esp_vApplicationTickHook`、SysTick 与 idle task，回调执行地址无效。已确认崩溃事实，尚未确认造成损坏的代码或修复根因，不能据此断言是模型、供电或网络造成。
- 核对已知基线应用 SHA-256 `a7573af7c69ba0f9e64ec355d948926b4f542af90d8bc438bd1390a796b6fbdb`、PID 11785 和相同分区表后，只烧录基线应用并校验成功。当前板上模式为 baseline，新增摄像头预览和连续姿态任务暂不可用；不把这次回退记为 HeadVoice 稳定性修复。
- 首次基线对照记录到两次真实“你好小鹰”唤醒、RTC 入会和远端 `uid=100` 加入；上行停在 380 包，麦克风仍持续增长。第二次唤醒走打断路径；另有 SDK 数据流超时。现有证据不足以确定停止上行的根因，也不能证明由重复唤醒单独造成。直接说普通句子仍未恢复。
- 只重启运行会话后，再做一次干净的单次唤醒对照：等待连云，说一次“你好，小鹰”，约 3 秒后询问“现在几点了”。设备收到完整 ASR、云端 TTS 并启动播放；使用者确认有语音回答。随后日志又观察到两轮 ASR/TTS，证明本窗口基础对话链路恢复。
- 本轮采集不保存原始录音，不改变网络或平台配置。基线测试窗口未再观察到 panic，但不宣称长期稳定、摄像头/语音并发或 HeadVoice 问题已解决。
- 机器可读摘要见 `artifacts/voice-diagnosis-summary-20261029.json`；原始串口及烧录日志由 Git 忽略。当前模式另记录在 `artifacts/onboard-summary.json` 的 `current_firmware` 中，早先构建与实测记录保留为历史。

## 2026-10-30 双轴取景、PWM 与重复重启排查

- 重新识别 CH343 COM3；运行双轴云台模式，预览可用，按需定位，未启用连续动作识别。使用者确认支架和两只 SG90 已安装，P17 为水平、P18 为俯仰，独立 5V 电源已开启且与主板共地。
- 初次预览只有墙面/天花板。调整后图像可见真人头部，但位置靠近底边、双肩未入镜，模型两次返回 `people=0`。这表示模型漏检当前取景，不能据此称画面中没有人。
- 分轴手动试动后，背景位移不稳定，方向和自动居中尚未通过。后续发现运行中发生重启，先前跨重启的图像和脉宽记录不足以证明机械响应，更不能据此确定舵机故障。
- 新增 `hv_gimbal pwm`。关闭时 GPIO17/18 各采样 5000 次，高电平及上升沿均为 0；两轴开启至 1500µs 后配置均为 50Hz、14 位 duty=1228，各采样到 283 次高电平及 2 次上升沿，采样窗口 54328µs。只证明主控引脚存在 PWM，未测舵机插头端信号、电压或转矩。
- 使用者报告没有手动重启，但设备反复重连热点。保持 PWM 关闭，被动采集 65 秒，记录到 5 次相同的 `StoreProhibited` 和软件复位。设备 ELF 摘要 `83ad0c849` 与本地 ELF 匹配；回溯为 `__strtok_r → strtok → iot_mc_check_topic → iot_mc_publish → 设备信息上报`。非法写地址为 `0x00060120`，指令显示写入的是解析保存指针，而不是 topic 缓冲。原始日志为 `artifacts/gimbal-reset-20261030.jsonl`。
- 在 HeadVoice 的构建副本内，将该 MQTT 检查函数的两处 `strtok` 改为使用函数内保存指针的 `strtok_r`；官方 vendor 及 baseline 接入保持原样。`tools/test_mqtt.py --upstream` 实测失败，显示旧校验破坏调用者解析状态；修复版本保留外层状态且 topic 规则测试通过。该主机测试不能复现 ESP newlib 内部指针损坏；实机重连复测仍是必要证据，尚不确定隐式状态最初为何失效。
- 修复固件 SHA-256 为 `4f0160ef94c4a365da984c0cb72702772783a2ab0c40a0616b386147ae5b389c`，应用大小 3054096 字节。只更新 0x20000 应用分区，哈希校验成功。90 秒被动复测出现 `cloud connected`，未记录到 panic 或再次启动；不将该窗口视为长期稳定或旧连续 stage 2 崩溃根因已修复。原始复测为 `artifacts/gimbal-mqtt-retest-20261030.jsonl`。
- 稳定运行时再次试动两轴，图像背景仍没有明确随动；1550µs 时两路均为 duty=1269、实测各有 3 次上升沿。俯仰轴按 1550→1500→1450→1400→1450→1500µs 往返，使用者明确确认舵盘没有转。尚未测量舵机插头端的实际电压和信号，也未验证机械连接或判定舵机损坏。
- 最终执行 `stop`：`active=false`，两轴 `armed=false`，采样高电平及上升沿均为 0；状态保留的目标脉宽为 pan=1550、tilt=1500µs。方向未设置，自动居中仍未通过。机器可读摘要为 `artifacts/gimbal-diagnosis-summary-20261030.json`，当前固件状态同步至 `artifacts/onboard-summary.json`。下一步核查舵机端实际接线、供电与信号路径。

### 接线复核后的实际波形测量

使用者提供接线照片，并明确表示已检查、接线无误。照片有线束遮挡，先前依据照片提出的“可能插错列”未被证实，不作为已确认根因。后续按接线已核对继续排查。

将 `hv_gimbal pwm` 扩展为约 95ms 的电平轮询采样，记录完整高脉冲与相邻上升沿周期。下列读数来自主控 GPIO 输入回读，不是舵机插头端的电压幅值或示波器测量；任务调度会产生采样空隙，因此不用于认证精密时序。

| 轴 | 目标脉宽 | 采样高脉冲范围 | 采样周期范围 |
| --- | --- | --- | --- |
| GPIO17 水平 | 1500µs | 1493～1500µs | 19997～20003µs |
| GPIO17 水平 | 1700µs | 1697～1700µs | 19995～20004µs |
| GPIO18 俯仰 | 1500µs | 1498～1502µs | 19991～20001µs |
| GPIO18 俯仰 | 1700µs | 1694～1702µs | 19996～20004µs |

分轴每次增加不超过 50µs，试到原有限位 1700µs。俯仰前后背景测得 0 像素位移；水平照片未见明确机械响应，背景匹配误差较高，不以其偏移估计认定运动成功。两轴最终均恢复 1500µs，执行 `stop` 后高电平及上升沿均为 0。尚未确定舵机不动的根因；等待舵机三线插头处红/棕线间的实际直流电压。

本轮应用 SHA-256 为 `a581cff4b3fa9c553a389cffcd701bb6f64287472bc862ef063a7a95baf650b3`，3054528 字节，编译及应用烧录哈希校验通过。CLI 日志文件名加入微秒，避免同一秒多条命令覆盖日志。波形及最终状态见 `artifacts/gimbal-waveform-summary-20261030.json`；前一版固件的 90 秒连云复测记录保留为历史。

### 舵机端电压及间歇动作反馈

使用者用万用表测得下面舵机红/棕线间约 4.65V，上面也接近此值，并报告开机时曾转动一下。随后单独对水平轴执行 1500→1700→1500µs 分步试动，使用者报告显示仍约 4.65V、又看到一次转动。记录为人工观察到间歇动作；未测得可重复的指令与角度对应关系，也不能由普通显示读数排除瞬间压降。

再次对俯仰轴执行 1500→1650µs 时，前后画面仍几乎相同。之后恢复中位并停机，单独开启水平轴 1500µs 信号约 30 秒，供使用者测橙色信号线对棕线的电压变化。此轮结束已确认两轴关闭、主控引脚均无脉冲；舵机插头端的信号电压读数待回复。

使用者随后回复该信号电压“基本 0”，未提供明确分开的开启/关闭数值。不能将直流档的近零读数单独作为断线证据。已要求断开主板 USB 和舵机电源后，测 P17→下部舵机橙线、主板 GND→该舵机棕线两组通断；结果待回复。等待期间不发送硬件命令。

使用者之后明确要求直接再次试动。19:03 依次单独对水平、俯仰轴执行 1500→1700→1300→1500µs 往返，每步 50µs；设备状态逐步确认，两轴最终关闭。使用者明确反馈“两只都没转”，因此不将命令执行成功视为机械成功。后续先缩小到主板 GND→下面舵机棕线一项通断测量，结果待回复。

使用者确认万用表支持通断档，按断电通断测量步骤反馈主板 GND→下部舵机棕线会蜂鸣，记为公共地导通通过。后续待测 P17→下部舵机橙色信号线；尚未因此确认信号端导通或舵机输入波形。

使用者进一步反馈 P17→下部舵机橙线测量也会蜂鸣，下部舵机的地线和信号线通断两项均记为通过。上部对应连接未单独完成电气通断测量。软件侧已观察到短窗口 GPIO 回读的预期周期/脉宽，尚未通过舵机端波形或最小单轴固件隔离试验排除其他任务、持续输出或运行时干扰；不将“配置与回读正常”视为软件完全无故障。

### 最小固件对照与俯仰机械传动问题

新增独立 ESP-IDF 诊断项目 `diagnostics/servo-minimal`，保留相同 GPIO17/18、LEDC 低速 timer0、channel0/1、50Hz 和 14 位配置，不启动摄像头、联网、云服务、语音或识别。上电输出关闭，单轴命令限制 1300–1700µs、每步最多 50µs，超过 2.5 秒没有新运动命令自动关闭输出。独立项目显式声明 GPIO 头文件依赖后编译通过；未修改 vendor。

原云台应用已备份至 `.local/servo-restore/gimbal-a581cff4.bin`，SHA-256 为 `a581cff4b3fa9c553a389cffcd701bb6f64287472bc862ef063a7a95baf650b3`。最小应用为 247232 字节，SHA-256 为 `da7127713f07a18573b8bb690975d16ba13d3c799701256bca0c7b899c3b25f3`。新旧分区表二进制哈希一致；只写入 0x20000 应用分区并通过烧录校验，未清除配网或模型。

19:34 起通过 `tools/servo_minimal_control.py --port COM3 --axis pan`、`--axis tilt` 依次执行 1500→1700→1300→1500µs。两轮命令回执匹配、运行时间持续递增、超时自动停机和最终显式停止均通过。使用者确认水平轴转动，俯仰轴起初不确定；19:36 应用户要求单独重测俯仰轴，相同命令和停止检查再次通过。使用者随后明确确认“白色舵盘在转，摄像头支架没动”。这支持上轴舵盘至相机支架的机械传动连接存在问题，具体固定点故障仍需实物检查；不能据此认定内部齿轮损坏。

最小测试已经观察到两轴输出端的动作，但仍未验证完整云台固件下可重复运动，不能直接认定或排除软件模块干扰。当前保留最小诊断固件，最后状态为两轴关闭；已请使用者断开主板 USB 和舵机电源后检查上轴固定连接，在其完成检查并恢复供电前不再发送运动命令。机械连接修复、恢复完整固件、方向校准和自动居中均待完成。汇总及原始日志索引见 `artifacts/servo-minimal-summary-20261030.json`。

等待实物检查期间，对完整固件的实际链接 map 和初始化路径作静态复核：LEDC 配置接口的应用侧引用来自云台与相机 XCLK 模块；当前相机 XCLK 引脚为 -1、频率为 0，初始化条件不成立，即使开启其预留配置也使用 timer3/channel7。官方 `bsp_servo_init` 调用被注释，map 未检出 `qm_pwm_init/start` 符号引用；板级复位按键使用 GPIO14。未发现这些路径与舵机 timer0/channel0/1 的直接资源冲突。该静态检查不能排除运行时损坏或电源负载差异，不据此宣称软件已完全排除。

使用者随后要求重新测试舵机。尝试打开 COM3 时报设备不存在，重新枚举只剩 COM1，未发送运动指令；已请使用者接回主板 USB、开启舵机电源后再继续。

使用者确认接好后，19:42、19:43 分别复测俯仰和水平轴，两轮完整序列、超时停机和显式停止均通过。使用者反馈俯仰轴似有声音，但没有带动支架。没有将该反馈写成支架已经修好，也没有继续扩大脉宽范围。

随后恢复备份的完整云台固件 `a581cff4…650b3`，只烧录应用分区并通过哈希校验。19:46～19:47 仅对水平轴执行同样的 1500→1700→1300→1500µs 序列，俯仰保持关闭。使用者明确确认“能带着摄像头左右往返”；三个目标位置的摄像头快照均完成帧校验，画面场景随位置改变，不用于标定角度。该结果未复现完整固件阻止水平轴运动，不能把最小固件能转直接归因于移除软件模块。水平轴此前不动的具体原因仍未确定。

对照脚本退出码 0，最后两轴目标 1500µs、armed=false、active=false；GPIO17/18 采样高电平与上升沿均为 0。当前板上为完整云台固件，预览已恢复，语音回答尚未重新验收。剩余工作为俯仰舵盘与支架连接的实物检查/修复、俯仰完整固件复测、方向校准及自动居中。原始对照日志为 `artifacts/full-pan-comparison-20261030.log`，汇总更新于 `artifacts/servo-minimal-summary-20261030.json`。

### 侧面装配照片与无运动复查

使用者补充侧面照片后，可见白色舵盘中心螺丝在位、长臂位于黑色凹槽中，不能仅凭长臂孔位空着认定缺少螺丝。使用者反馈长臂有一些翘出；这支持贴合/固定需要检查，但不足以确认它就是唯一根因。此前直接断言连接已损坏的措辞过强，具体故障点仍未确认。

使用者暂时没有螺丝刀，要求先排除其他原因。USB 起初未连接，确认重新连接后，于 20:05:06～20:05:51 被动采集约 45 秒，110 行日志未检出 panic、重启标志、brownout 或 watchdog；摄像头报告从 good=540 增至 good=1530，empty 保持 0，日志设备时间从 26860ms 增至 71780ms。采集前状态为两轴关闭、自动控制关闭，全程未发送运动命令。此窗口仅证明无运动条件下未复现连续重启，不能排除舵机负载下供电瞬降、插头端波形异常、机械阻力或输出轴/舵盘打滑。日志为 `artifacts/gimbal-passive-other-causes-20261030.jsonl`。

## 2026-10-31 RGB 面板、姿态回正修复与六轴评估

本轮代码位于 macOS 的 `gesture-bridge`，官方 SDK 仍为干净的 `89020f5e04bf777ae1672b8f3d320bc6e0ef3e0c`。`HEADVOICE_SDK` 支持复用已下载 SDK，ESP-IDF 工具安装在项目 `.tools`。本机 `.local/cloud.json` 已配置奶龙 PID 11785；产品密钥不进入 Git、公开接入补丁或 H5 ZIP。

灵机平台已在功能版本 2 创建 `headvoicePanel`，SIID 12，Command/PIID 1 为只写 String(96)，Report/PIID 2 为只读 String(640)，均不支持语控。提交后服务状态为“审核通过”。H5 版本 1 于 10:39 上传，随后点击发布并观察到“发布成功”及列表状态“发布”。这些状态不证明手机已加载或设备已收到指令。平台配网图/说明尚未填写，没有编造未实现的长按配网操作。

实际实现：RGB 三模式、限亮、设备端 5 秒自测与自动恢复；有界命令队列、请求编号、匹配设备回执、超时及断连禁用；USB 串口和官方 H5 SDK 适配；姿态遥测及过期状态。旧快照不能覆盖确认回执，姿态显示保守加入查询往返耗时。所有 UI 操作均有对应代码，IMU/云台/重置/播报未作为面板控制开放。

修复 `hv_core.c`：完成侧倾保持后经过动作阈值与回落阈值之间的 9–14° 区间不再清空已完成保持。到达 ≤9° 后才进入回正阶段；反方向、未完成保持、超时、失效观察仍按原规则取消。双方向渐进回正及上述拒绝路径的生产 C 回归通过，尚无真人复测。

摄像头沿用眼线二维有符号角度及 400 ms 帧龄/间隔限制，新增转换耗时、模型耗时、眼间距日志与 `tools/pose_readiness.py`。未重跑 10/26 的 27 个真实观察；历史中位推理 2676 ms、帧龄 2721 ms、有效输入 0 的结果仍不支持动作输入可用。当前新增诊断用于下一轮定位，未宣称性能已优化至门限内。

本轮实际验证：

- 生产动作核心回归、RGB 解析/限亮/模式/设备计时回归、MQTT 重入回归通过；11 项 Python 测试及四句音频身份检查通过。
- H5 协议 6 项测试、Vite 8.3.5 构建通过。390 px 手机布局无横向溢出，1280 px 桌面布局检查通过；颜色选择、熄灯禁用颜色控件、无设备禁用执行、普通浏览器云端入口提示均检查，浏览器没有捕获到 error/warn。
- PID 11785 的 baseline、HeadVoice stage 2（顺时针 90°）、stage 3（顺时针 90°）完整交叉编译通过，应用大小依次为 3203088、3076512、3347456 字节。哈希与平台状态见 `artifacts/panel-firmware-summary-20261031.json`；后续 stage 2 烧录与负结果见下。
- ZIP 仅含 app.json、index.html 和静态资源；检查生成补丁与 ZIP 未包含本机产品密钥。

用户开始时说明未接硬件；随后发现 USB `/dev/cu.usbmodem5CE41521721` 和另一次联调新增的 `artifacts/mac-connection-20261031.json`。该记录不是本轮面板测试产生，不能混为 RGB/姿态验收。用户随后明确授权切换 stage 2；已完整备份原应用至 `.local/panel-restore/gimbal-app-before.bin` 并核对分区表一致。后续烧录未擦除 NVS，也未发云台运动命令。

六轴资料对应 MPU6050。已核对产品规格中的三轴加速度/三轴陀螺仪及 SDK 默认 I2C 引脚；SDA8 与 BF3901 D0=GPIO8 冲突。优先建议测试支架移动门控；佩戴在头部才可能直接作为头部倾斜输入。尚未实现采样、门控或融合，详情见 `docs/imu-options.md`。

### 实机面板接入与反复重启（后续）

stage 2 首次完整烧录校验通过，但联网后捕获 `InstrFetchProhibited`、`Coprocessor exception`，调用路径集中在系统 tick / ROM WDT HAL，不能把烧录成功视作稳定运行。随后把 Flash/八线 PSRAM 从 120 MHz 改为 80 MHz，开启 PSRAM 启动自检与轻量堆检查；只更新引导与应用，保留 NVS 和已校验模型。自检通过，但 180 秒内仍捕获 4 次 panic、5 个启动标识，降频未解决问题，根因未确定。证据：`artifacts/panel-reboot-20261031.json`、`artifacts/panel-stability-20261031.json`。

手机用户明确确认新版控制台可见且显示“设备已响应”。串口同时记录了来自云端 SIID 12 / PIID 1 的不同编号 `get` 与匹配 HP 回执，证明 H5 查询往返已接通。随后设备再次崩溃，颜色设置、试灯及长时间在线未验收，不能称面板全部可用。

80 MHz 诊断窗口含 27 个姿态观察，推理中位数 5393 ms，其中转换 61 ms、模型 5326 ms；5 个追踪观察的新鲜结果为 0。窗口跨越重启，不能用于连续间隔或准确率验收；模型耗时已足以超过 400 ms 输入门限。下一步以关闭推理的 stage 1 对照定位，同时验证 RGB 面板。用户开始接灯圈，已要求断电接 GPIO1/DIN、5V、GND；在用户确认接线完成前暂停设备操作。

代码复核发现第二个面板的 `get` 可能使只记“上一条编号”的试灯去重失效，改为保留最近 8 条写操作编号，查询不挤掉写操作记录。交错查询后重试、熄灯后旧试灯重试均有生产 RGB 核心回归覆盖；新固件实机复测待进行。

用户确认 USB 是主动拔掉，并要求先继续其他开发。stage 1 应用烧录中断、未通过校验，下次实机测试须先重新写入完整应用；不把 USB 消失归因于灯圈接线或此前 panic。当前不再访问设备。

### 灯圈接入与 Chrome USB 面板实测（后续）

上述中断后，已重新写入完整 stage 1 应用并通过哈希校验（`.local/panel-stage1-flash.log`）；不再处于待恢复固件状态。用户先纠正此前灯圈未接，随后明确接好灯圈与 USB。两次 `tools/test_panel_device.py` 实测均通过：设置/查询回执、试灯、交错查询后的重复指令不重启计时、5 秒到期恢复、熄灯及恢复初始设置；记录为 `artifacts/panel-wired-device-test-20261031.json` 和 `artifacts/panel-wired-retest-20261031.json`。重试记录的 stage 为 1，不运行姿态推理。

真实 Chrome 页面 `http://127.0.0.1:4173/` 连接 USB 后完成湖蓝 20%、薄荷 30%、试灯 5 秒及刷新、熄灯；用户明确确认蓝色常亮、红绿蓝白灭顺序正常，以及试灯后恢复薄荷绿、最终熄灭。断开后控制按钮禁用；刷新新版页面并重新选择相同开发板后，收到设备熄灯/30% 回执。此项验证了桌面页面至实物灯圈的链路，不替代手机云端写操作验收。

页面预览原先固定显示“待应用”，已依据新鲜匹配回执修正为“已同步”，未收到匹配回执或断开时不显示同步；现有 20 项前端测试和生产构建通过，并在实际重连画面核对。截图及完整范围见 `artifacts/panel-wired-validation-20261031.json`。该本地页面修复未重新发布到灵机 H5。此次未烧录、未发云台运动指令；结束时保持 USB 面板连接、灯光熄灭。stage 2 崩溃、实时姿态性能和长期稳定性仍未解决。

### 摄像头画面接入面板（后续）

用户要求将摄像头画面输出到控制面板。复用已在 stage 1 固件中的 `hv_camera snapshot`，新增浏览器流式解析、RGB565LE 解码、装配方向旋转和 Canvas 显示。单帧读取、自动刷新/停止、进度、最近接收时间和断连清图均有实现。只有 WAIT 确认接收请求且 END 长度/校验通过才发布完整帧，允许固件 WAIT 晚于 BEGIN；失败后该连接禁止继续取帧，须重连。取帧期间暂停面板灯光写操作与轮询，原输出保持，完成后补查状态。

真实 Chrome USB 首帧显示 160×120，获取用时 7.4 秒；自动刷新随后至少更新两帧，界面记录约 7.5 秒。点击停止后，后续观察显示距上次接收 346 秒，未重置为新帧；随后断开，Canvas 清空、取帧和灯控按钮禁用。实际图像可辨认室内场景，未测色彩准确度或姿态识别。含拍摄内容的截图仅保存在 `.local/panel-camera-20261031.png`，不进入公开 artifacts。

先行 Python CLI 一次捕获 USB 读取中断，端口随后恢复；另一次在 BEGIN 后报奇数位 HEX。检查发现旧脚本把带 0.5 秒超时的 `readline` 片段当成完整行，因此已改为按真实换行累积并限制缓冲。8 项 Python 摄像头测试通过，修复版 Python 工具本轮未实机重跑；不能据旧脚本错误直接认定硬件传输损坏。浏览器按换行缓冲的路径已完成上述多帧显示。

前端 39 项测试及生产构建通过，覆盖分片、校验失败、旋转、WAIT 顺序、读写互斥、迟到帧、后台计时器延迟、断线和重启取消，以及页面自动刷新生命周期。未改固件、未触发云台动作、未上传图像、未重新发布云端 H5。手机云端暂无已实现的视频入口；该本地低帧率预览不表示实时姿态性能或 stage 2 稳定性通过。汇总见 `artifacts/panel-camera-validation-20261031.json`。

### P17 舵机小幅实测与人工观察（后续）

用户要求实测舵机，主要关注俯仰，并确认三线接到 P17、5V、GND。独立电源及该舵机在支架上的具体物理轴未单独确认，因此按实际信号接线测试 P17；最小诊断固件中的逻辑轴名为 `pan`、回执 `axis=0`，不据此认定本次测试的是物理水平轴或已确认俯仰轴接线。

`tools/servo_minimal_control.py` 默认改为 ±25µs、每步约 0.8 秒；只有显式选择 `--span-us 200` 才使用原 1300–1700µs 全范围。启动期间只重试只读 `status`，取得确认后才允许运动；按真实换行缓冲回执，之后遇到重启、超时或脉宽/轴不匹配即中止，并在退出时尝试 `stop` 与 `status` 验证。5 项主机回归通过，覆盖小幅范围、未就绪禁止运动、错回执必停、启动重启/首包丢失及运动期间重启。

切换到独立最小诊断固件后，三轮均对 P17 执行 1500→1525→1500→1475→1500µs。各步回执的逻辑轴与目标脉宽匹配，2.5 秒设备端 lease 到期及最终 `stopped`、`status` 检查均通过；停止回执均为 `axis=-1、pulse_us=0`。第一轮日志为 `artifacts/servo-minimal-20261031-140330-323963.jsonl`。后两轮在提前 10 秒提醒用户观察后执行，日志为 `artifacts/servo-p17-observed-repeat-20261031-140428-351549.jsonl`；按设备运行时间计算，从最后一条 1500µs 设置到 `lease_expired` 分别为 2516 ms、2512 ms。

第一轮用户表示“没看到”，未形成有效动作观察；后两轮选择“完全没动或有异响”，未进一步区分完全静止还是伴随异响。因此本次只确认命令回执与停止逻辑，实物动作验收未通过；没有新增舵机端电压、波形或机械位移测量，不能确定供电、机械连接或软件中的哪一项是根因，也不能沿用 10/30 的动作观察认定本轮成功。

用户随后要求提供启动指令。进行中的 stage 1 恢复写入已完成并通过哈希校验；随后按最新请求重新写入最小诊断固件并通过哈希校验，留给用户手动触发。最终板上为最小诊断固件，当前面板、摄像头、联网服务不可用，原 stage 1 恢复镜像仍保留。明确的 `--status-only` 分支只发送 `status`，实机回执确认 `axis=-1、pulse_us=0`，未再次发送运动指令。日志为 `artifacts/servo-minimal-20261031-140825-288873.jsonl`，汇总为 `artifacts/servo-p17-validation-20261031.json`。新增只读参数和两项回归后，共 7 项主机测试通过。此前无参数检查被自动审批拦截，未执行；改为明确的只读分支后检查通过。

### P18 俯仰手动测试获用户确认（后续）

用户随后要求改成 P18，已提供 `--axis tilt --span-us 25` 命令。用户明确反馈“俯仰的也可以转动了，但似乎角度有点小”，记为本轮 P18 俯仰小幅运动的人工确认；这不覆盖之前 P17 的负结果，也不证明完整固件下能运动、支架传动已单独验收或角度已标定。下一步给出 `--span-us 100` 的手动命令，范围 1400–1600µs，每步仍不超过 50µs；保留默认 25µs 与 2.5 秒 lease。100µs 是脉宽偏移，不是 100°；扩大范围尚未实测。本次未由代理发送运动命令或再次烧录。用户确认摘要见 `artifacts/servo-p18-user-confirmation-20261031.json`。

随后只读核对了用户手动运行的最新两份日志 `artifacts/servo-minimal-20261031-142705-531570.jsonl`、`artifacts/servo-minimal-20261031-142716-136356.jsonl`：均为 axis=1、±25µs 完整序列，自动停止延迟 2514/2517 ms，最终输出关闭。该串口证据与用户动作确认相互补充，未包含 ±100µs 结果。

### 恢复 stage 1 并复测完整取帧（后续）

用户恢复总目标并要求继续测试摄像头。此前最小舵机诊断留板状态已结束，先恢复旧 stage 1 应用，SHA-256 为 `aa1769ed6f5ef8995ce157d6b15667805fcd81fb382f6ff1414b51d598382053`，应用写入及哈希校验通过。两次只读 HP 查询回执的 boot 一致；两次真实快照均通过整帧校验并已查看，证明恢复后的控制查询和相机取帧路径可用。

随后采集 60 秒被动日志，实际记录区间为 2026-10-31 06:52:16.408～06:53:15.861 UTC。该窗口含 1 个启动标记，未检出 panic/watchdog 标记；57 条相机记录的 good 从 30 增至 1710，empty 始终为 0，`last_bytes=153600`，计数单调增加。stage 1 的 inferred 始终为 0，不能把该窗口记作识别性能或长期稳定性通过。汇总为 `artifacts/camera-stage1-retest-20261031.json`；原始日志与两张含拍摄内容的图像仅保存在 `.local/camera-retest-20261031/`，不公开。

### face stage 2 CW90 上板与网页预览（后续）

独立 `.work/face-candidate` 使用当前源码重建 face stage 2，启用 CW90、关闭云台，保留空帧 100 ms 退避、相机日志 1 秒节流、Wi-Fi 断线去重连接及 `reset_reason` 回执。固定应用为 `artifacts/headvoice-face-stage2-cw90-20261031.bin`，SHA-256 为 `223a9e1993713006f540d05aedf1303239286b5786df67c1b27211f8376c8419`，3,259,216 bytes。镜像完整性检查通过，分区表与 stage 1 及原板备份一致；ELF 未包含 COCO 初始化/推理符号。构建清单和同名 ELF/MAP 已保留，官方 vendor 未修改。

已仅写入 `0x20000` 应用区并通过烧录校验，未改 bootloader、分区、NVS 或模型区。真实 Chrome USB 查询显示 stage 2；160×120 快照通过校验并显示，页面记录获取用时 8.9 秒。原始截图只在 `.local`，公开记录仅保留验证元数据。面板曾出现 107 ms、136 ms 推理耗时，这些只是初步读数，不作为正式性能分布、时序门限或稳定性结论。上板与预览证据见 `artifacts/face-stage2-runtime-20261031.json`，模型与构建范围见 `docs/face-backend.md`。

采样工具同时完成诊断修复：`tools/capture_serial.py` 按真实换行累积串口片段，将结束时的未完成尾行标记为 `partial_line`，不把它解析为姿态；完整原始日志默认写入 `.local`，终端仅输出筛选后的诊断，`--quiet` 不影响原始日志保存。打开串口前明确关闭 DTR/RTS。

`tools/pose_readiness.py` 新增 `previous_capture_to_result_ms = capture_gap_ms + 当前 age_ms` 检查，对应 `hv_observe` 更新上一帧时间之前执行的 400 ms `hv_tick` 门限。启动/崩溃、boot 变化、时间倒退和显式失效分别划段，不跨段计算间隔或合并短窗口；被拒绝/未追踪观察、非法时间戳及未换行尾行不能制造通过。10 项主机测试通过，包括恰好 400 ms 与 401 ms、两项独立门限通过但合计 450 ms、重启分段以及尾行不足 30 秒/30 样本等情形。这只校验日志判定逻辑，不等于实机时序已通过。

当前已请用户用网页调整取景，等待其回复后再开始正式单脸、遮挡、侧倾采样。此前画面先无脸，调整后人脸靠近下边缘且下巴被裁切，取景尚未确认合适。正式测时应暂停图像预览，避免约秒级图像串口传输和额外拷贝干扰，再连续采集至少 30 秒、30 个 tracked 结果，单独检查无脸/多脸拒绝与真实动作。当前不能宣称姿态已可用、stage 2 稳定或 stage 3 动作链已验收。

## 2026-10-31 语音唤醒、热点恢复与控制任务栈溢出

用户在手部检测固件运行时报告无法唤醒。官方《灵机XJWB03标准开发板使用文档》第 8 页 §8.2 的默认词为“你好，小灵”，但本轮设备实际在 17:28:35（北京时间）上报 `wakeup: 你好小鹰`，随后 `qm_agent_start ret=0 state=starting`。当前板使用“你好，小鹰”；不能用手册默认词否定该实机事件，也不推断所有批次都用同一个词。

最初 180 秒窗口的麦克风流量中位数约 31999 B/s，摄像头 good 从 11 增长到 2829、empty 最大值为 0；没有唤醒事件或 RTC 上行。网络重连中 8 次 `reason=1` 对应 `QM_WIFI_REASON_NO_AP_FOUND`，另有一次 reason=6。用户确认原手机热点未开启，随后开启；后续收到 MQTT `receive ping response!`，恢复了云端通信。本地唤醒未观察到与联网失败分开记录，不把全部现象归因于网络。

用户随后确认有唤醒提示音但无回答。唤醒事件之后约 0.615 秒，日志明确报告 `A stack overflow in task qm_agent_ctl has been detected`，随后重启；HP 报告 `reset_reason=4`。当时开启了 `hv_voice debug` 生命周期诊断，崩溃发生在 Agora SDK 初始化日志之后。默认控制任务栈为 3072 字节；此证据证明该诊断窗口的控制任务栈溢出，不证明其他历史崩溃同因。旧应用内嵌 ELF 摘要为 `2b8b5398c...`；当前本地旧工作目录 ELF 已不同，未将其地址解析当成精确源码定位。

修复通过 `tools/prepare_sdk.py` 仅在应用副本定义 `CONFIG_QM_AGENT_CONTROL_TASK_STACK_SIZE (8 * 1024)`，同时为 `hv_voice stats` 添加控制任务存在性、最小剩余栈字节数及内部堆余量。SDK 原件未改。手部应用 2 项主机测试、摄像头预览固件 1 项主机测试及完整隔离固件构建通过；这些检查不能代替实机语音与摄像头并发验收。候选基于当前手部应用源码，后者与上次上板清单的哈希不同，已在新清单保留全部相关源码哈希。

修复镜像：[headvoice-hand-voice-stack-20261031.json](../artifacts/headvoice-hand-voice-stack-20261031.json)；脱敏诊断汇总：[voice-wake-diagnosis-20261031.json](../artifacts/voice-wake-diagnosis-20261031.json)。首次 460800 波特率读取分区时发生串口包错误，尚未写入；降低到 115200 后只读分区匹配，随后仅更新 0x20000 应用区。配网、绑定、分区表与模型区不重写，旧应用回退镜像保留。

### 语音修复实机验收

首次 115200 写入在约 58% 处失去连接，自动重传又在约 16% 处停止。用户随后表示可能是另一个测试窗口干扰，并关闭了该窗口；继续使用原扩展坞和 115200 完整写入 3,593,632 字节，176.7 秒完成并收到 `Hash of data verified.`。此前应用不完整的状态已解除；未证明扩展坞或并发访问是唯一原因。配网、绑定和其他分区未写入。

但新应用启动验收失败：45 秒无人工唤醒的观察窗口出现 2 次 `LoadProhibited` 和 1 次 `StoreProhibited`，收到过 `cloud connected`，相机有 35 条批次记录、手检测相关记录 121 条；这些不能构成稳定运行通过。日志 ELF 前缀 `4afe60346` 与归档 ELF 哈希 `4afe60346bb483c94e67c651fc959bcbbaf275d43e34dc9c34b64c5d2055c4de` 匹配。匹配 ELF 回溯经过 `esp_vApplicationTickHook` / SysTick 和 ROM watchdog 函数，一次被中断任务在 Opus 编码；这不是此前明确报告的 `qm_agent_ctl` 栈溢出，尚未定位根因。

本轮没有在新应用上验证唤醒后对话，也没有得到可完整解析的栈余量样本；不能声称 8 KB 修复已通过实机。当前板上留存完整且哈希校验通过的语音栈修复应用，仍会崩溃，暂不用于语音或手势采集验收。恢复写入日志为 `.local/hand-voice-stack-recovery-20261031.log`，启动证据为 `.local/voice-stack-postflash-20261031.jsonl`。

### 后续实机听测通过，启动稳定性仍未通过

用户重新插拔 USB 并开启热点后，约 248 秒观察捕获到 7 次 `wakeup: 你好小鹰`，全部因 `cloud=0` 被程序忽略；同期有 MQTT 写入超时和 4 次崩溃。因此“没有提示音”不能等同于语音芯片没有识别唤醒词。脱敏证据见 [voice-coldboot-20261031.json](../artifacts/voice-coldboot-20261031.json)。

继续排障时在两核为 tick 回调数组和 WDT HAL 上下文设置临时写监视点，没有捕获到相应写入异常；这不能排除其他内存或硬件问题。首次诊断使用 `printf` 在 IPC 任务中触发断言，改为 ROM 日志后才继续观察，该断言不作为原故障证据。随后保留看门狗保护，将 WDT HAL 从 ROM 实现切换为 ESP-IDF 实现做对照，仍出现 2 次 `IllegalInstruction`，故不能把该切换称为修复。

在镜像 `b4175a0c09ce6f27517a05cb1f5afffbe724185cd5b7a701b9b9b4dee85faa6f` 中，18:26:43 收到“你好小鹰”并成功启动会话，18:26:45 Agora 连接成功。随后约 98.9 秒会话窗口无新崩溃、重启、断云或音频入队失败；同时有 97 条摄像头批次记录和 232 条手检测记录。记录到 7 次 ASR final、18 条 TTS 分片和一次播放开始；最后一次上行统计为 4381 包、175240 字节、错误 0，控制任务最小剩余栈为 5080 字节。

用户明确反馈“提示音和回答都有”，因此本次唤醒与实际回答、摄像头并行运行已经通过端点听测。最后一次启动连续观察约 128.3 秒无新崩溃；整个约 178.8 秒窗口早期仍有两次启动崩溃，长时间稳定性未通过，也没有记录到 TTS 完成事件，不能据日志宣称每条回复均完整播放。证据：[headvoice-hand-local-wdt-net-20261031.json](../artifacts/headvoice-hand-local-wdt-net-20261031.json)，原始日志仅保留在 `.local/voice-local-wdt-net-20261031.jsonl`。

`hv_voice stats` 原本合并输出超过 SDK `qm_cli_printf` 的 256 字节缓冲，现分为 `HVVOICE`、`HVVOICETX`、`HVVOICECTRL` 三行；最大整数边界下分别为 130、134、141 字节。采样先读生产者时间戳再读当前时钟，避免 CLI 被抢占时帧龄无符号下溢。新增 `hv_voice net` 只读报告 Wi-Fi 关联、RSSI 和 IP 获取状态；实测关联与 IP 均为 true，RSSI 约 -29 dBm。完整构建和实机解析通过，关联成功仍不能代替云端连接证据。

用户反馈到达前，纯语音隔离镜像的烧录已开始并完成校验；此镜像未做运行验收，不能作为语音独立稳定的证据。随后恢复用户已确认能对话的摄像头镜像；最终上板状态与恢复校验以 [onboard-summary.json](../artifacts/onboard-summary.json) 和 [headvoice-hand-voice-restored-20261031.json](../artifacts/headvoice-hand-voice-restored-20261031.json) 为准。

18:34:28 恢复摄像头并行镜像完成，SHA 与用户确认版本一致，应用写入哈希校验通过。用户要求开始摄像头测试后已结束串口监视，未继续烧录；恢复后的短窗统计见恢复镜像清单，不作为长时间稳定性证明。
