hecaojuanjuan/gesture-bridge/docs/hand-centering-test-2026-10-31.md

# 手势居中测试报告

**日期**: 2026-10-31  
**测试工具**: `tools/hand_center_simulator.py`  
**固件**: HeadVoice Stage 2 手势识别固件  
**端口**: COM3 @ 115200  

## 测试目标

测试当前手势识别固件的手部检测功能，模拟云台居中控制逻辑，验证：
1. 手部检测的准确性
2. 坐标归一化计算
3. 居中判断逻辑
4. 云台控制决策

## 测试结果

### ✅ 成功检测到手势并计算居中动作

在167次观察中：
- **有效手部检测**: 约30次
- **成功居中**: 2次（观察#138和#155）
- **居中坐标**: 
  - `(0.537, 0.496)` - 偏差(+0.037, -0.004)
  - `(0.530, 0.496)` - 偏差(+0.030, -0.004)

### 手势位置分布

1. **左侧偏离** (需要向左移动)
   - 位置: `(0.25-0.28, 0.57-0.61)`
   - 偏差: 约-0.22水平, +0.10垂直
   - 频率: 高（多次连续检测）

2. **右上方** (需要向右上移动)
   - 位置: `(0.60-0.70, 0.20-0.40)`
   - 偏差: +0.10~+0.20水平, -0.13~-0.30垂直
   - 频率: 中等

3. **已居中** ✓
   - 位置: `(0.530-0.537, 0.496)`
   - 偏差: 在±8%容差内
   - 频率: 偶尔（2次）

4. **下方偏离** (需要向下移动)
   - 位置: `(0.48-0.64, 0.74-0.85)`
   - 偏差: 垂直+0.24~+0.35
   - 频率: 较少

### 云台控制决策验证

算法正确判断了以下场景：

| 观察# | 手势位置 | 偏差 | 决策 | 结果 |
|---|---|---|---|---|
| 1 | (0.689, 0.394) | (+0.189, -0.106) | 水平轴→右 | ✓ 正确 |
| 2 | (0.327, 0.569) | (-0.173, +0.069) | 水平轴←左 | ✓ 正确 |
| 64-95 | (0.60, 0.20) | (+0.10, -0.30) | 俯仰轴↑上 | ✓ 正确 |
| 138 | (0.537, 0.496) | (+0.037, -0.004) | **已居中** | ✓ 正确 |
| 155 | (0.530, 0.496) | (+0.030, -0.004) | **已居中** | ✓ 正确 |
| 165-167 | (0.49, 0.83) | (-0.01, +0.33) | 俯仰轴↓下 | ✓ 正确 |

### 检测挑战

1. **间歇性检测**
   - 大量"无手"和"无效"观察
   - 手部检测不连续
   - 可能原因：手势快速移动、光照、遮挡

2. **多手干扰**
   - 偶尔检测到2只手
   - 系统正确拒绝多手场景

3. **边界框质量**
   - 有些帧box为[0,0,0,0]但hands=1
   - 系统正确识别并跳过

## 核心算法验证

### ✅ 坐标归一化
```python
center_x = (box[0] + box[2]) / 2.0 / width
center_y = (box[1] + box[3]) / 2.0 / height
```
- 输入: 像素坐标 (0-320, 0-240)
- 输出: 归一化坐标 (0.0-1.0)
- **验证通过**

### ✅ 偏差计算
```python
error_x = center_x - 0.5
error_y = center_y - 0.5
```
- 中心点: (0.5, 0.5)
- 容差: ±0.08 (8%)
- **验证通过**

### ✅ 轴选择逻辑
```python
if abs(error_x) >= abs(error_y):
    axis = 'pan'  # 水平轴
else:
    axis = 'tilt'  # 俯仰轴
```
- 优先移动偏差较大的轴
- **验证通过**

### ✅ 居中确认
- 需要连续3次观察在容差内
- 观察#138达到1次，但后续帧无效
- 观察#155达到1次，但后续帧无效
- **逻辑正确，但受限于检测连续性**

## 结论

### ✅ 算法验证成功

1. **坐标系统**: 归一化计算正确
2. **偏差判断**: 中心容差±8%工作正常
3. **控制决策**: 正确选择需要移动的轴和方向
4. **居中检测**: 能够识别手势已居中的状态

### ⚠️ 实际应用挑战

1. **检测稳定性**: 手部检测间歇性强，影响连续居中判断
2. **多手干扰**: 需要保持单手环境
3. **帧有效性**: 约18%的观察有有效手部数据

### 💡 建议

**立即可用（模拟模式）**:
- ✅ 当前模拟器已验证算法正确性
- ✅ 可用于演示和调试
- ✅ 实时显示手势位置和居中状态

**硬件集成（需要固件支持）**:
1. 烧录带云台控制的固件（`headvoice-face-autocenter-stage2-20261031.json`）
2. 修改固件以支持手部目标（当前仅支持人脸目标）
3. 添加手部检测到云台控制的桥接代码

**提升检测稳定性**:
1. 改善光照条件
2. 保持手部在画面中央附近
3. 减缓手势移动速度
4. 使用单手操作

## 测试文件

- 模拟器: `tools/hand_center_simulator.py`
- 单元测试: `tests/test_centering_integration.py`
- 核心算法: `headvoice/core/hv_gimbal_core.c`
- 手部检测: `experiments/remote-558195a/headvoice/core/hv_hand_detector.h`

## 下一步

1. **继续使用模拟器监控**: 观察更多手势数据，优化参数
2. **固件升级**: 如需硬件自动居中，需要烧录云台固件
3. **算法优化**: 考虑降低容差或调整连续确认次数以适应不稳定检测

---

**测试完成时间**: 2026-10-31  
**测试状态**: ✅ 算法验证通过，实际应用待固件支持
