hecaojuanjuan/gesture-bridge/experiments/remote-558195a/ARCHIVE.md

# 远端手掌／云台与旧面板实验归档

来源：[558195a](https://github.com/hecaojuanjuan/gesture-bridge/commit/558195a05623d493db712e596322cda85b82a381)，归档日期 2026-10-31。

这里按原相对路径保存远端两次提交相对共同基线的代码、脚本和文档，文件字节未改动，SHA-256 见 `archive-manifest.json`。海报、外壳、旧面板测试摘要和外壳生成器保留在仓库原位置；完整历史仍可从来源提交查看。

该路线使用肤色分块检测及扩展云台控制接口，旧面板使用 `PANEL` 串口协议。主目录当前使用 ESP-DL 手部检测、独立分类器适配及 `HP` 面板协议；两者不直接兼容。本次合并保留主目录的当前实现，将另一条路线原样归档，不宣称实验已通过编译或实机验收。

本目录不参与主构建。内部旧指南、部署脚本和 README 是历史原文，路径仍描述原仓库布局，不应直接对当前主目录运行。需要复现该实验时，从来源提交建立独立副本，并重新检查构建、接口和设备边界。
