hecaojuanjuan/gesture-bridge/artifacts/poster/gesture-bridge-poster-v9-80x180cm.pdf

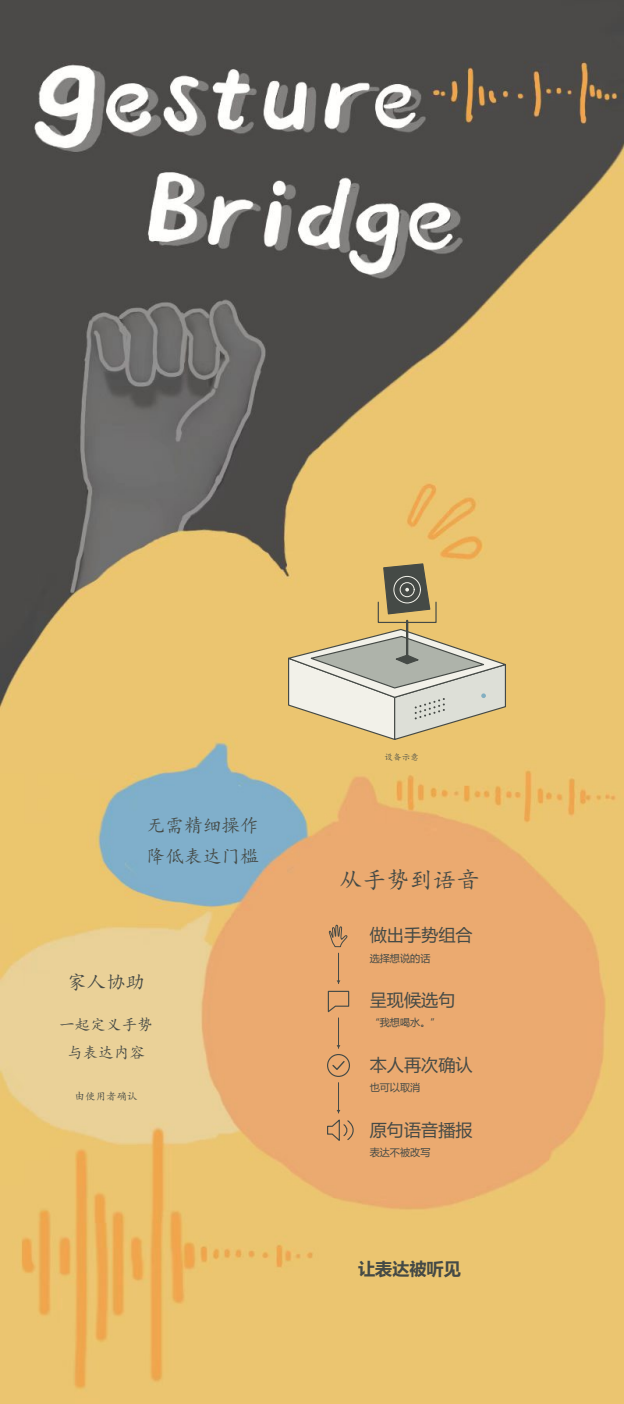
[picture p49: page 1]
设备示意; 从手势到语音; 做出手势组合; 选择想说的话; 呈现候选句; “我想喝水。”; 本人再次确认; 也可以取消; 原句语音播报; 表达不被改写; 无需精细操作; 降低表达门槛; 家人协助; 一起定义手势; 与表达内容; 由使用者确认; 让表达被听见
