hecaojuanjuan/gesture-bridge/artifacts/poster/gesture-bridge-poster-v4-80x180cm.pdf

# gesture

# bridge

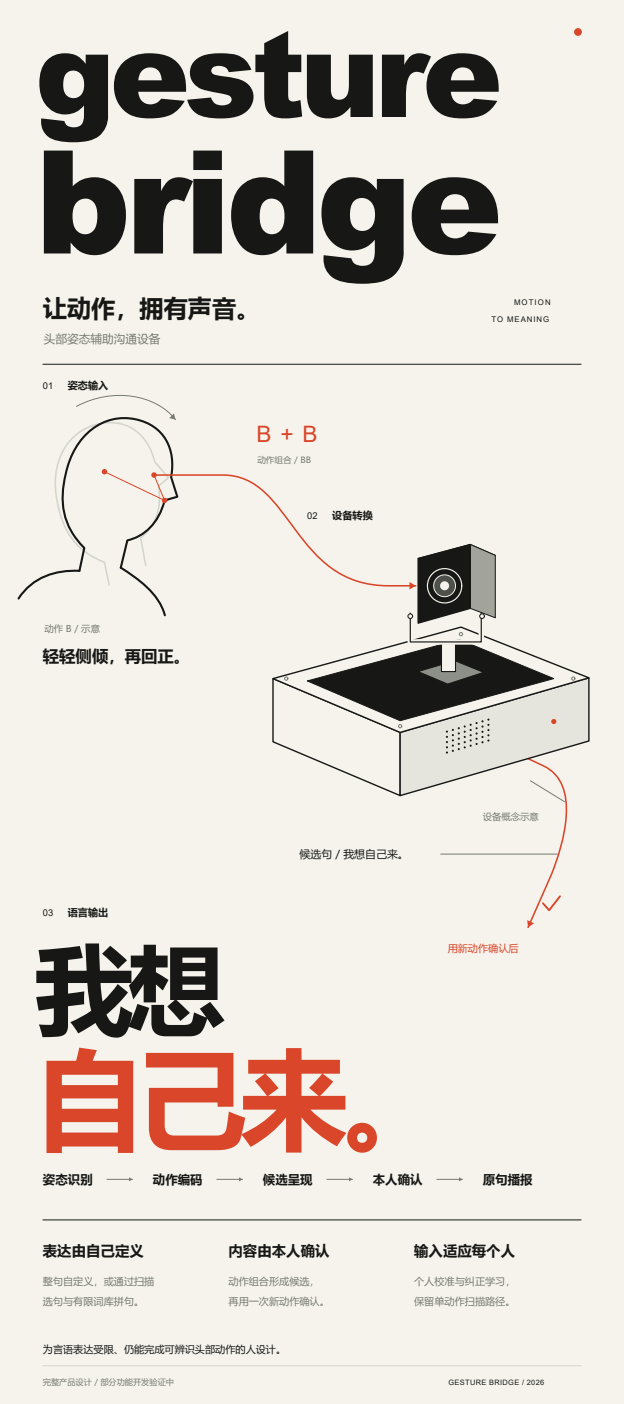
[picture p50: page 1]
让动作，拥有声音。; 头部姿态辅助沟通设备; MOTION; TO MEANING; 姿态输入; 设备转换; 动作 B / 示意 轻轻侧倾，再回正。; 动作组合 / BB; 设备概念示意; 候选句 / 我想自己来。; 用新动作确认后; 语言输出; 我想 自己来。; 姿态识别; 动作编码; 候选呈现; 本人确认; 原句播报; 表达由自己定义; 整句自定义，或通过扫描; 选句与有限词库拼句。; 内容由本人确认; 动作组合形成候选，; 再用一次新动作确认。; 输入适应每个人; 个人校准与纠正学习，; 保留单动作扫描路径。; 为言语表达受限、仍能完成可辨识头部动作的人设计。; 完整产品设计 / 部分功能开发验证中; GESTURE BRIDGE / 2026
