hecaojuanjuan/gesture-bridge/artifacts/poster/gesture-bridge-poster-v5-80x180cm.pdf

# Gesture

# Bridge

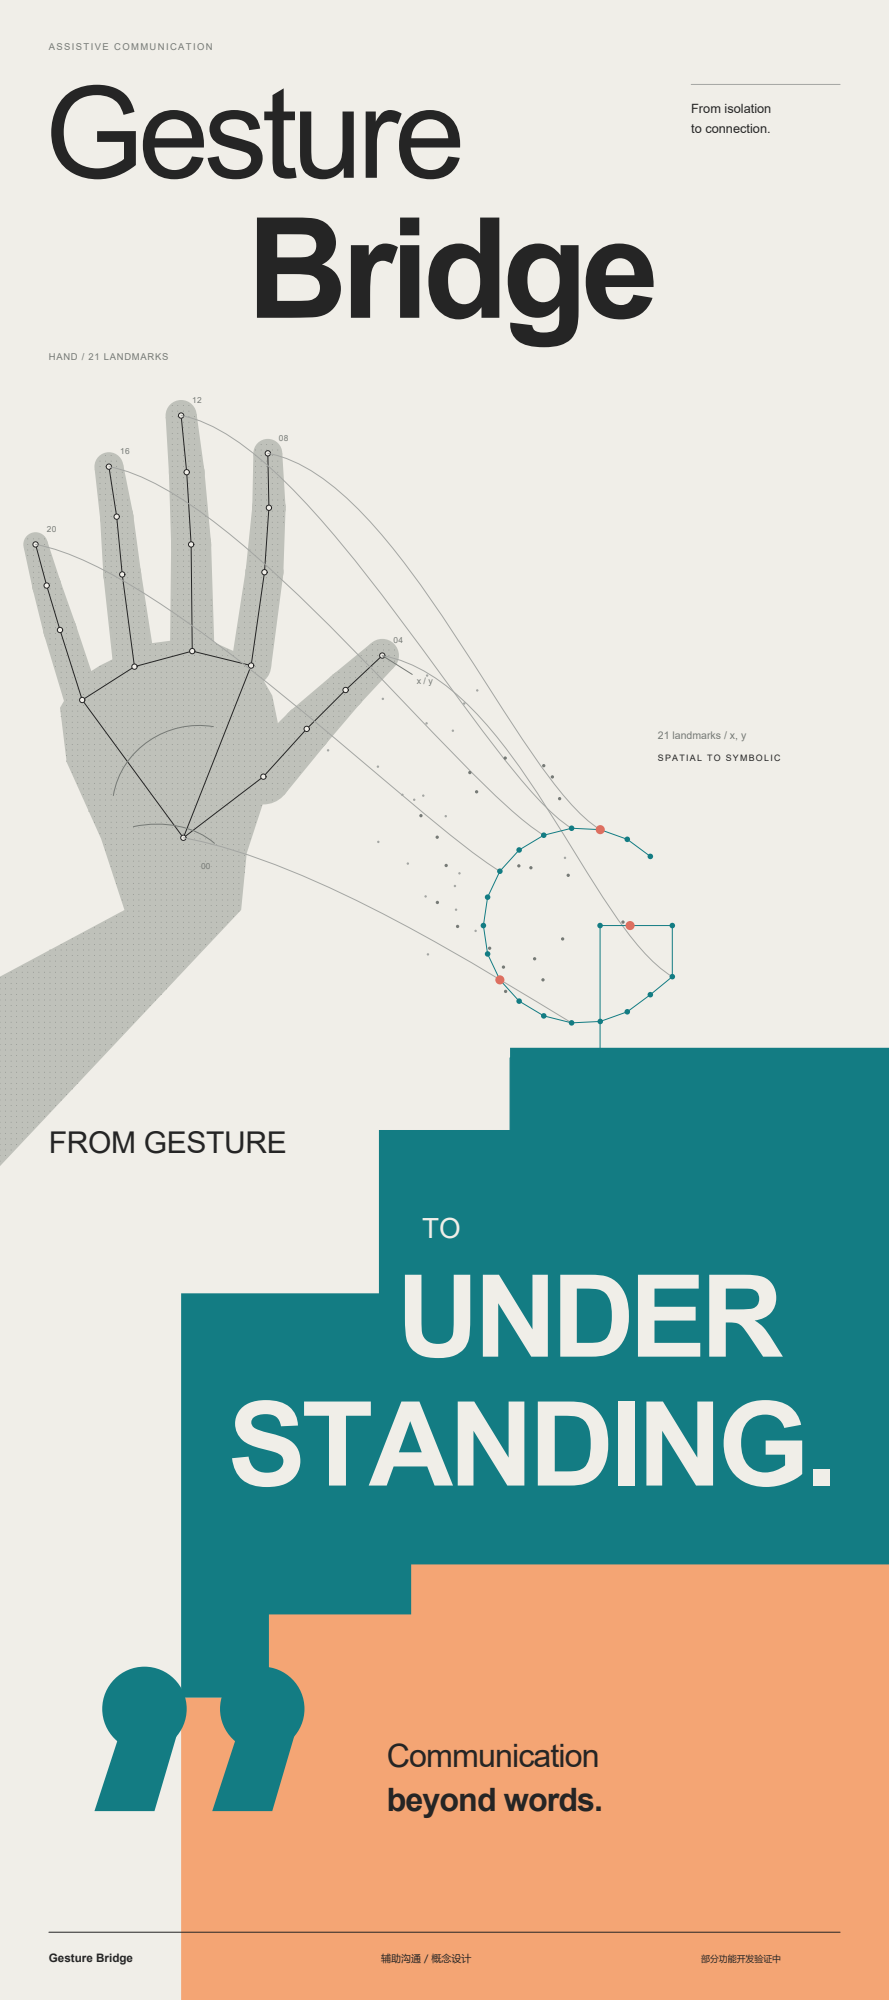
[picture p51: page 1]
ASSISTIVE COMMUNICATION; From isolation; to connection.; HAND / 21 LANDMARKS; 21 landmarks / x, y; FROM GESTURE; TO UNDER STANDING.; Communication beyond words.; Gesture Bridge; 辅助沟通 / 概念设计; 部分功能开发验证中

SPATIAL TO SYMBOLIC
