hecaojuanjuan/gesture-bridge/artifacts/poster/gesture-bridge-poster-v6-80x180cm.pdf

# Gesture

# Bridge

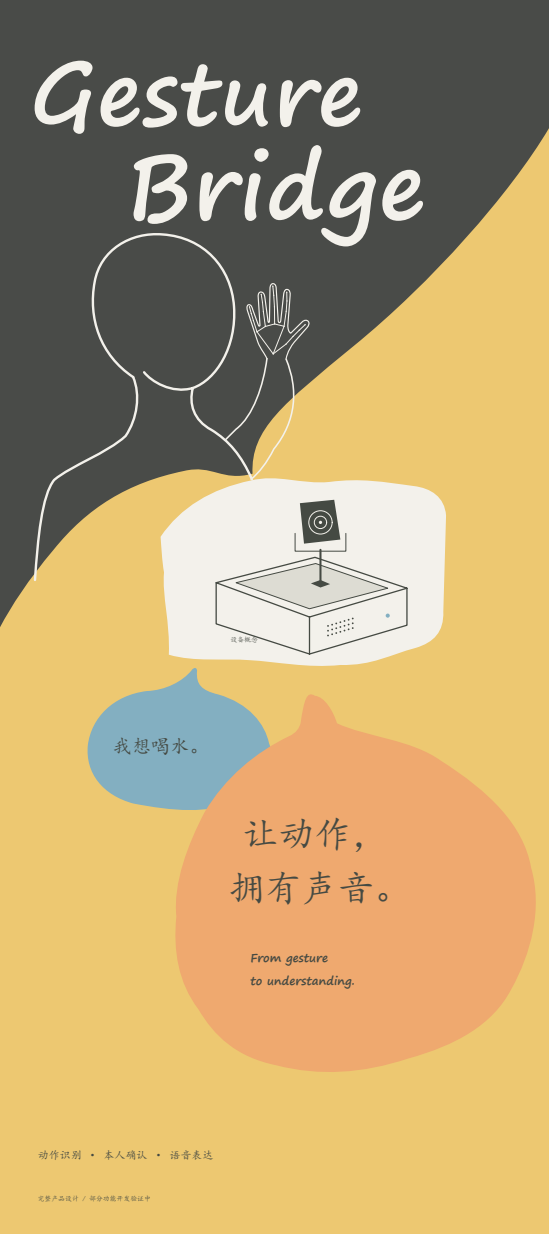
[picture p52: page 1]
设备概念; 我想喝水。; 让动作， 拥有声音。; From gesture; to understanding.; 完整产品设计 / 部分功能开发验证中

动作识别 · 本人确认 · 语音表达
