hecaojuanjuan/gesture-bridge/headvoice/firmware/hv_settings.h

#ifndef HV_SETTINGS_H
#define HV_SETTINGS_H
/* Tune these only from captured live observations. Stage 1 captures, stage 2
 * measures pose alongside official voice, stage 3 enables expression. */
#ifndef HV_STAGE
#define HV_STAGE 3
#endif
#ifndef HV_ROTATE_CW90
#define HV_ROTATE_CW90 0
#endif
#ifndef HV_INVERT_TILT
#define HV_INVERT_TILT 0
#endif
#endif
