hecaojuanjuan/gesture-bridge/tools/face_gimbal_session.py

"""Safely calibrate face-stage-2 gimbal over one persistent serial connection."""
import argparse
from collections import deque
import datetime
import json
import math
from pathlib import Path
import re
import shlex
import time

from camera_preview import SerialLines


RESTART = re.compile(r"ESP-ROM:|(?:^|\s)rst:0x|Guru Meditation|Brownout|Restarting\.\.\.")
LIMITS = [1475, 1525]
TARGET_READ_RETRIES = 2


class DeviceRestarted(RuntimeError):
    pass


class CorruptReceipt(RuntimeError):
    pass


class TargetReceiptInterrupted(RuntimeError):
    pass


class FaceGimbalSession:
    def __init__(self, device, log, clock=time.monotonic):
        self.device, self.log, self.clock = device, log, clock
        self.framing = SerialLines(max_line_bytes=65536, encoding="utf-8")
        self.lines = deque()
        self.restarted = False
        self.restart_count = 0
        self.motion_sent = False
        self.status = None
        self.ready_seen = False

    def _read_line(self, deadline, startup=False):
        while self.clock() < deadline:
            if not self.lines:
                self.lines.extend(self.framing.feed(self.device.read(4096)))
                continue
            line = self.lines.popleft()
            self.log.write(json.dumps({
                "host_utc": datetime.datetime.now(datetime.timezone.utc).isoformat(),
                "line": line}, ensure_ascii=False) + "\n")
            self.log.flush()
            if RESTART.search(line):
                self.restart_count += 1
                print("设备启动/重启：", line, flush=True)
                if startup:
                    self.ready_seen = False
                    self.status = None
                    continue
                self.restarted = True
                raise DeviceRestarted("串口出现重启或崩溃标记；已停止后续运动命令")
            if "GIMBAL ready" in line:
                self.ready_seen = True
                print("云台固件已就绪", flush=True)
            if "GIMBAL ERROR" in line or "GIMBAL STOP" in line:
                print(line, flush=True)
                if not startup:
                    raise RuntimeError("设备拒绝命令或安全停机；本次交互结束")
            if "GIMBAL {" in line:
                print(line[line.find("GIMBAL {"):], flush=True)
            return line
        return None

    @staticmethod
    def _event(line):
        start = line.find("GIMBAL {")
        if start < 0:
            return None
        try:
            event = json.loads(line[start + len("GIMBAL "):])
        except (ValueError, TypeError):
            raise CorruptReceipt("设备云台回执被串口回显打断") from None
        if not isinstance(event, dict) or not isinstance(event.get("event"), str):
            raise CorruptReceipt("设备云台回执缺少 event")
        return event

    @staticmethod
    def _check_status(status):
        if (status.get("event") != "status" or status.get("limits_us") != LIMITS or
                status.get("max_step_us") != 25 or status.get("max_age_ms") != 400 or
                status.get("lost_after_ms") != 1000):
            raise RuntimeError("固件不是本次 face stage 2 安全云台版本")
        for key in ("active", "pan_armed", "tilt_armed", "directions_ready",
                    "holding", "output_fault"):
            if type(status.get(key)) is not bool:
                raise RuntimeError(f"云台回执字段 {key} 无效")
        if (status["output_fault"] or
                any(type(status.get(key)) is not int for key in ("pan_us", "tilt_us")) or
                any(not LIMITS[0] <= status[key] <= LIMITS[1]
                    for key in ("pan_us", "tilt_us"))):
            raise RuntimeError("PWM 输出故障或脉宽越界；停止测试")
        return status

    def _write(self, *words):
        wire = "hv_gimbal " + " ".join(words) + "\r\n"
        if words[0] in ("arm", "jog", "start"):
            self.motion_sent = True
        self.device.write(wire.encode("ascii"))
        self.device.flush()

    def _drain(self):
        deadline = self.clock() + 0.12
        while True:
            line = self._read_line(deadline)
            if line is None:
                return
            try:
                self._event(line)
            except CorruptReceipt:
                self._recover_status()
                raise RuntimeError("上一条回执损坏；已只读复核，本次不发送新的运动命令") from None
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
