hecaojuanjuan/gesture-bridge/(commit log)

2026-10-24 feat: add HeadVoice phase-one prototype
2026-10-26 keep latest pose frames and add preview
2026-10-29 摄像头舵机连接1.0
2026-10-30 舵机安装定位
    [partitions.csv, servo-minimal-summary-20261030.json]
2026-10-31 自动居中（头和手势）尝试
2026-10-31 保存板端手部检测、分类器适配、控制面板及阶段成果
    [servo-p17-validation-20261031.json, servo-p18-user-confirmation-20261031.json]
2026-10-31 保存张掌与 V 字原生分类器、面板和实测检查点
2026-10-31 纠正小bug和自动居中代码测试1.0
2026-11-01 新增手势建库控制面板交互原型
2026-11-01 配网说明
    [gesture-bridge-milk-egg-v2.3mf, lower-shell.3mf, milk-egg-protective-cover-v3.3mf, milk-egg-protective-cover-v4.3mf, milk-egg-protective-cover-v5.3mf, milk-egg-protective-cover-v6-160mm.3mf, milk-egg-protective-cover-v7-100mm.3mf, milk_egg_body.3mf]
2026-11-01 方案说明
2026-11-01 完善 USB 手势工作台并细分语音会话启动失败原因
